SnoBotics981/CAD-FirstLibrary/README.md

# CAD-FirstLibrary
Part files retrieved from FIRST CAD library.
