SnoBotics981/CAD-FirstLibrary/Electrical/2004_RC/INV/Robot Controller Decal.bmp

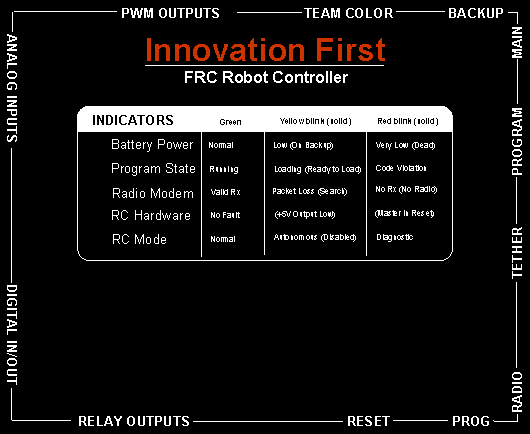
Electrical/2004_RC/INV/Robot Controller Decal.bmp
