SnoBotics981/CAD-FirstLibrary/Electrical/2005_RC/INV/Robot Controller.BMP

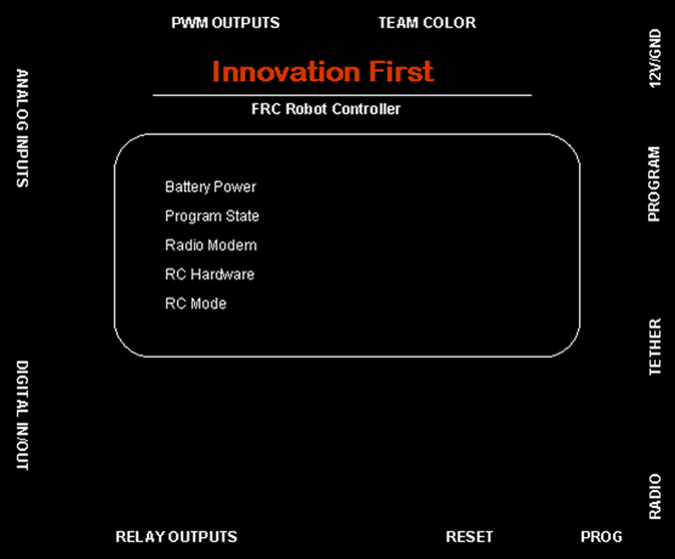
Electrical/2005_RC/INV/Robot Controller.BMP
