SnoBotics981/CAD-FirstLibrary/Electrical/Battery_Terminal/STEP/Battery Terminal Assembly.stp

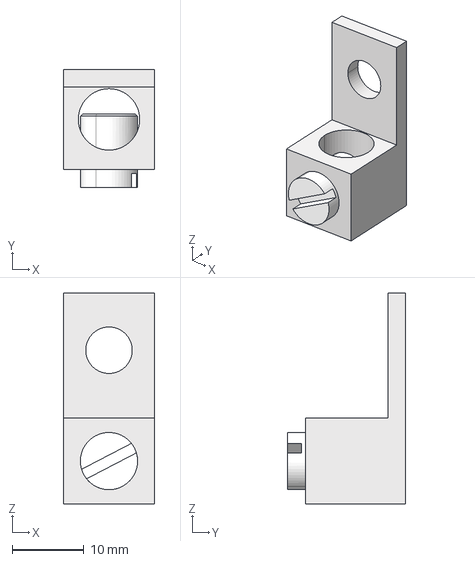
[picture p3: CAD file, 2018-06-28]
Electrical/Battery_Terminal/STEP/Battery Terminal Assembly.stp
12.8 x 16.5 x 29.5 mm
Battery Terminal
Battery Terminal Screw
