SnoBotics981/CAD-FirstLibrary/Mechanical/Linear_Slide/STEP/Drylin_N27_Assy.stp

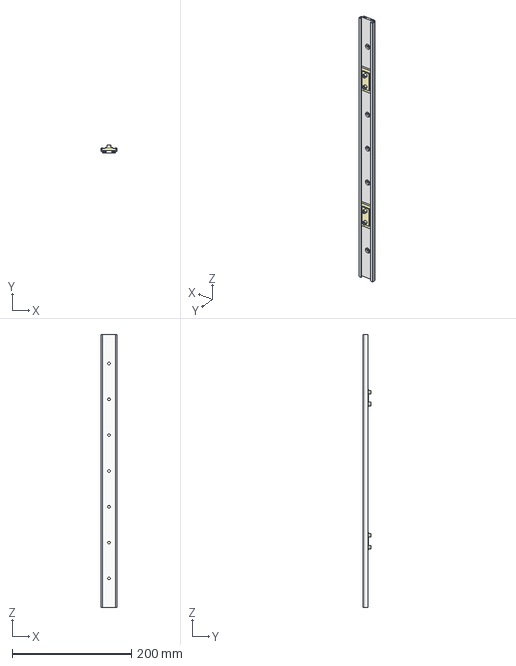
[picture p5: CAD file, 2018-06-28]
Mechanical/Linear_Slide/STEP/Drylin_N27_Assy.stp
27.0 x 13.9 x 457.2 mm
DryLin_N27_Rail
Drylin_N27_Slide x 2
