SnoBotics981/CAD-FirstLibrary/Pneumatic/Festo_Valve/STEP/Festo Valve Assembly.stp

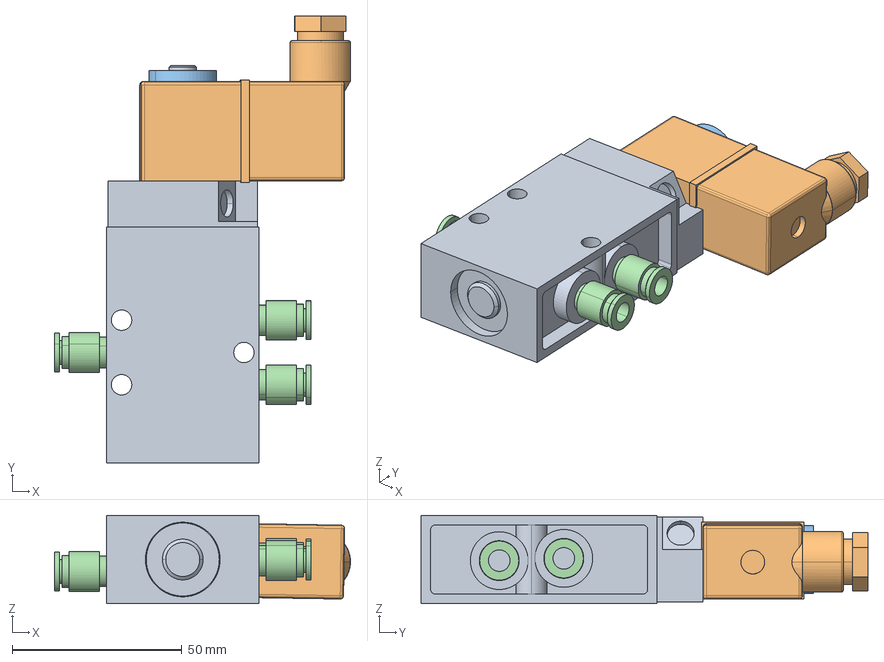
[picture p6: CAD file, 2018-06-28]
Pneumatic/Festo_Valve/STEP/Festo Valve Assembly.stp
87.1 x 131.5 x 26.0 mm
Festo Valve
Festo Solenoid
Festo Solenoid Nut
Festo Port Fitting x 3
