SnoBotics981/CAD-FirstLibrary/Bearings/1.2_Bearing/STEP/br-8.stp

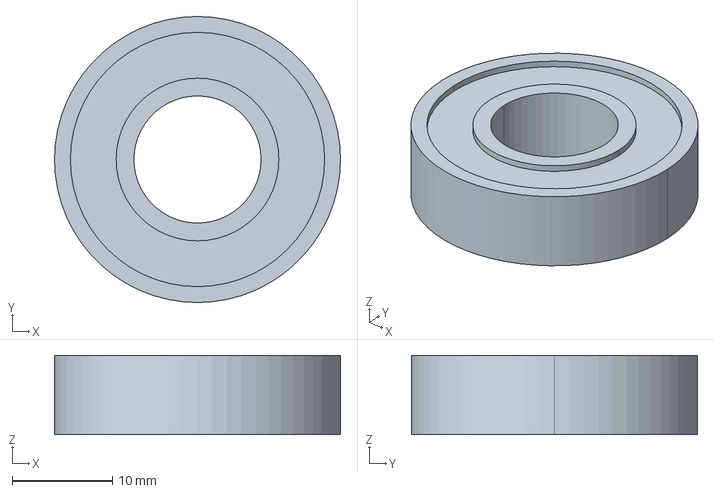
[picture p7: CAD file, 2018-06-28]
Bearings/1.2_Bearing/STEP/br-8.stp
28.6 x 28.6 x 7.94 mm
