SnoBotics981/CAD-FirstLibrary/Bearings/1.2_Flanged/STEP/brf-08.stp

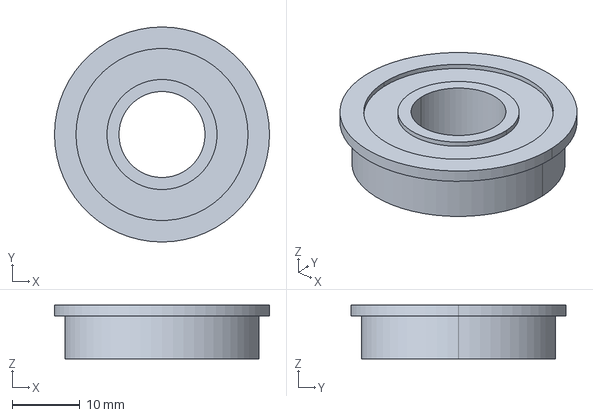
[picture p8: CAD file, 2018-06-28]
Bearings/1.2_Flanged/STEP/brf-08.stp
31.8 x 31.8 x 7.94 mm
