SnoBotics981/CAD-FirstLibrary/Bearings/1.2_Spherical/STEP/bearingspherical0500.stp

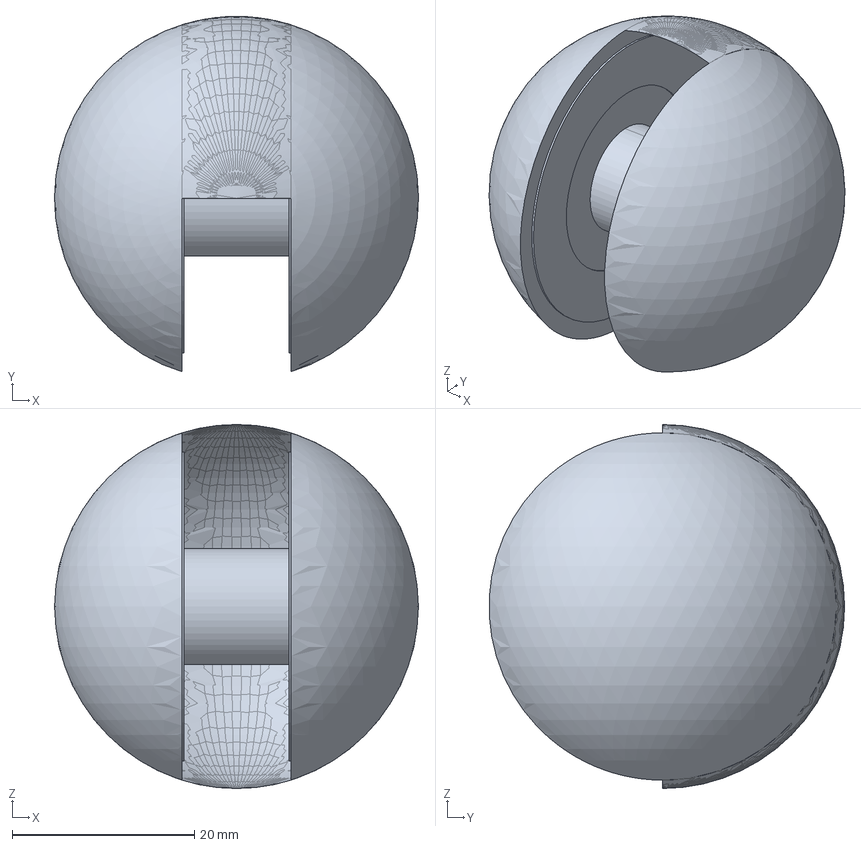
[picture p9: CAD file, 2018-06-28]
Bearings/1.2_Spherical/STEP/bearingspherical0500.stp
40.0 x 39.0 x 40.0 mm
