SnoBotics981/CAD-FirstLibrary/Bearings/1.4_Bearing/STEP/br-4.stp

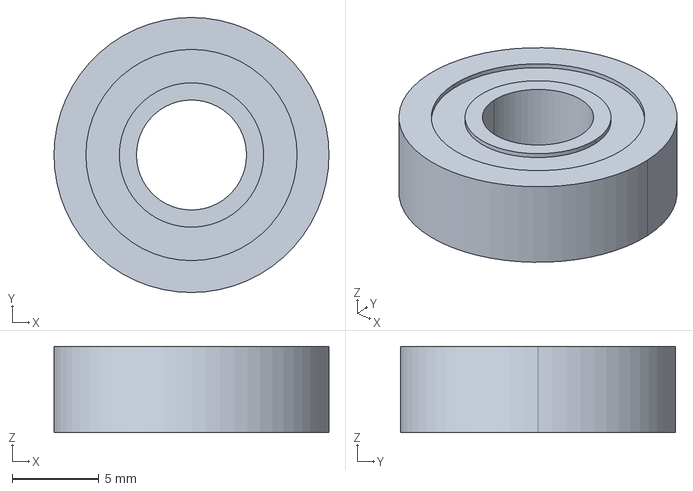
[picture p10: CAD file, 2018-06-28]
Bearings/1.4_Bearing/STEP/br-4.stp
15.9 x 15.9 x 4.98 mm
