SnoBotics981/CAD-FirstLibrary/Bearings/1.4_Flanged/STEP/brf-04.stp

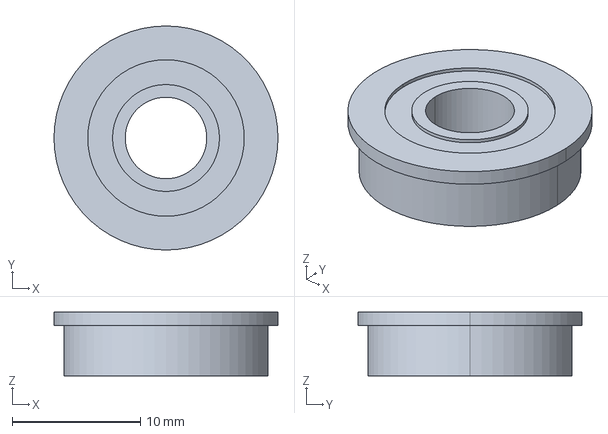
[picture p11: CAD file, 2018-06-28]
Bearings/1.4_Flanged/STEP/brf-04.stp
17.4 x 17.4 x 4.98 mm
