SnoBotics981/CAD-FirstLibrary/Bearings/12_Lazy_Susan/STEP/Lazy Susan Bearing.stp

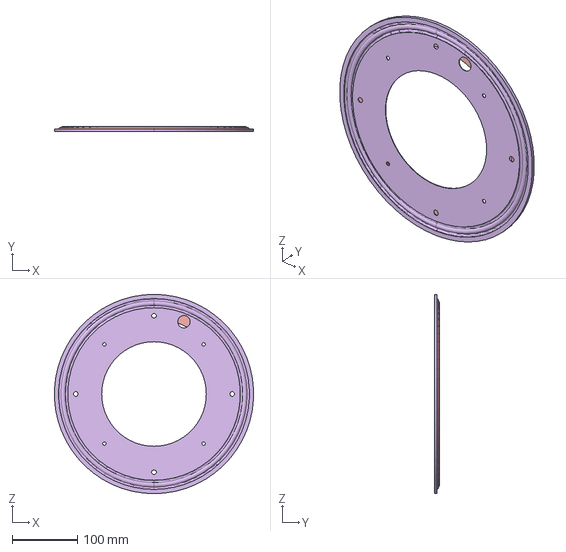
[picture p12: CAD file, 2018-06-28]
Bearings/12_Lazy_Susan/STEP/Lazy Susan Bearing.stp
306.0 x 7.95 x 306.4 mm
