SnoBotics981/CAD-FirstLibrary/Bearings/1_Bearing/STEP/RJI-01-16 Drylin R Bearing.stp

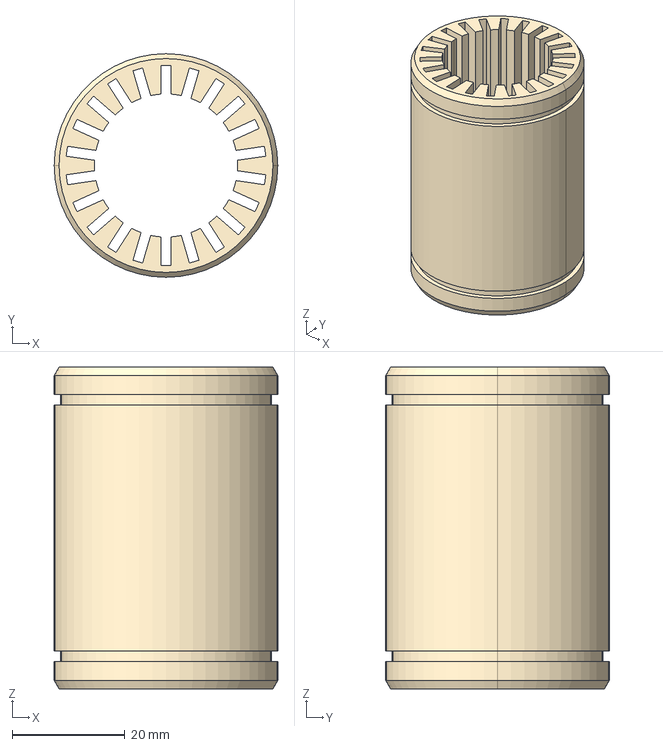
[picture p13: CAD file, 2018-06-28]
Bearings/1_Bearing/STEP/RJI-01-16 Drylin R Bearing.stp
39.7 x 39.7 x 57.2 mm
