SnoBotics981/CAD-FirstLibrary/Bearings/3.8_Bearing/STEP/br-6.stp

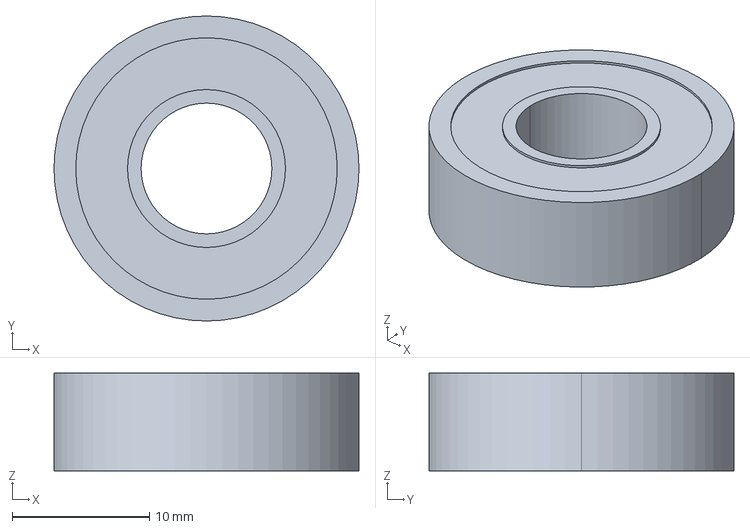
[picture p14: CAD file, 2018-06-28]
Bearings/3.8_Bearing/STEP/br-6.stp
22.2 x 22.2 x 7.11 mm
