SnoBotics981/CAD-FirstLibrary/Bearings/3.8_Flanged/STEP/brf-06.stp

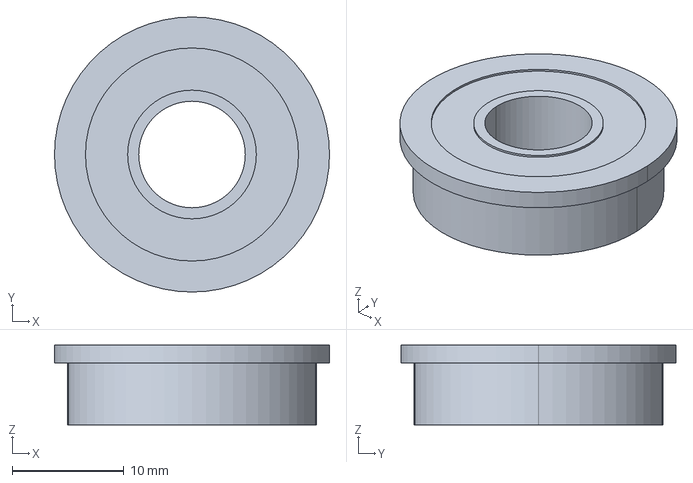
[picture p15: CAD file, 2018-06-28]
Bearings/3.8_Flanged/STEP/brf-06.stp
24.6 x 24.6 x 7.11 mm
