SnoBotics981/CAD-FirstLibrary/Bearings/5.8_Bearing/STEP/BR-10.stp

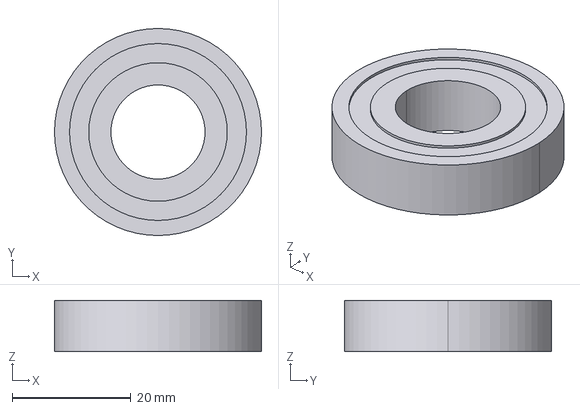
[picture p16: CAD file, 2018-06-28]
Bearings/5.8_Bearing/STEP/BR-10.stp
34.9 x 34.9 x 8.67 mm
