SnoBotics981/CAD-FirstLibrary/Bearings/Bearing_Flangette/STEP/selfaligningflange.stp

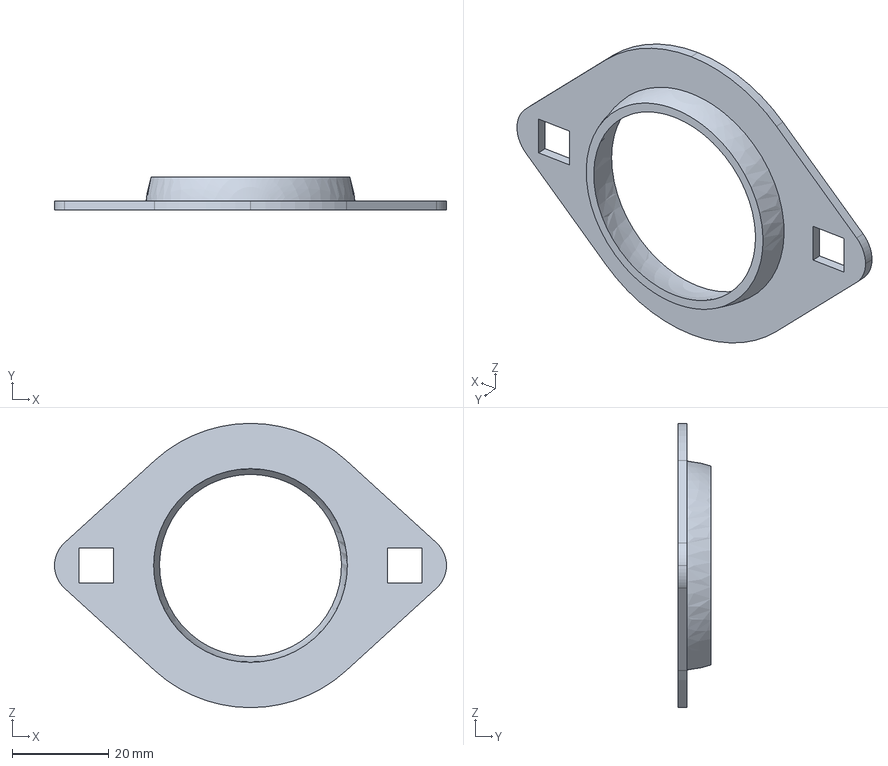
[picture p17: CAD file, 2018-06-28]
Bearings/Bearing_Flangette/STEP/selfaligningflange.stp
80.9 x 6.87 x 58.7 mm
