SnoBotics981/CAD-FirstLibrary/Bearings/Linear_Bearing_1.2/STEP/linearbearing.stp

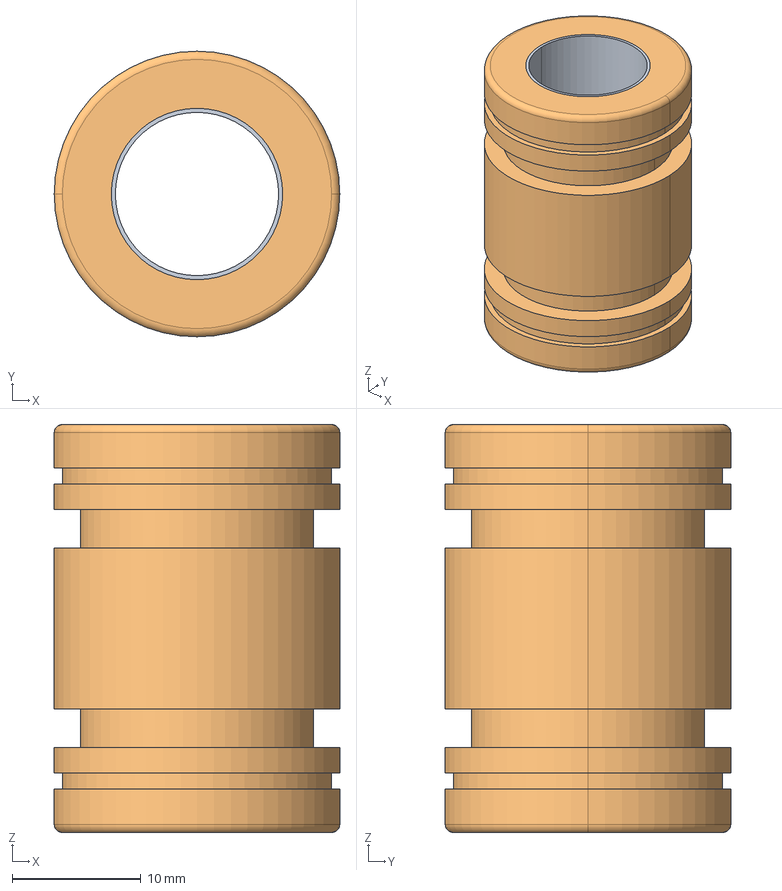
[picture p18: CAD file, 2018-06-28]
Bearings/Linear_Bearing_1.2/STEP/linearbearing.stp
22.2 x 22.2 x 31.8 mm
linearbearing1
linearbearing2
