SnoBotics981/CAD-FirstLibrary/Bearings/Locking_Collar/STEP/bearinglockingcollar.stp

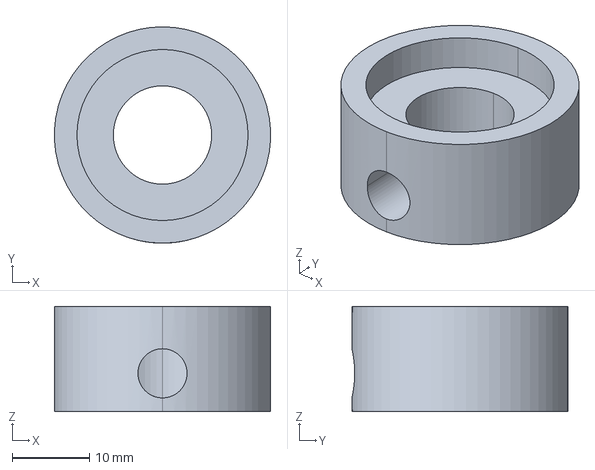
[picture p19: CAD file, 2018-06-28]
Bearings/Locking_Collar/STEP/bearinglockingcollar.stp
27.9 x 27.9 x 13.6 mm
