SnoBotics981/CAD-FirstLibrary/Bearings/Thrust_Bearing/STEP/Thrust Bearing.stp

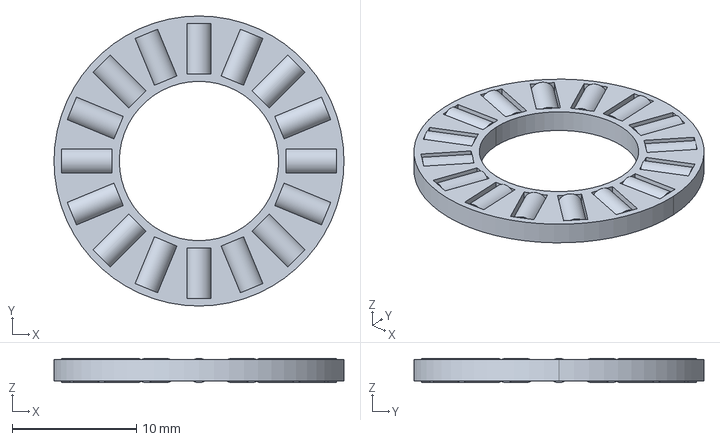
[picture p20: CAD file, 2018-06-28]
Bearings/Thrust_Bearing/STEP/Thrust Bearing.stp
23.3 x 23.3 x 1.95 mm
