SnoBotics981/CAD-FirstLibrary/Bushings/1_x_1_Bearing/STEP/JFI-1618-16 Iglide J Bearing.stp

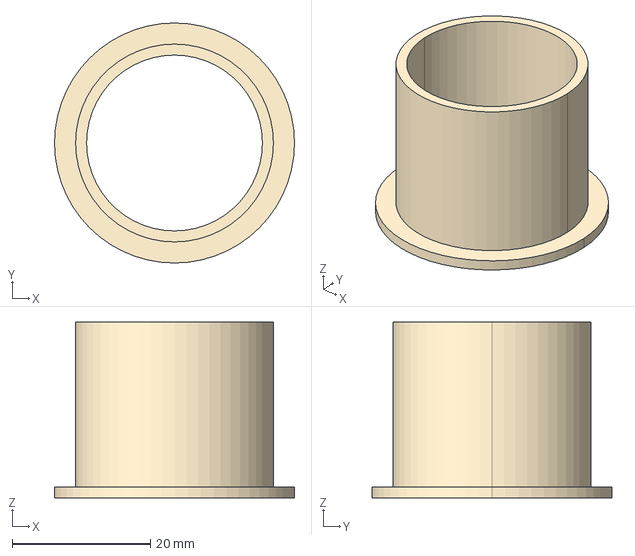
[picture p21: CAD file, 2018-06-28]
Bushings/1_x_1_Bearing/STEP/JFI-1618-16 Iglide J Bearing.stp
34.7 x 34.7 x 25.4 mm
