SnoBotics981/CAD-FirstLibrary/Bushings/1x_1_Bearing/STEP/JSI-1618-16 Iglide J Bearing.stp

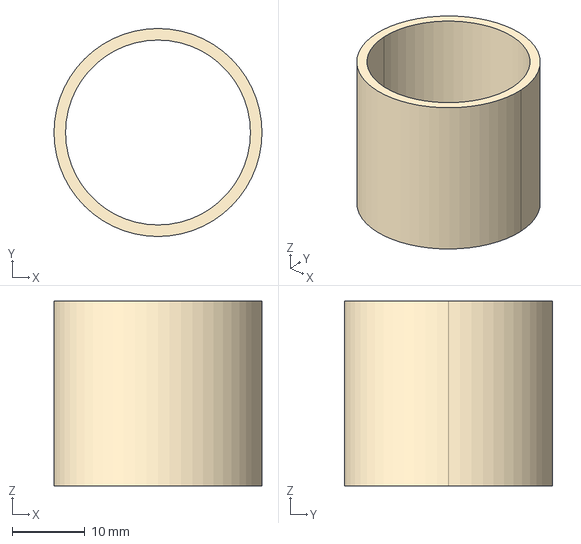
[picture p22: CAD file, 2018-06-28]
Bushings/1x_1_Bearing/STEP/JSI-1618-16 Iglide J Bearing.stp
28.6 x 28.6 x 25.4 mm
