SnoBotics981/CAD-FirstLibrary/Bushings/5.8x_3.4_Bearing/STEP/JFI-1012-12 Iglide J Bearing.stp

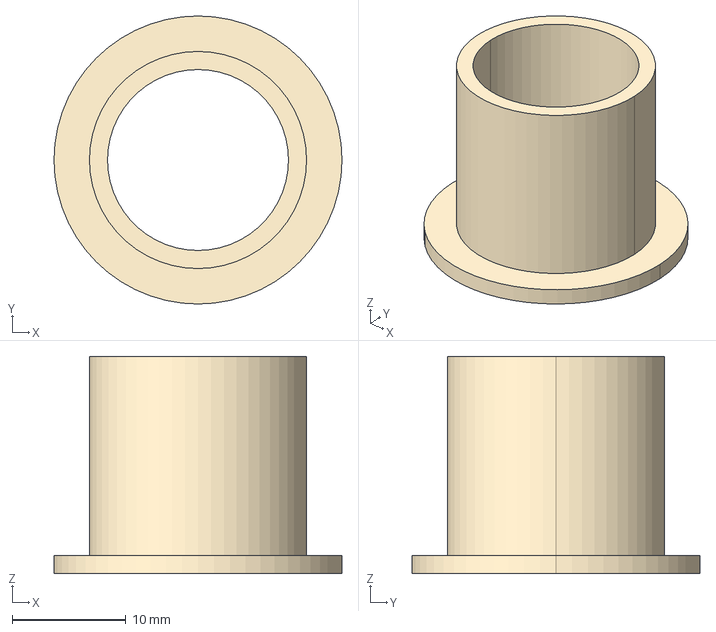
[picture p23: CAD file, 2018-06-28]
Bushings/5.8x_3.4_Bearing/STEP/JFI-1012-12 Iglide J Bearing.stp
25.3 x 25.3 x 19.1 mm
