SnoBotics981/CAD-FirstLibrary/Bushings/Flange_Bushing/STEP/bushing-fbb-8-12.stp

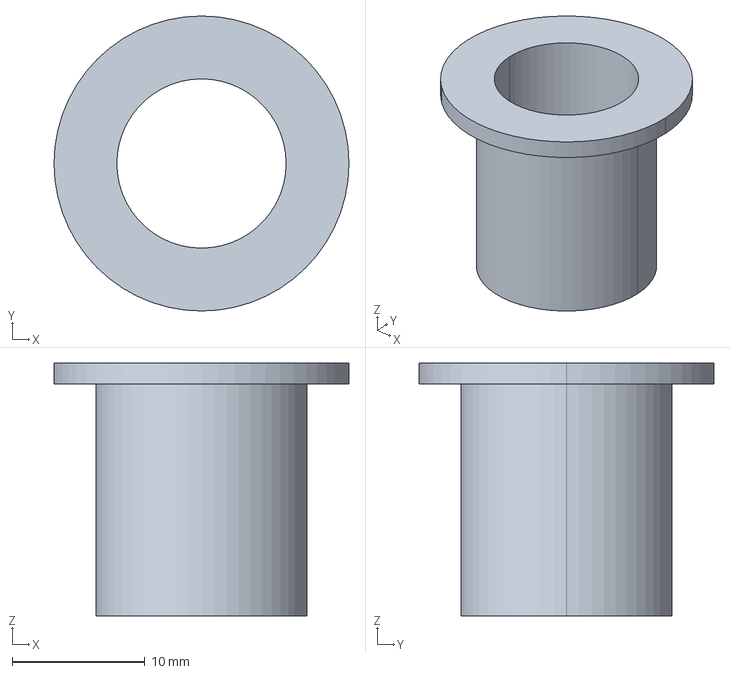
[picture p24: CAD file, 2018-06-28]
Bushings/Flange_Bushing/STEP/bushing-fbb-8-12.stp
22.2 x 22.2 x 19.1 mm
