SnoBotics981/CAD-FirstLibrary/Bushings/Rulon_J_Bushing/STEP/bushing-fbp-6-8.stp

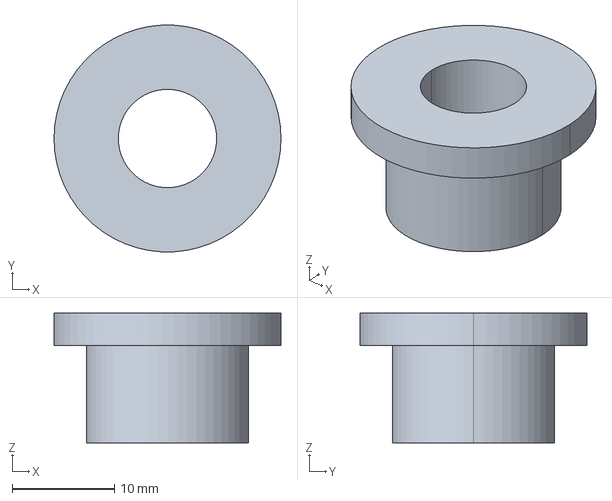
[picture p25: CAD file, 2018-06-28]
Bushings/Rulon_J_Bushing/STEP/bushing-fbp-6-8.stp
22.2 x 22.2 x 12.7 mm
