SnoBotics981/CAD-FirstLibrary/Bushings/Thrust_Bushing/STEP/bushing-tbb-8-16.stp

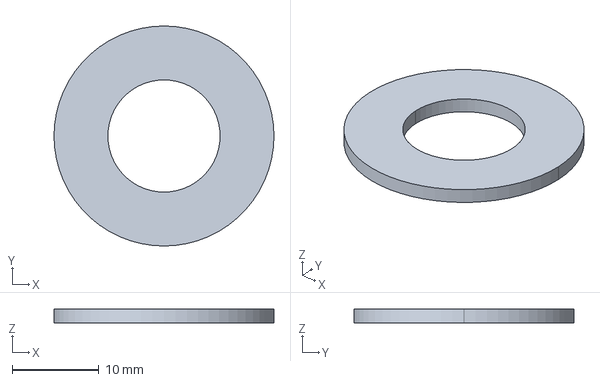
[picture p26: CAD file, 2018-06-28]
Bushings/Thrust_Bushing/STEP/bushing-tbb-8-16.stp
25.4 x 25.4 x 1.56 mm
