SnoBotics981/CAD-FirstLibrary/Electrical/10_Turn_Pot/STEP/Bourns3540.stp

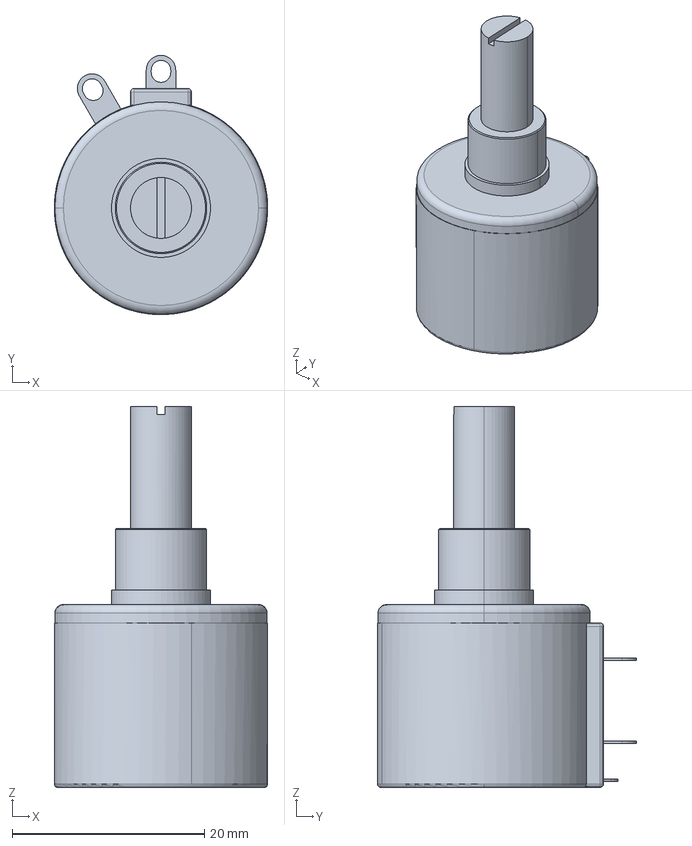
[picture p27: CAD file, 2018-06-28]
Electrical/10_Turn_Pot/STEP/Bourns3540.stp
22.2 x 27.0 x 39.7 mm
