SnoBotics981/CAD-FirstLibrary/Electrical/120A_Breaker/STEP/Breaker.stp

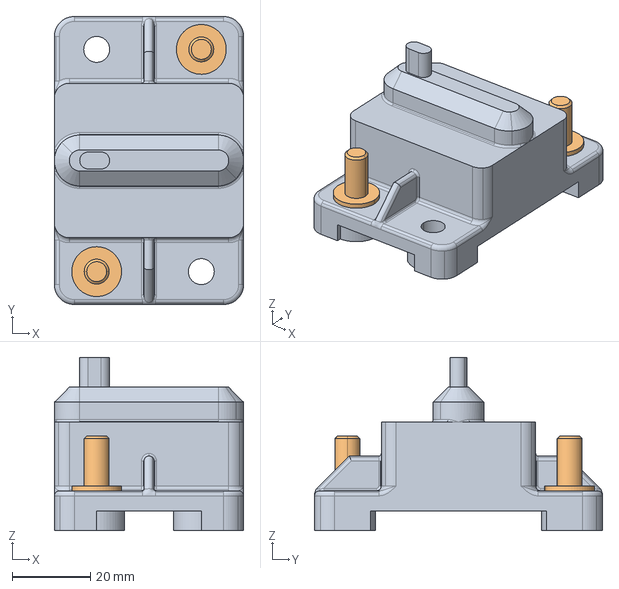
[picture p28: CAD file, 2018-06-28]
Electrical/120A_Breaker/STEP/Breaker.stp
48.3 x 73.4 x 44.2 mm
Breaker
Breaker Post x 2
