SnoBotics981/CAD-FirstLibrary/Electrical/14_Pin_IC_Socket/STEP/14 Pin IC Socket.stp

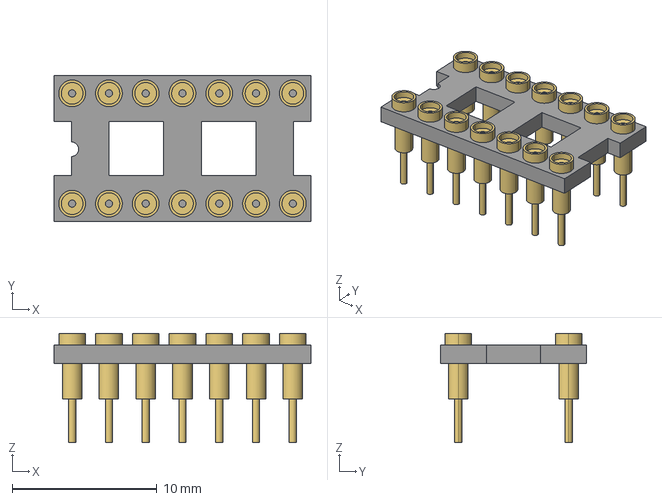
[picture p29: CAD file, 2018-06-28]
Electrical/14_Pin_IC_Socket/STEP/14 Pin IC Socket.stp
17.8 x 10.1 x 7.55 mm
14 Pin Socket Substrate
IC Socket Pin x 14
