SnoBotics981/CAD-FirstLibrary/Electrical/16_Pin_IC_Socket/STEP/16 Pin IC Socket.stp

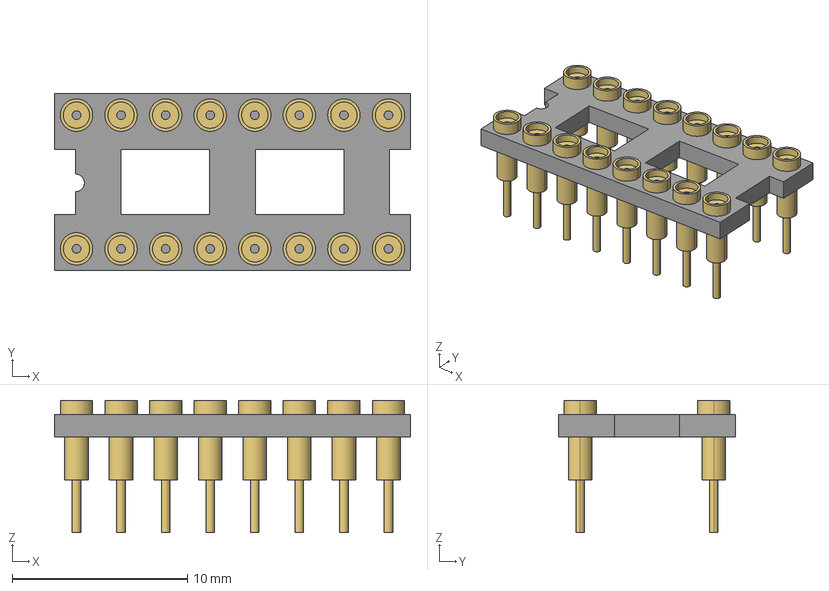
[picture p30: CAD file, 2018-06-28]
Electrical/16_Pin_IC_Socket/STEP/16 Pin IC Socket.stp
20.3 x 10.1 x 7.55 mm
16 Pin Socket Substrate
IC Socket Pin x 16
