SnoBotics981/CAD-FirstLibrary/Electrical/18_Pin_IC_Socket/STEP/18 Pin IC Socket.stp

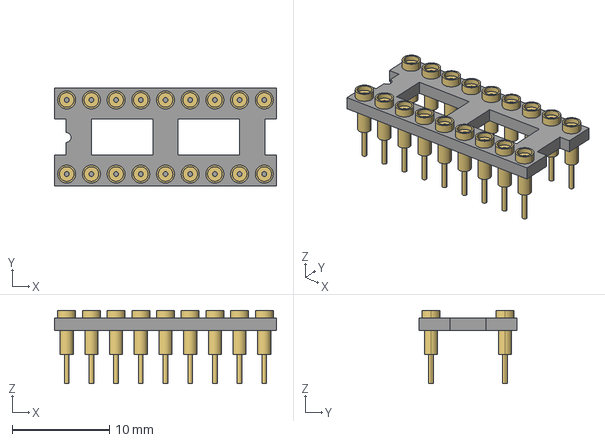
[picture p31: CAD file, 2018-06-28]
Electrical/18_Pin_IC_Socket/STEP/18 Pin IC Socket.stp
22.8 x 10.1 x 7.55 mm
18 Pin Socket Substrate
IC Socket Pin x 18
