SnoBotics981/CAD-FirstLibrary/Electrical/2005_OI/STEP/Operator Interface.stp

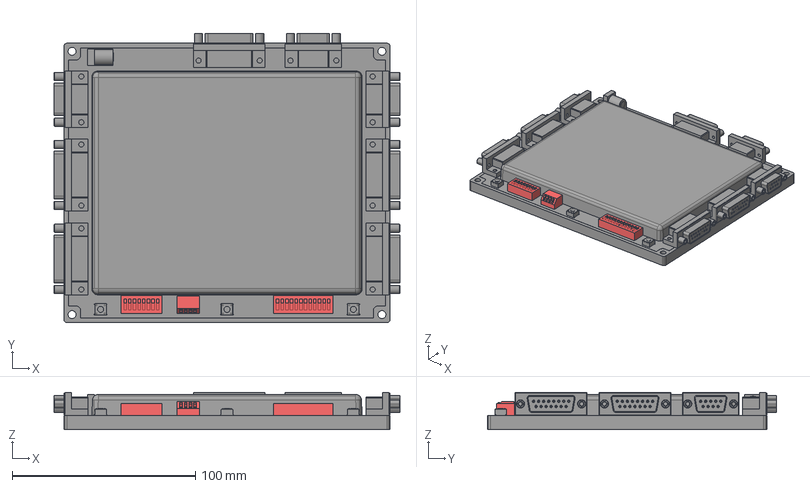
[picture p33: CAD file, 2018-06-28]
Electrical/2005_OI/STEP/Operator Interface.stp
188.6 x 157.8 x 20.3 mm
Operator Interface Back Cover
Operator Interface PCB
Operator Interface Top Cover
8 Position DIP Switch
12 Position DIP Switch
Operator Interface 15F Dshell x 5
Operator Interface 9F Dshell x 2
Operator Interface 9M Dshell
PCB PB Switch x 3
4 Position Dip Switch
Operator Interface Power Connector
