SnoBotics981/CAD-FirstLibrary/Electrical/2005_RC/STEP/Robot Controller.stp

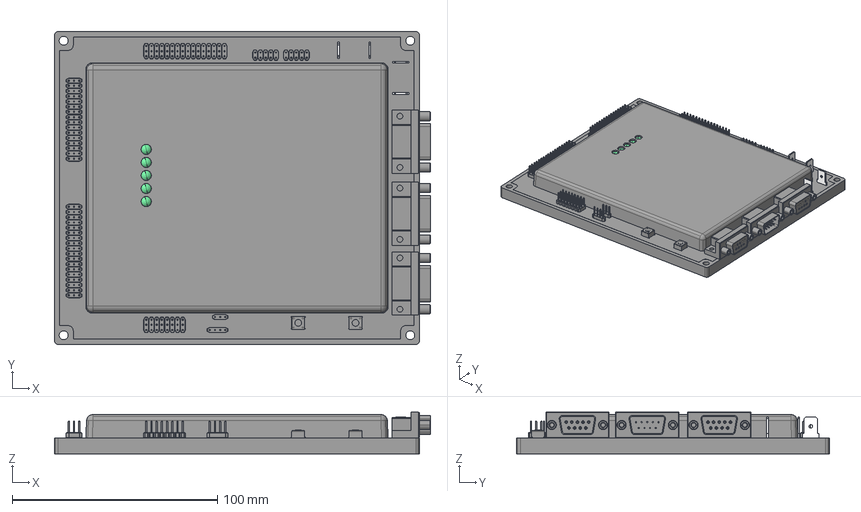
[picture p34: CAD file, 2018-06-28]
Electrical/2005_RC/STEP/Robot Controller.stp
183.2 x 152.4 x 20.3 mm
Robot Controller Back Cover
Robot Controller PCB
4 Pin Connector
Robot Controller Top Cover
Robot Controller 9F Dshell x 2
Robot Controller 9M Dshell
3 Pin Connector x 59
2 Pin Connector x 10
PCB PB Switch x 2
LED - Green x 5
Robot Controller Male Terminal x 4
