SnoBotics981/CAD-FirstLibrary/Electrical/2005_Spike_Relay/STEP/Spike H.stp

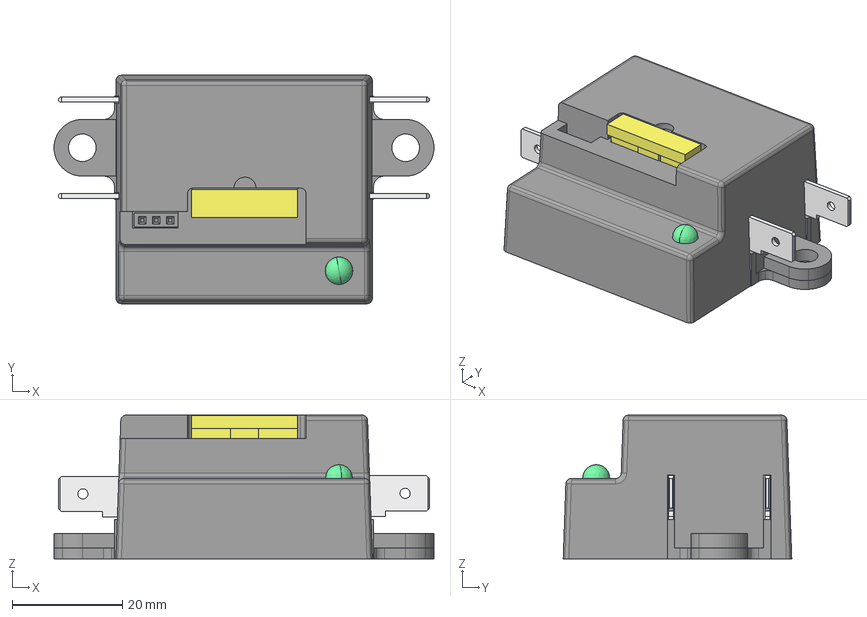
[picture p35: CAD file, 2018-06-28]
Electrical/2005_Spike_Relay/STEP/Spike H.stp
69.0 x 41.5 x 26.1 mm
Spike Bottom Cover
Spike PCB
Spike Female Terminal x 2
1x3 Header Connector
Spike Male Terminal x 4
ATO Fuse
Spike Top Cover
LED - Green
