SnoBotics981/CAD-FirstLibrary/Electrical/2008_IR_Board/STEP/2008 IR Board.stp

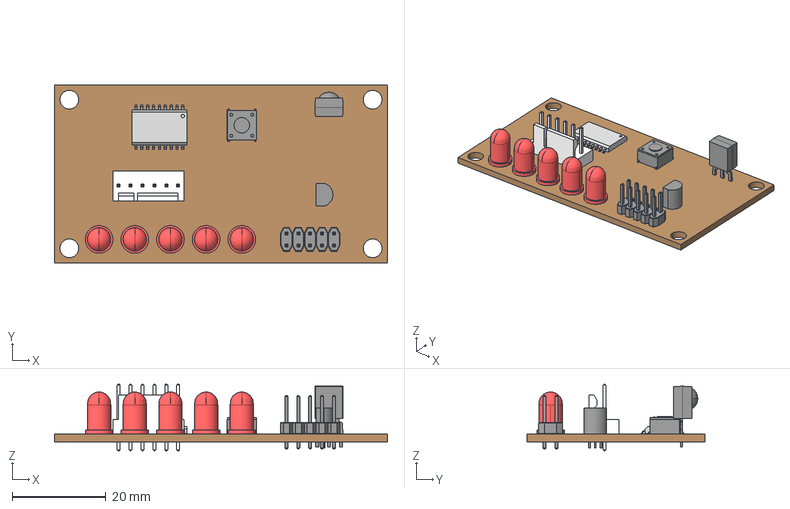
[picture p36: CAD file, 2018-06-28]
Electrical/2008_IR_Board/STEP/2008 IR Board.stp
71.1 x 38.1 x 14.2 mm
2008 IR PC Board
LED - Red x 5
2 Pin Connector x 5
PCB PB Switch
18 Pin SMT
6 Pin Connector
Vishay IR Sensor
5 Volt Regulator
