SnoBotics981/CAD-FirstLibrary/Electrical/20_Pin_IC_Socket/STEP/20 Pin IC Socket.stp

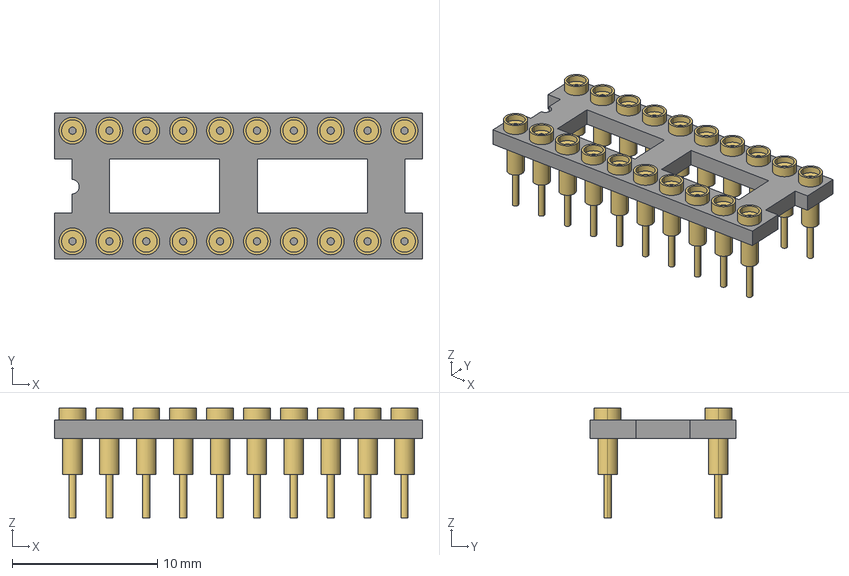
[picture p37: CAD file, 2018-06-28]
Electrical/20_Pin_IC_Socket/STEP/20 Pin IC Socket.stp
25.3 x 10.1 x 7.55 mm
20 Pin Socket Substrate
IC Socket Pin x 20
