SnoBotics981/CAD-FirstLibrary/Electrical/24_Pin_IC_Socket/STEP/24 Pin IC Socket.stp

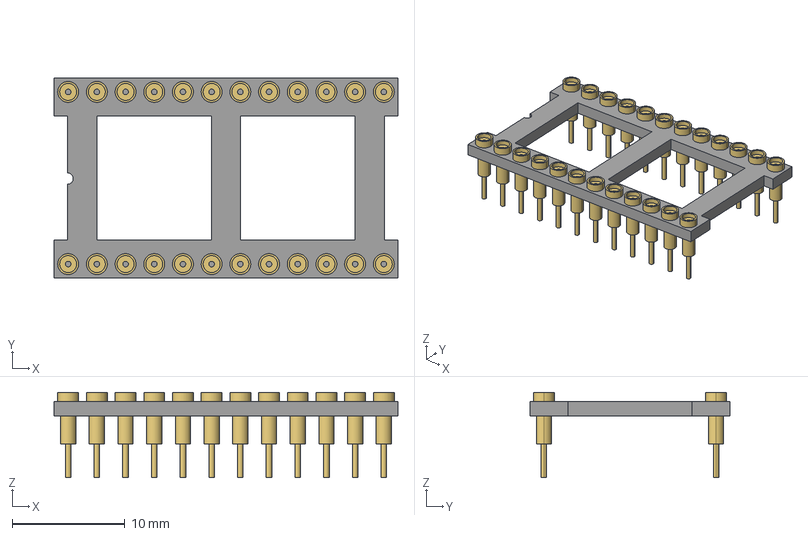
[picture p38: CAD file, 2018-06-28]
Electrical/24_Pin_IC_Socket/STEP/24 Pin IC Socket.stp
30.5 x 17.7 x 7.55 mm
24 Pin Socket Substrate
IC Socket Pin x 24
