SnoBotics981/CAD-FirstLibrary/Electrical/28_Pin_IC_Socket/STEP/28 Pin IC Socket.stp

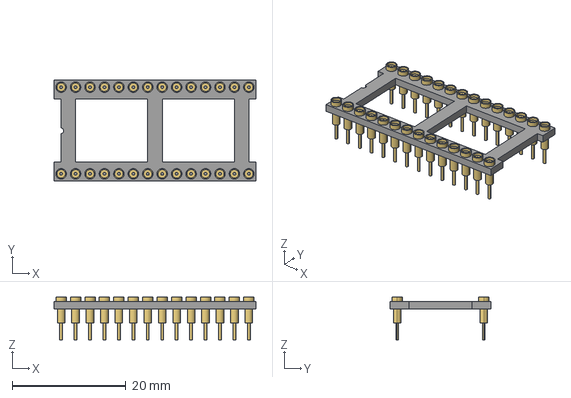
[picture p39: CAD file, 2018-06-28]
Electrical/28_Pin_IC_Socket/STEP/28 Pin IC Socket.stp
35.5 x 17.7 x 7.55 mm
28 Pin Socket Substrate
IC Socket Pin x 28
