SnoBotics981/CAD-FirstLibrary/Electrical/37_Pin_Connector/STEP/37 Pin Connector.stp

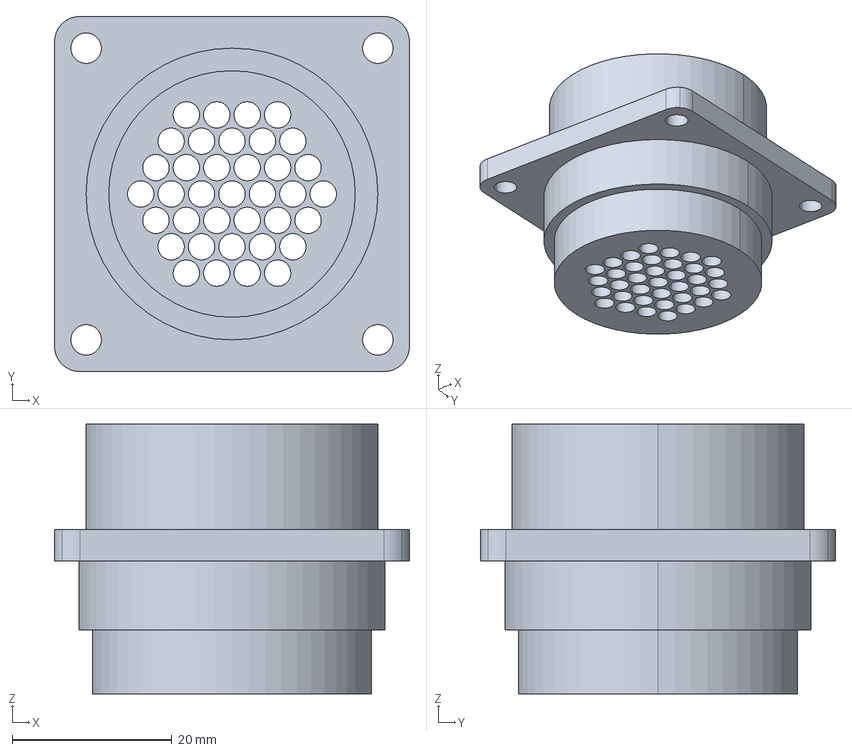
[picture p40: CAD file, 2018-06-28]
Electrical/37_Pin_Connector/STEP/37 Pin Connector.stp
44.5 x 44.5 x 33.8 mm
