SnoBotics981/CAD-FirstLibrary/Electrical/3_Pin_Connector/STEP/3 Pin Connector.stp

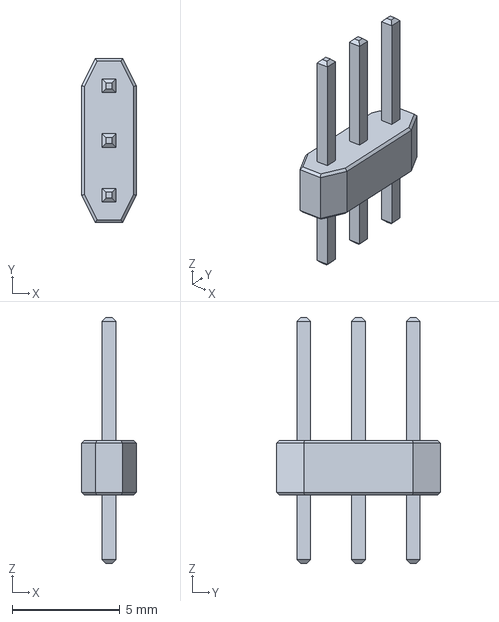
[picture p41: CAD file, 2018-06-28]
Electrical/3_Pin_Connector/STEP/3 Pin Connector.stp
2.54 x 7.62 x 11.4 mm
