SnoBotics981/CAD-FirstLibrary/Electrical/3x2x1_Box/STEP/Enclosure1801.stp

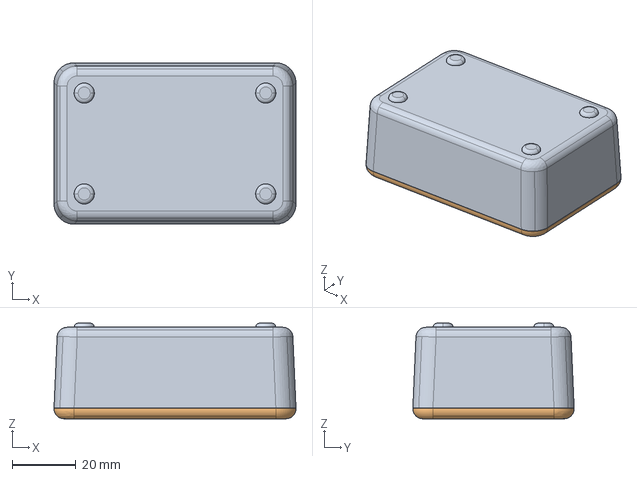
[picture p42: CAD file, 2018-06-28]
Electrical/3x2x1_Box/STEP/Enclosure1801.stp
76.2 x 50.8 x 30.1 mm
Enclosure1801
Enclosure1801-Cover
