SnoBotics981/CAD-FirstLibrary/Electrical/4x2x1_Box/STEP/Enclosure1802.stp

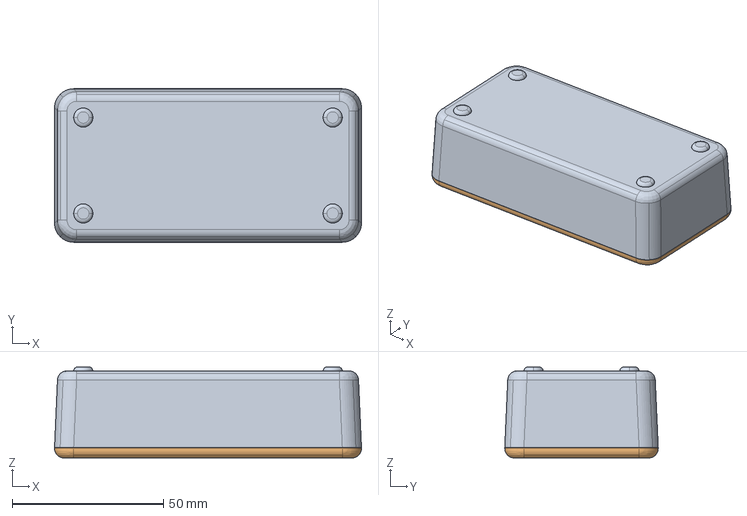
[picture p43: CAD file, 2018-06-28]
Electrical/4x2x1_Box/STEP/Enclosure1802.stp
101.6 x 50.8 x 30.1 mm
Enclosure1802
Enclosure1802-Cover
