SnoBotics981/CAD-FirstLibrary/Electrical/5x2.5x2_Box/STEP/Enclosure1803.stp

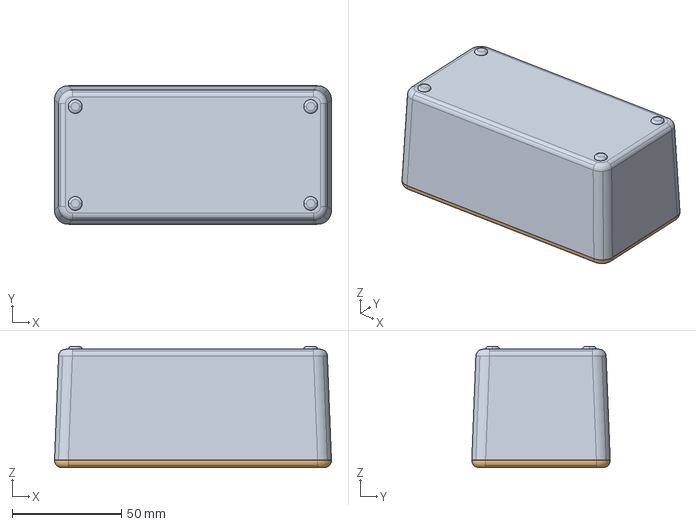
[picture p44: CAD file, 2018-06-28]
Electrical/5x2.5x2_Box/STEP/Enclosure1803.stp
127.0 x 63.5 x 55.5 mm
Enclosure1803
Enclosure1803-Cover
