SnoBotics981/CAD-FirstLibrary/Electrical/Accelerometer/STEP/Accelerometer.stp

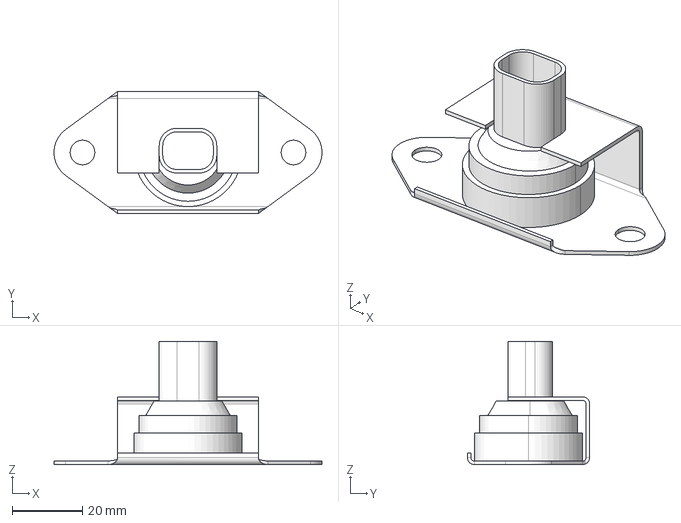
[picture p45: CAD file, 2018-06-28]
Electrical/Accelerometer/STEP/Accelerometer.stp
76.2 x 34.8 x 35.0 mm
