SnoBotics981/CAD-FirstLibrary/Electrical/ATO_Fuse/STEP/ATO Fuse.stp

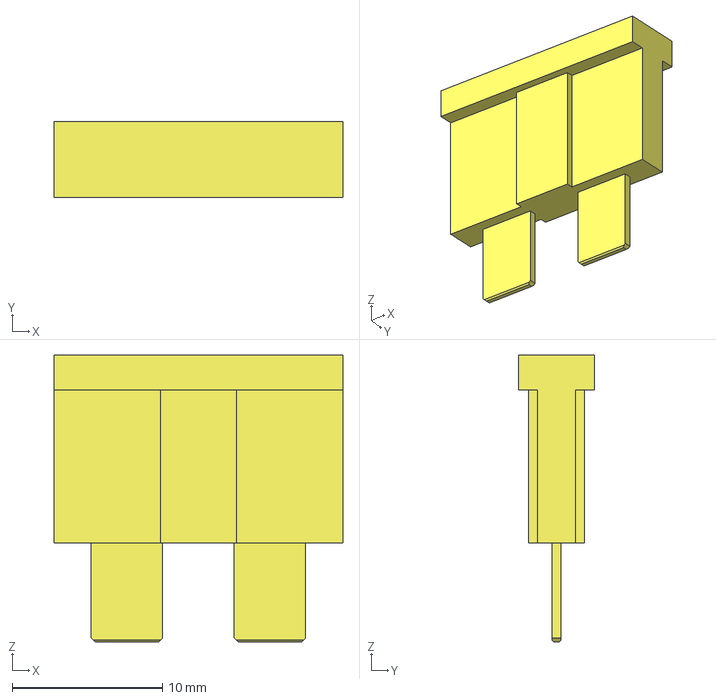
[picture p46: CAD file, 2018-06-28]
Electrical/ATO_Fuse/STEP/ATO Fuse.stp
19.2 x 5.08 x 19.1 mm
