SnoBotics981/CAD-FirstLibrary/Electrical/Battery/STEP/battery.stp

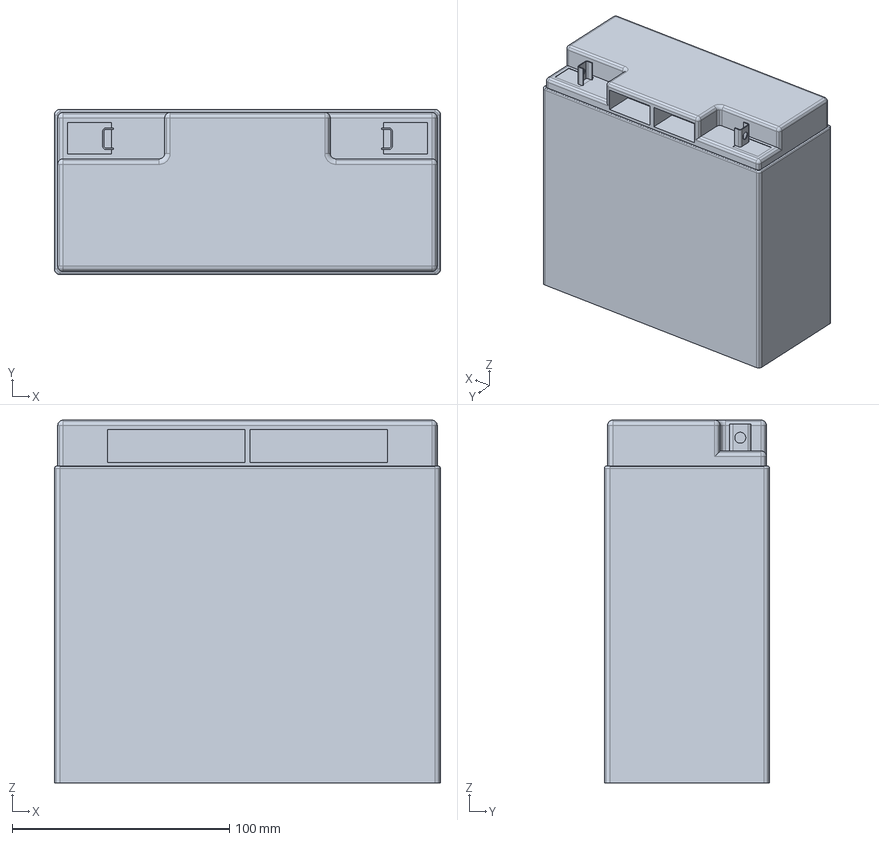
[picture p47: CAD file, 2018-06-28]
Electrical/Battery/STEP/battery.stp
177.8 x 76.2 x 167.1 mm
