SnoBotics981/CAD-FirstLibrary/Electrical/Circuit_Breaker/STEP/Circuit Breaker.stp

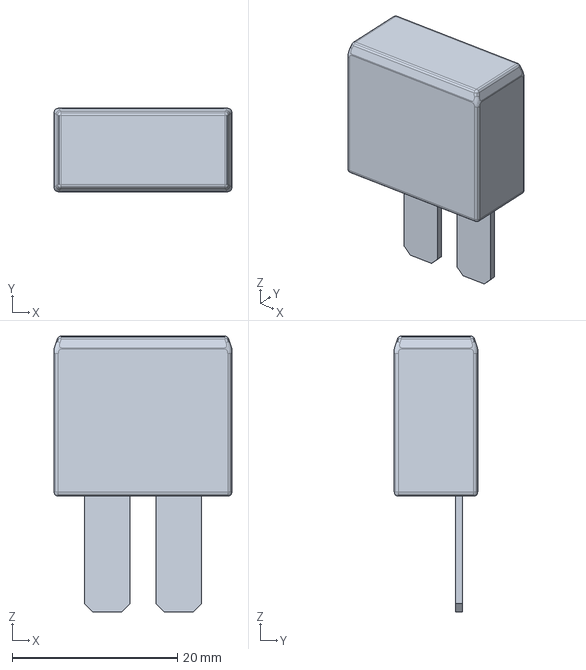
[picture p49: CAD file, 2018-06-28]
Electrical/Circuit_Breaker/STEP/Circuit Breaker.stp
21.5 x 10.1 x 33.4 mm
