SnoBotics981/CAD-FirstLibrary/Electrical/CMU_Camera/STEP/CMU Camera.stp

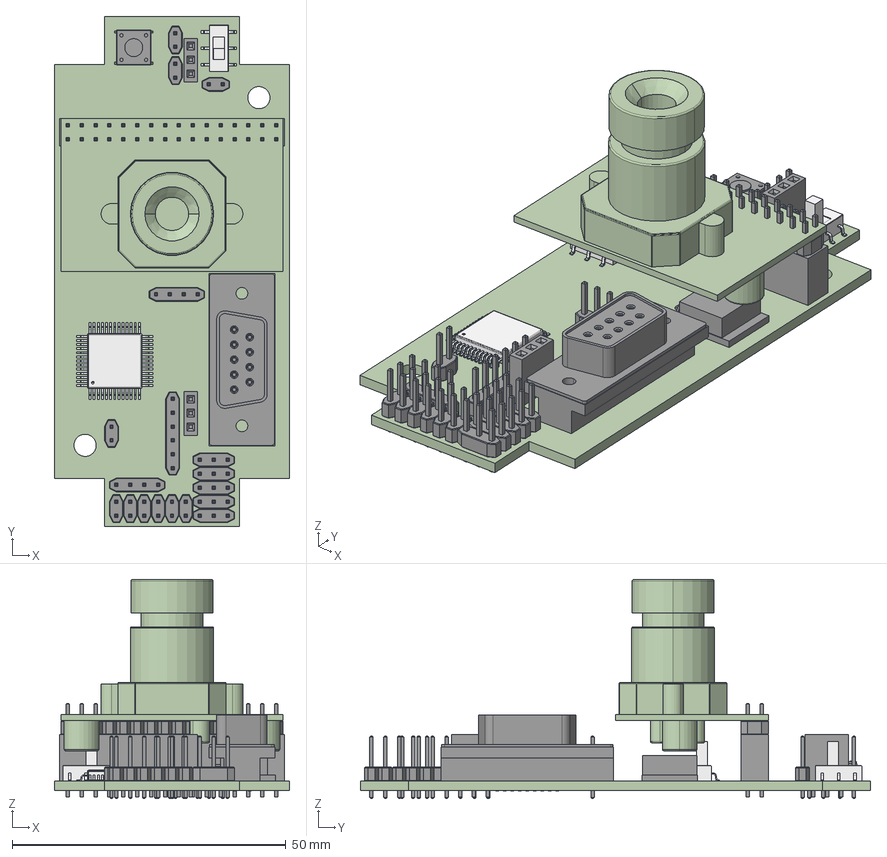
[picture p50: CAD file, 2018-06-28]
Electrical/CMU_Camera/STEP/CMU Camera.stp
42.9 x 93.2 x 40.0 mm
CMU Camera PCB
2x16 Header Connector
Lens Module
2 Pin Connector x 26
PCB PB Switch
4 Pin Connector x 2
3 Pin Connector x 5
Voltage Regulator
CMU Camera 9F Dshell
1x3 Header Connector x 2
6 Pin Connector
28 Pin IC
CPU
Slide Switch
