SnoBotics981/CAD-FirstLibrary/Electrical/DEC_Gyro_Sensor/STEP/Gyro Sensor.stp

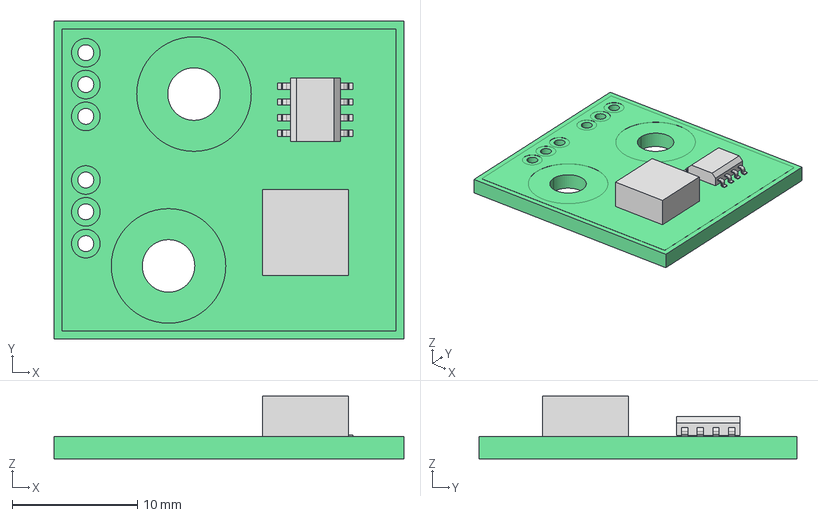
[picture p51: CAD file, 2018-06-28]
Electrical/DEC_Gyro_Sensor/STEP/Gyro Sensor.stp
27.9 x 25.4 x 5.03 mm
Gyro PCB
Gyro Chip
8 Pin SMT
