SnoBotics981/CAD-FirstLibrary/Electrical/Dual_Clinometer/STEP/Clinometer.stp

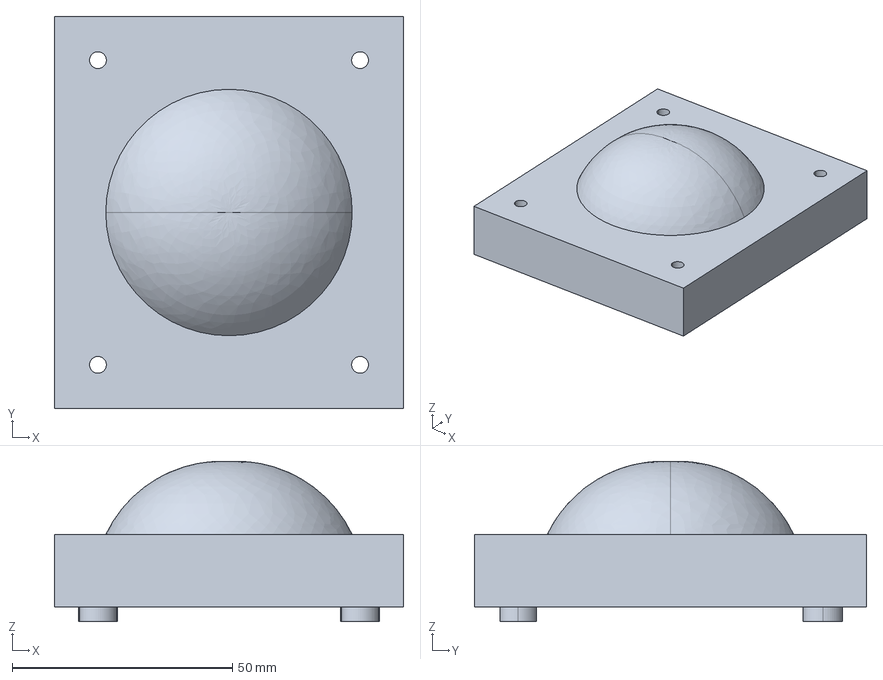
[picture p52: CAD file, 2018-06-28]
Electrical/Dual_Clinometer/STEP/Clinometer.stp
79.2 x 88.9 x 36.4 mm
