SnoBotics981/CAD-FirstLibrary/Electrical/Grayhill_Encoder/STEP/Encoder.stp

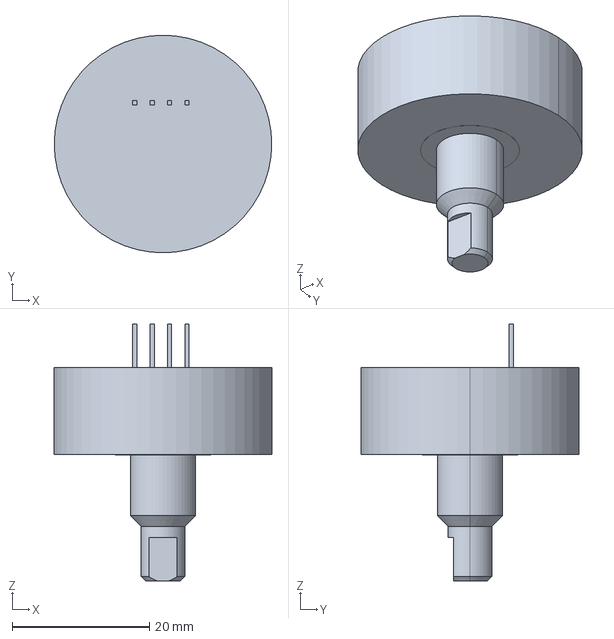
[picture p53: CAD file, 2018-06-28]
Electrical/Grayhill_Encoder/STEP/Encoder.stp
31.8 x 31.8 x 37.5 mm
