SnoBotics981/CAD-FirstLibrary/Electrical/Ground_Terminal/STEP/Ground Terminal.stp

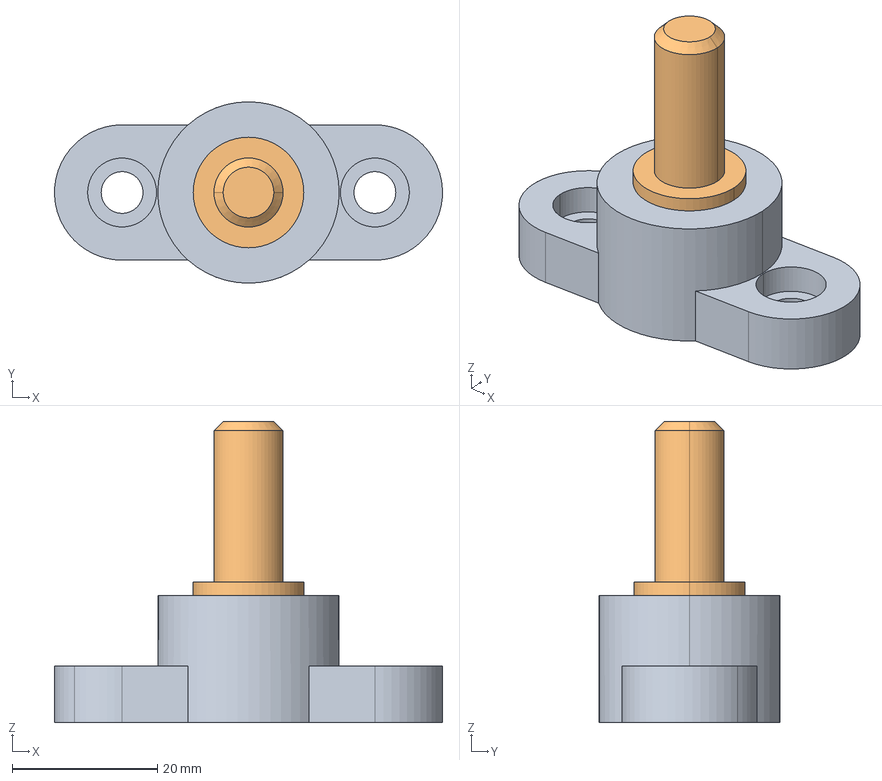
[picture p54: CAD file, 2018-06-28]
Electrical/Ground_Terminal/STEP/Ground Terminal.stp
53.5 x 25.0 x 41.5 mm
Ground Terminal Base
Ground Terminal Stud
