SnoBotics981/CAD-FirstLibrary/Electrical/Gyro_Chip/STEP/gyrochip.stp

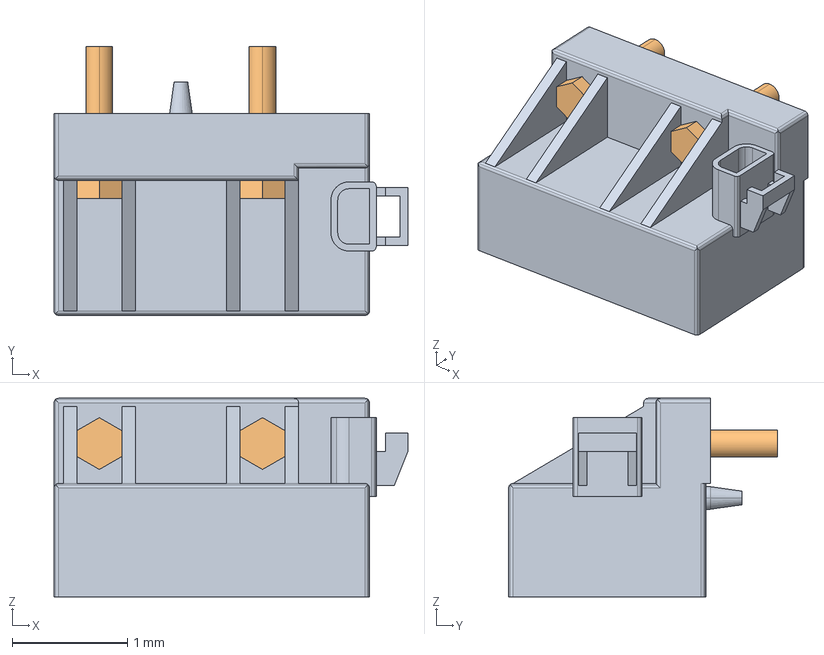
[picture p55: CAD file, 2018-06-28]
Electrical/Gyro_Chip/STEP/gyrochip.stp
3.08 x 2.34 x 1.73 mm
GyroChip1
GyroChip2 x 2
