SnoBotics981/CAD-FirstLibrary/Electrical/Hitec_Servo/STEP/Hitec Servo.stp

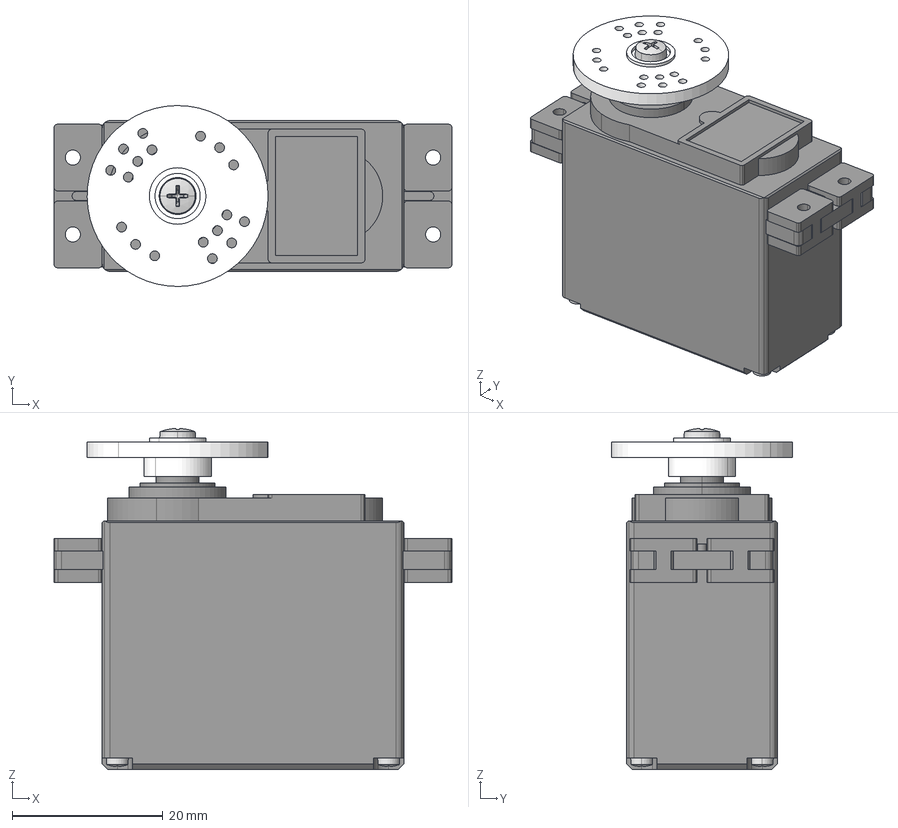
[picture p56: CAD file, 2018-06-28]
Electrical/Hitec_Servo/STEP/Hitec Servo.stp
52.8 x 24.0 x 45.2 mm
Hitec Servo
Servo Screw x 4
Servo Horn
Servo Isolation Mounts x 4
Screw2
