SnoBotics981/CAD-FirstLibrary/Electrical/IFI_OI_Transmitter/STEP/IFI OI Transmitter.stp

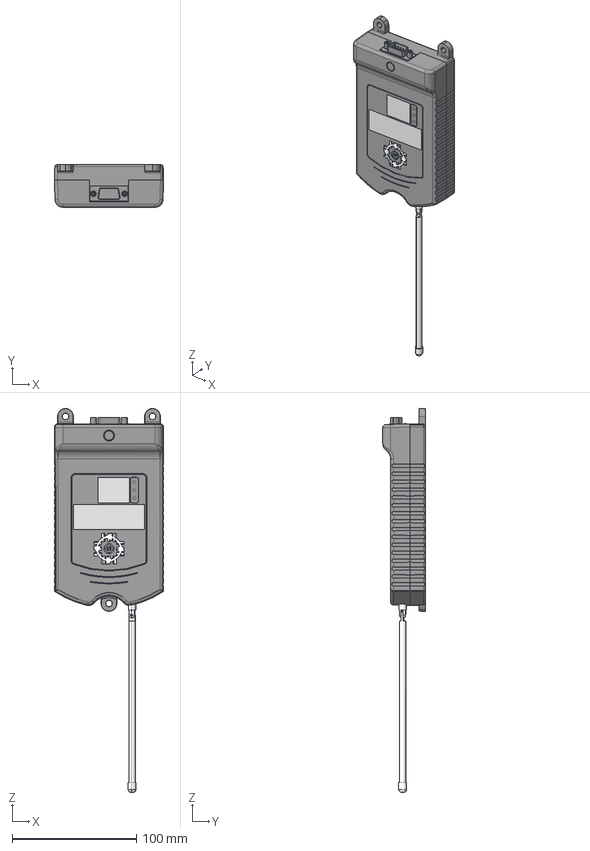
[picture p57: CAD file, 2018-06-28]
Electrical/IFI_OI_Transmitter/STEP/IFI OI Transmitter.stp
87.7 x 34.2 x 308.7 mm
RADIO-2007-COVER Rev3a
90048A117 x 4
RADIO-2007-SLAVE-PCB
RADIO-2007-MASTER-PCB
9M Dshell
RADIO-2007-BASE Rev4
Antenna Base
Antenna
RADIO-2007-LED-DECAL Rev1
IFI Logo
OI Transmitter Decal1
OI Transmitter Decal2
