SnoBotics981/CAD-FirstLibrary/Electrical/Knob/STEP/knob.stp

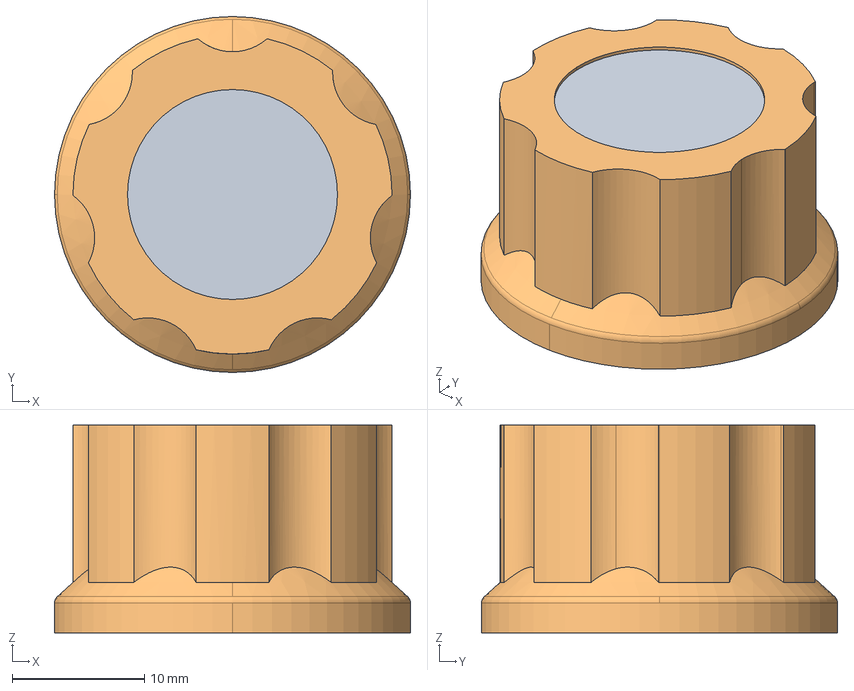
[picture p58: CAD file, 2018-06-28]
Electrical/Knob/STEP/knob.stp
26.9 x 26.9 x 15.7 mm
knob1
knob2
