SnoBotics981/CAD-FirstLibrary/Electrical/Large_Panel/STEP/fusepanel2.stp

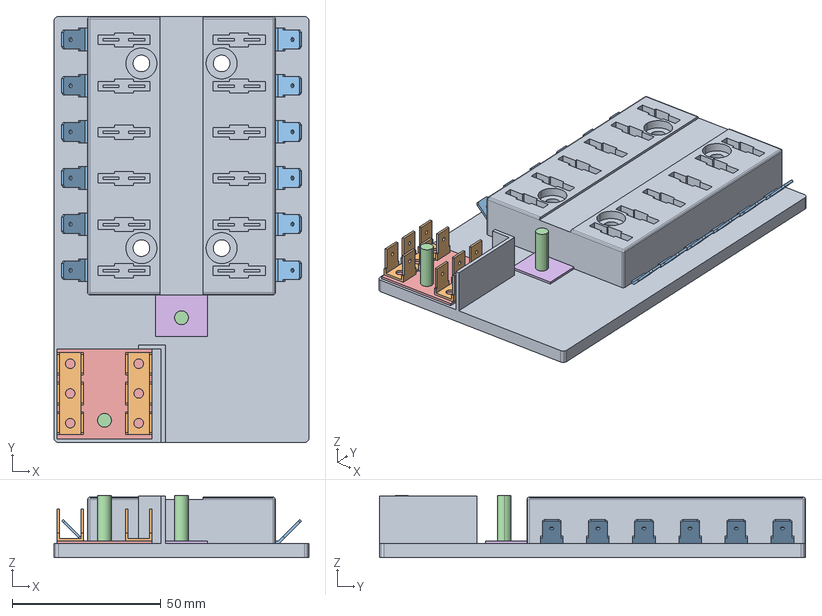
[picture p59: CAD file, 2018-06-28]
Electrical/Large_Panel/STEP/fusepanel2.stp
85.6 x 143.0 x 20.9 mm
fusepanel2-1
fusepanel2-3 x 2
fusepanel2-4 x 12
fusepanel2-5 x 2
fusepanel2-7
fusepanel2-8
