SnoBotics981/CAD-FirstLibrary/Electrical/LED/STEP/led.stp

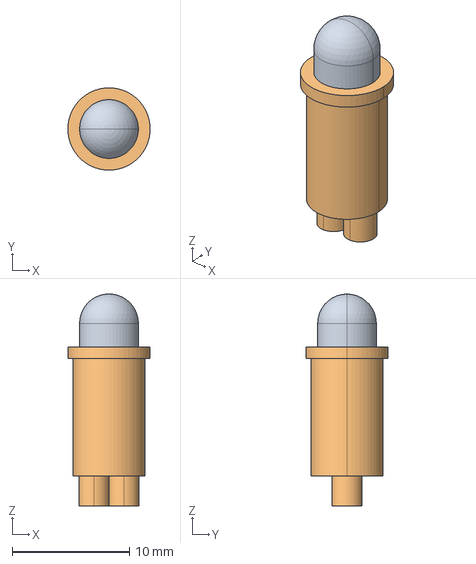
[picture p60: CAD file, 2018-06-28]
Electrical/LED/STEP/led.stp
7.01 x 7.01 x 18.0 mm
led1
led2
