SnoBotics981/CAD-FirstLibrary/Electrical/Limit_Switch/STEP/limitswitch.stp

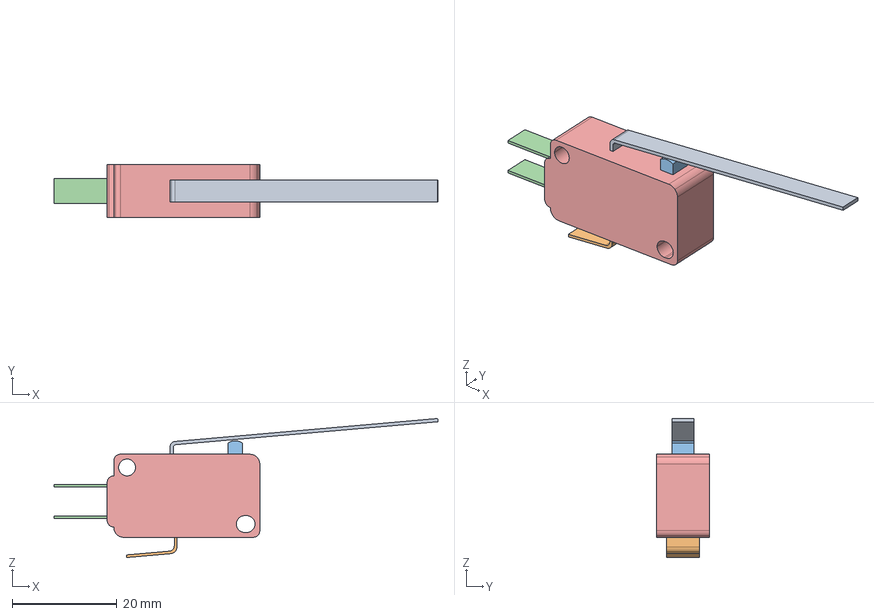
[picture p61: CAD file, 2018-06-28]
Electrical/Limit_Switch/STEP/limitswitch.stp
73.5 x 10.2 x 26.6 mm
limitswitch1
limitswitch2
limitswitch3
limitswitch4
limitswitch5
limitswitch6
