SnoBotics981/CAD-FirstLibrary/Electrical/LV-MaxSonar/STEP/LV-MaxSonar.stp

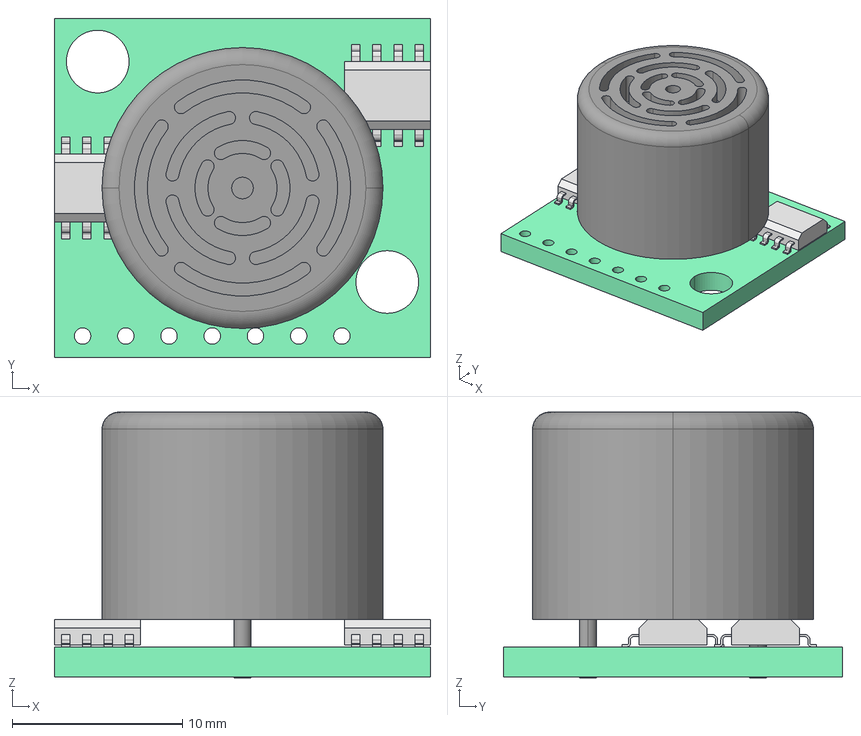
[picture p62: CAD file, 2018-06-28]
Electrical/LV-MaxSonar/STEP/LV-MaxSonar.stp
22.1 x 19.9 x 15.6 mm
LV-Maxsonar PCB
8 Pin SMT x 2
Maxsonar Transducer
