SnoBotics981/CAD-FirstLibrary/Electrical/Maxi_Fuse/STEP/Maxi Fuse.stp

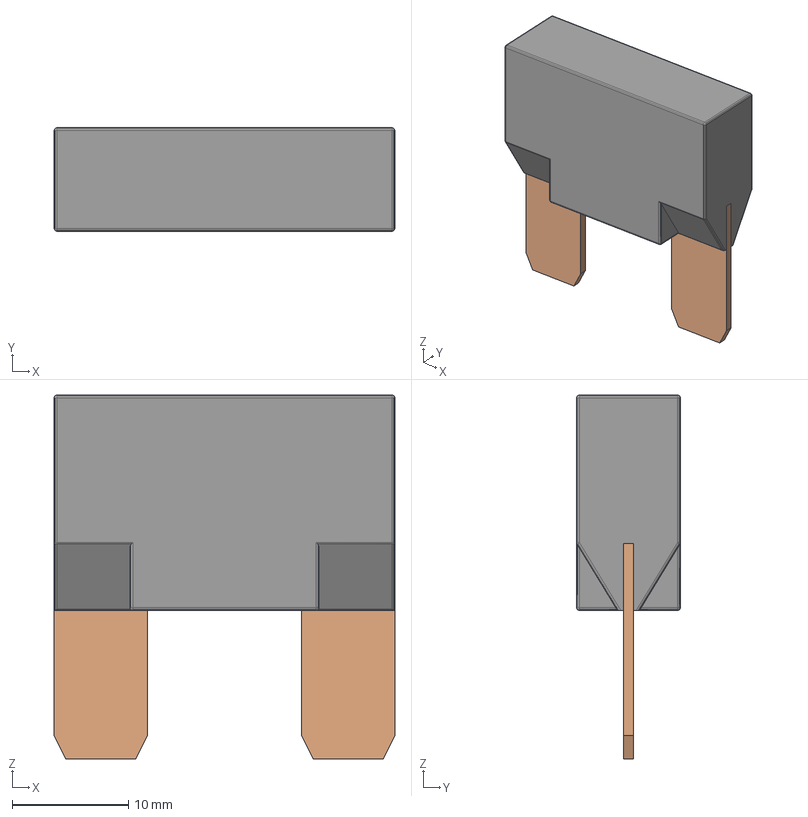
[picture p63: CAD file, 2018-06-28]
Electrical/Maxi_Fuse/STEP/Maxi Fuse.stp
29.2 x 8.90 x 31.3 mm
Maxi Fuse - Body
Maxi Fuse - Terminal x 2
