SnoBotics981/CAD-FirstLibrary/Electrical/Maxi_Fuse_Block/STEP/Maxi Fuse Block.stp

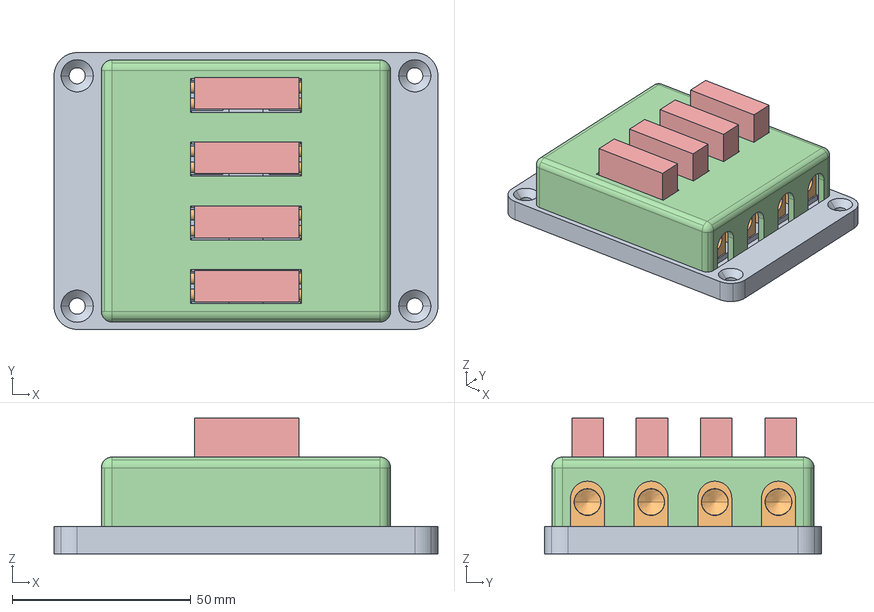
[picture p64: CAD file, 2018-06-28]
Electrical/Maxi_Fuse_Block/STEP/Maxi Fuse Block.stp
107.5 x 77.5 x 38.0 mm
Maxi Fuse Block - Base
Maxi Fuse Block - Terminal x 8
Maxi Fuse Block - Bottom Cover
Maxi Fuse Block - Top Cover
Maxi Fuse - Body x 4
Maxi Fuse - Terminal x 8
