SnoBotics981/CAD-FirstLibrary/Electrical/Mini_Fan_-_412/STEP/Fan-PAPST-412.stp

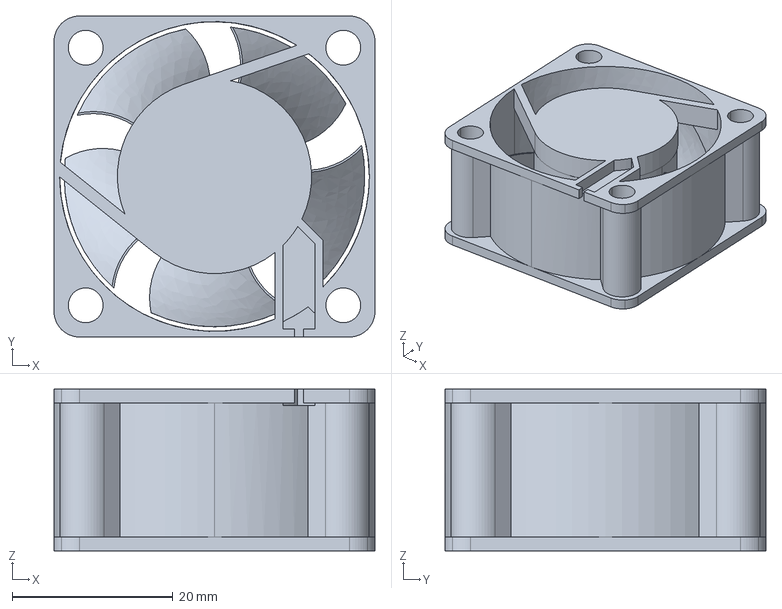
[picture p65: CAD file, 2018-06-28]
Electrical/Mini_Fan_-_412/STEP/Fan-PAPST-412.stp
39.9 x 39.9 x 20.1 mm
