SnoBotics981/CAD-FirstLibrary/Electrical/Mini_Fan_-_412F/STEP/Fan-PAPST-412F.stp

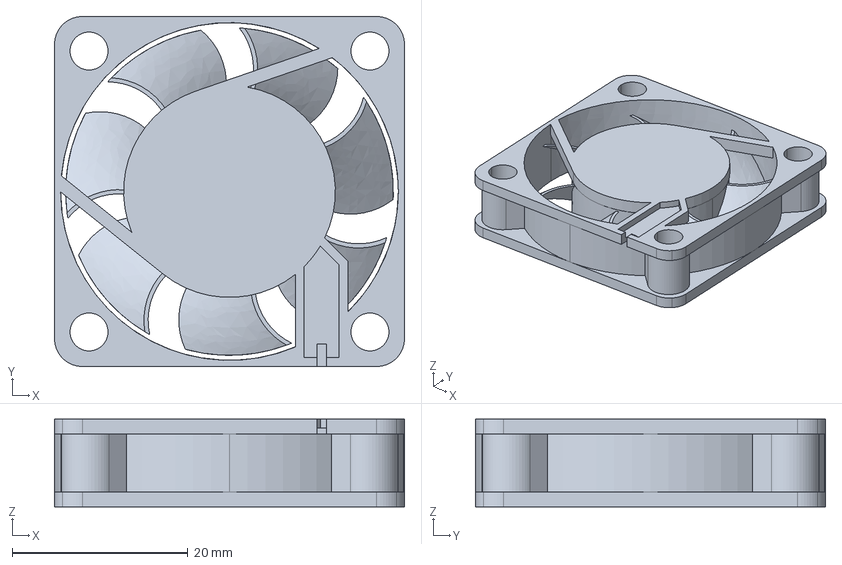
[picture p66: CAD file, 2018-06-28]
Electrical/Mini_Fan_-_412F/STEP/Fan-PAPST-412F.stp
39.9 x 39.9 x 10.0 mm
