SnoBotics981/CAD-FirstLibrary/Electrical/Mini_PC_Board/STEP/Mini Board.stp

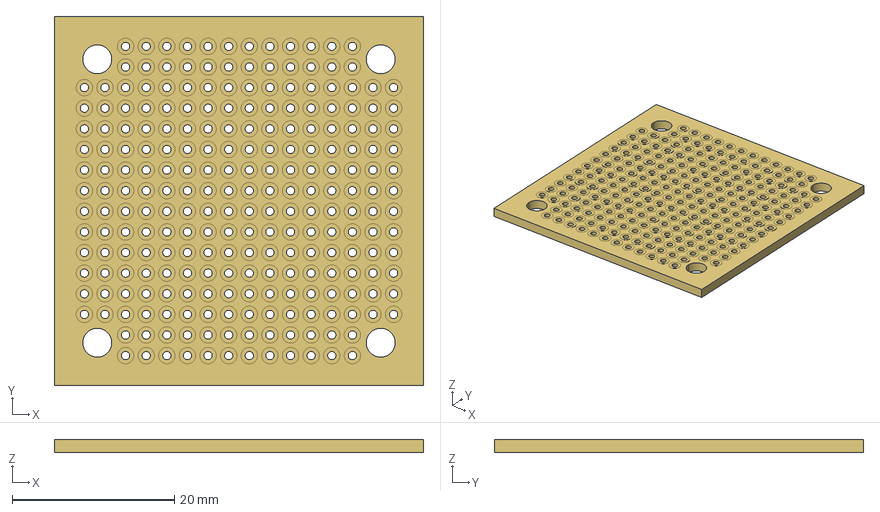
[picture p67: CAD file, 2018-06-28]
Electrical/Mini_PC_Board/STEP/Mini Board.stp
45.5 x 45.5 x 1.63 mm
