SnoBotics981/CAD-FirstLibrary/Electrical/Motor_Controller/STEP/Victor884.stp

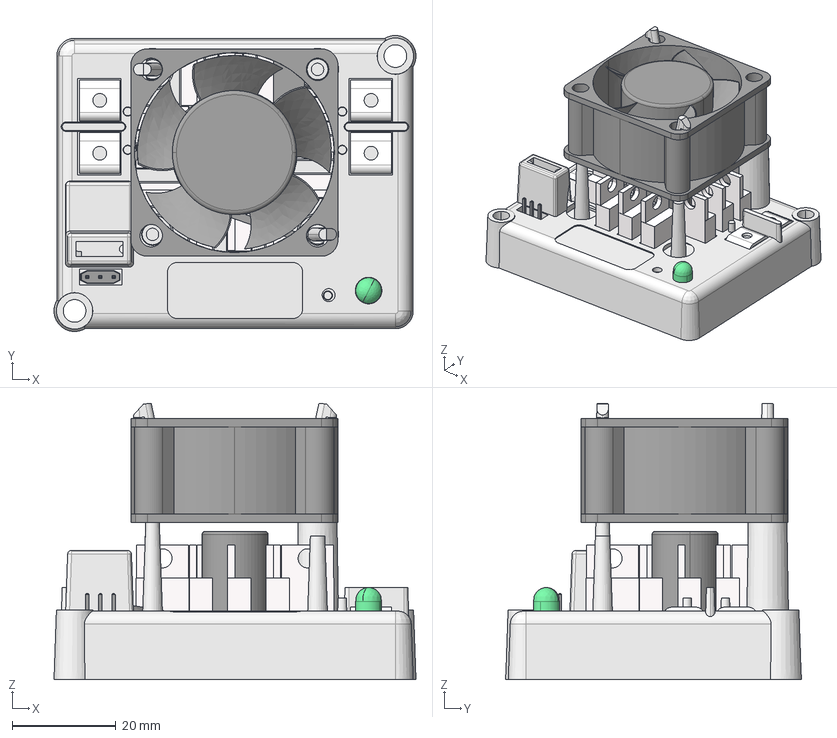
[picture p68: CAD file, 2018-06-28]
Electrical/Motor_Controller/STEP/Victor884.stp
69.6 x 56.9 x 53.1 mm
Victor884-Cover
Fan-PAPST-412
Victor884-Base
Victor884-Capacitor
Victor884-LED - Green
Victor884-Fet x 12
Victor884 Screw Terminal x 4
Victor884-3 Pin Connector
