SnoBotics981/CAD-FirstLibrary/Electrical/Optical_Sensor/STEP/bannersensor.stp

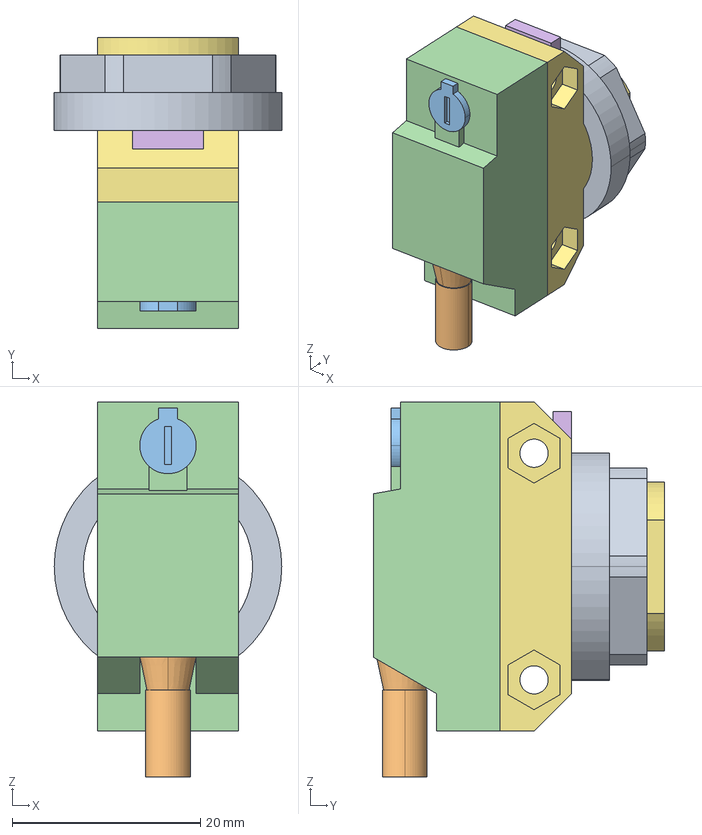
[picture p69: CAD file, 2018-06-28]
Electrical/Optical_Sensor/STEP/bannersensor.stp
24.2 x 31.0 x 39.9 mm
bannersensor1
bannersensor2
bannersensor3
bannersensor4
bannersensor5
bannersensor6
bannersensor7
