SnoBotics981/CAD-FirstLibrary/Electrical/Optical_Switch/STEP/Optical Interrupter Switch.stp

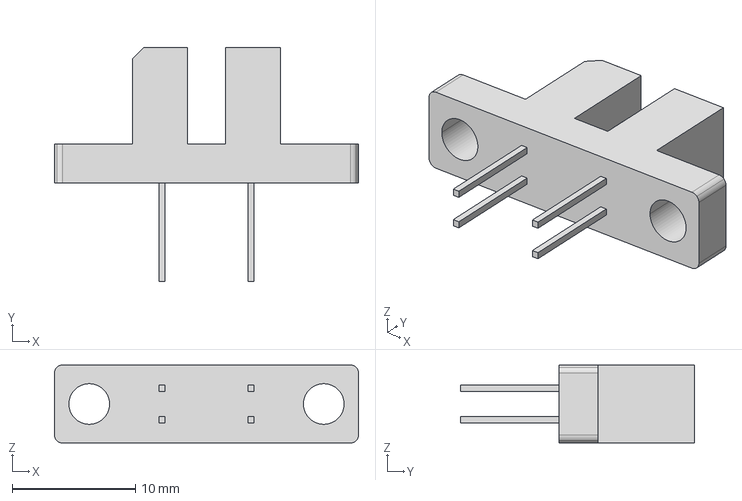
[picture p70: CAD file, 2018-06-28]
Electrical/Optical_Switch/STEP/Optical Interrupter Switch.stp
24.7 x 19.0 x 6.32 mm
