SnoBotics981/CAD-FirstLibrary/Electrical/PCB_Terminal/STEP/PCB Terminal.stp

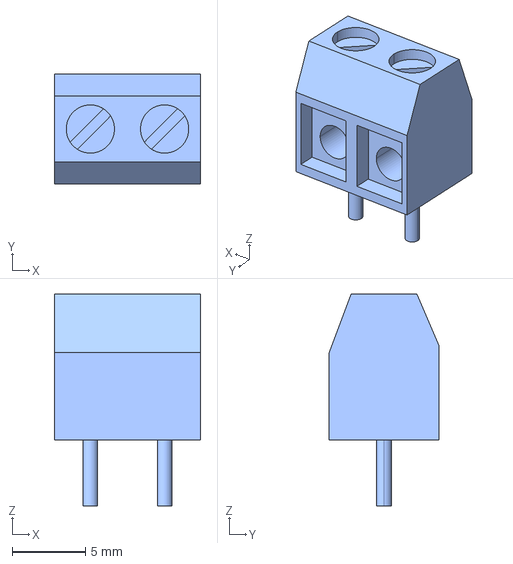
[picture p71: CAD file, 2018-06-28]
Electrical/PCB_Terminal/STEP/PCB Terminal.stp
10.0 x 7.50 x 14.5 mm
