SnoBotics981/CAD-FirstLibrary/Electrical/Photo_Interrupter/STEP/Photo Interrupter.stp

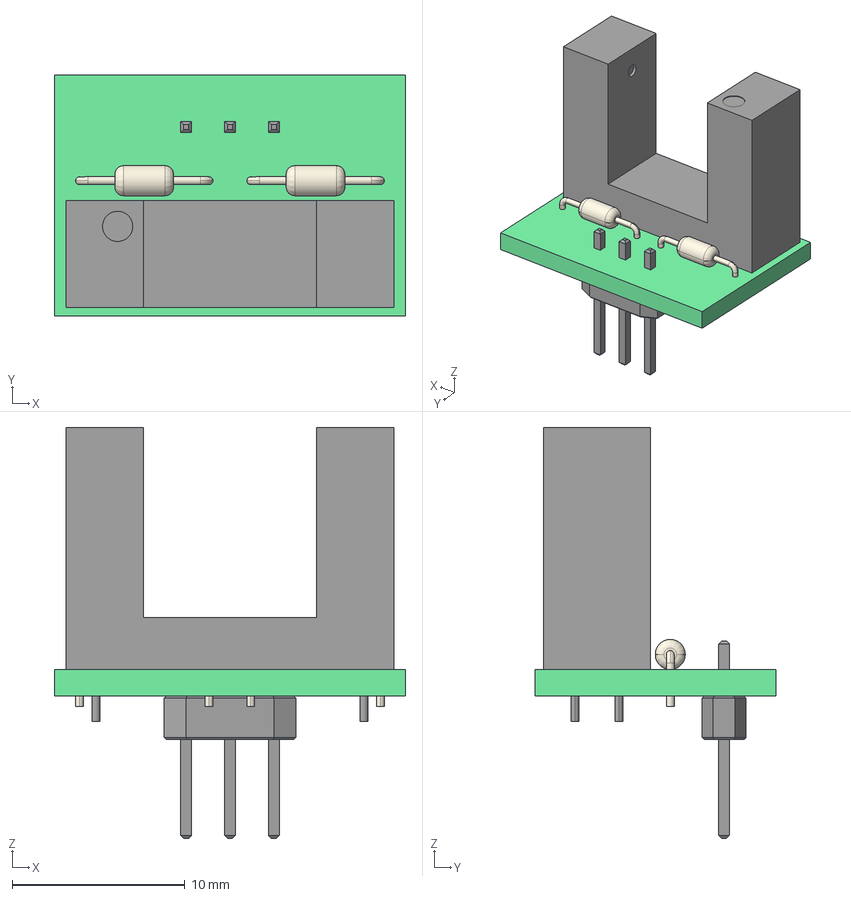
[picture p72: CAD file, 2018-06-28]
Electrical/Photo_Interrupter/STEP/Photo Interrupter.stp
20.3 x 14.0 x 23.8 mm
Photo Interrupter PCB
CNZ1120 Photo Interrupter
3 Pin Connector
Resistor - Thru Hole x 2
