SnoBotics981/CAD-FirstLibrary/Electrical/Potentiometer/STEP/potentiometer.stp

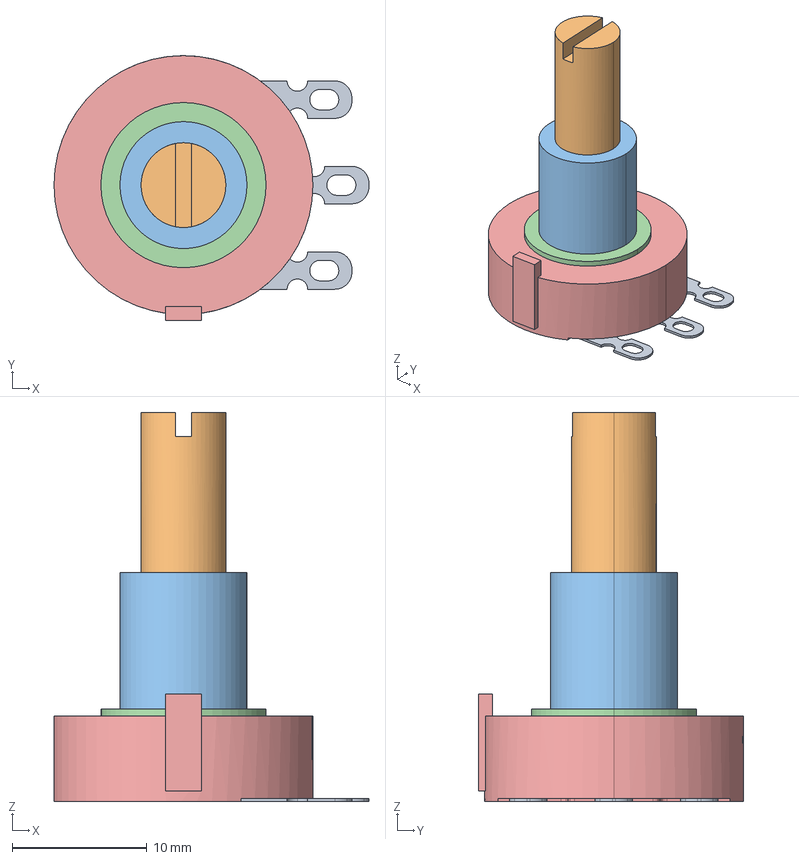
[picture p73: CAD file, 2018-06-28]
Electrical/Potentiometer/STEP/potentiometer.stp
23.4 x 19.7 x 28.9 mm
potentiometer1
potentiometer2
potentiometer3
potentiometer4
potentiometer5
potentiometer6
potentiometer7
