SnoBotics981/CAD-FirstLibrary/Electrical/Power_Block/STEP/Power Block.stp

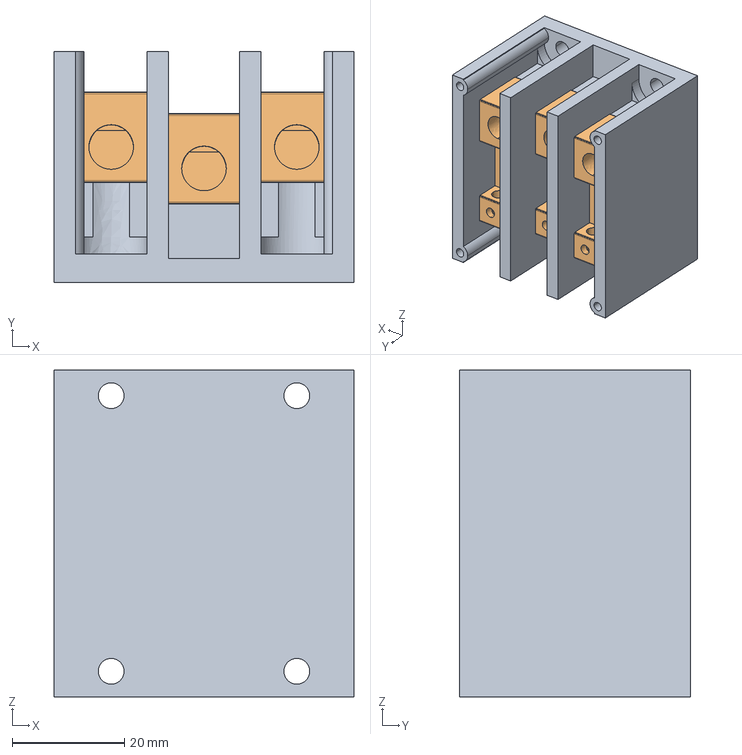
[picture p74: CAD file, 2018-06-28]
Electrical/Power_Block/STEP/Power Block.stp
53.3 x 41.1 x 58.2 mm
Power Block - Base
Power Block - Terminal x 3
