SnoBotics981/CAD-FirstLibrary/Electrical/Reflective_Sensor/STEP/Reflective Object Sensor.stp

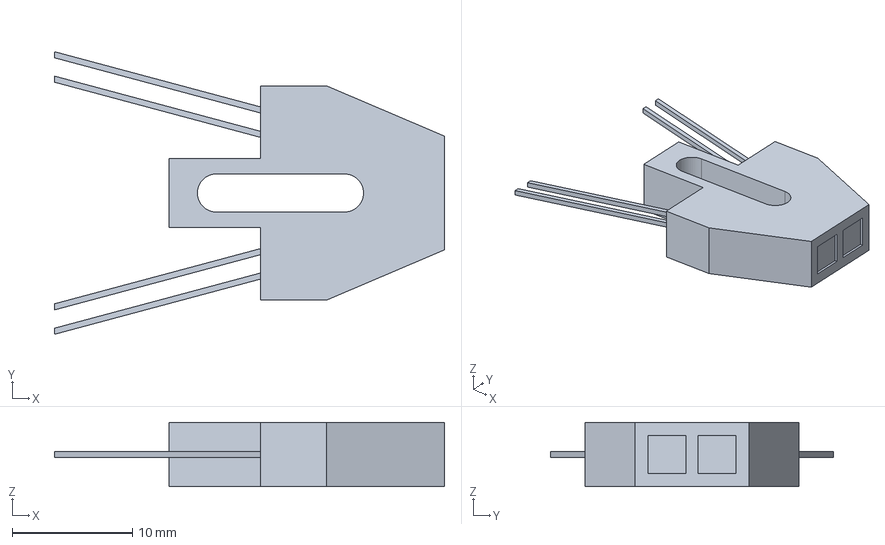
[picture p75: CAD file, 2018-06-28]
Electrical/Reflective_Sensor/STEP/Reflective Object Sensor.stp
32.5 x 23.5 x 5.33 mm
