SnoBotics981/CAD-FirstLibrary/Electrical/Sharp_GP2Y0_Sensor/STEP/Sharp GP2Y0 Sensor.stp

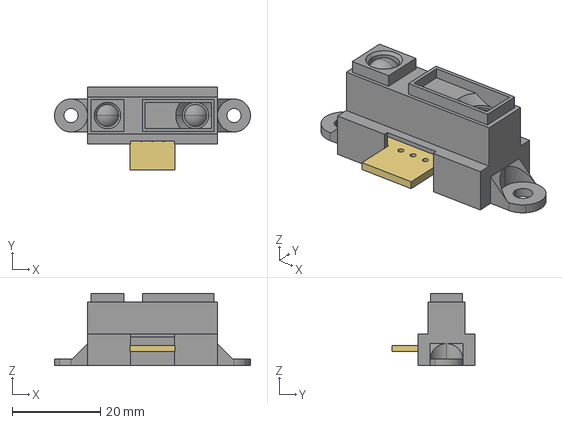
[picture p76: CAD file, 2018-06-28]
Electrical/Sharp_GP2Y0_Sensor/STEP/Sharp GP2Y0 Sensor.stp
44.5 x 18.9 x 16.4 mm
Sharp GP2Y0 Sensor Housing
Sharp GP2Y0 Sensor PCB
