SnoBotics981/CAD-FirstLibrary/Electrical/Slip_Ring/STEP/Slip Ring.stp

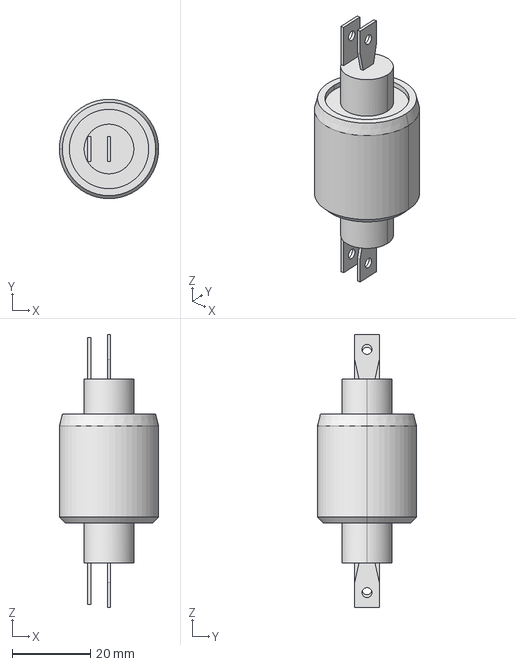
[picture p77: CAD file, 2018-06-28]
Electrical/Slip_Ring/STEP/Slip Ring.stp
25.4 x 25.4 x 69.9 mm
