SnoBotics981/CAD-FirstLibrary/Electrical/Sonalert/STEP/Sonalert.stp

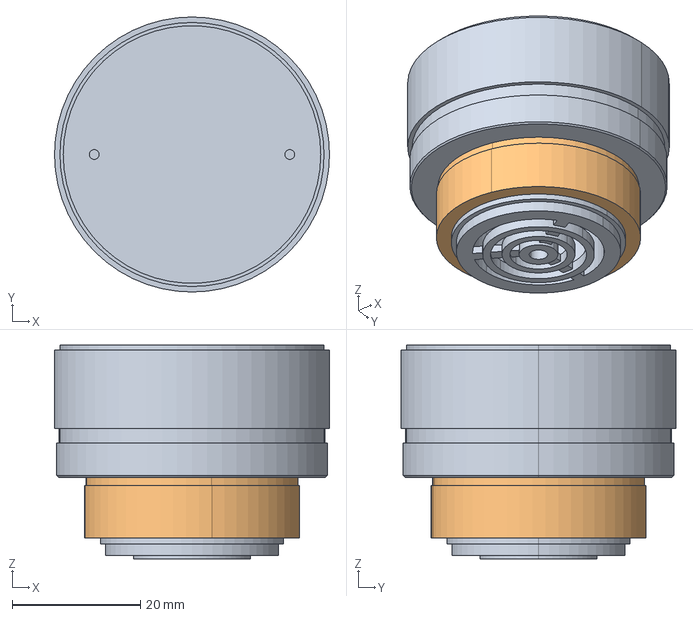
[picture p78: CAD file, 2018-06-28]
Electrical/Sonalert/STEP/Sonalert.stp
42.8 x 42.8 x 33.3 mm
Sonalert
Sonalert Nut
