SnoBotics981/CAD-FirstLibrary/Electrical/Tamura_Sensor/STEP/Tamura Current Sensor.stp

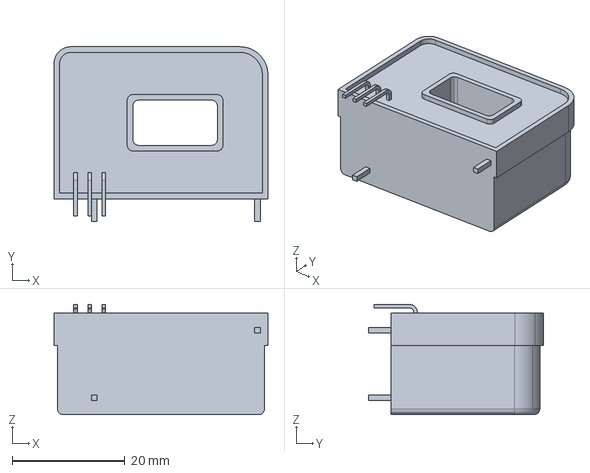
[picture p79: CAD file, 2018-06-28]
Electrical/Tamura_Sensor/STEP/Tamura Current Sensor.stp
38.0 x 31.0 x 19.6 mm
