SnoBotics981/CAD-FirstLibrary/Electrical/Terminal_Strip/STEP/terminalstrip.stp

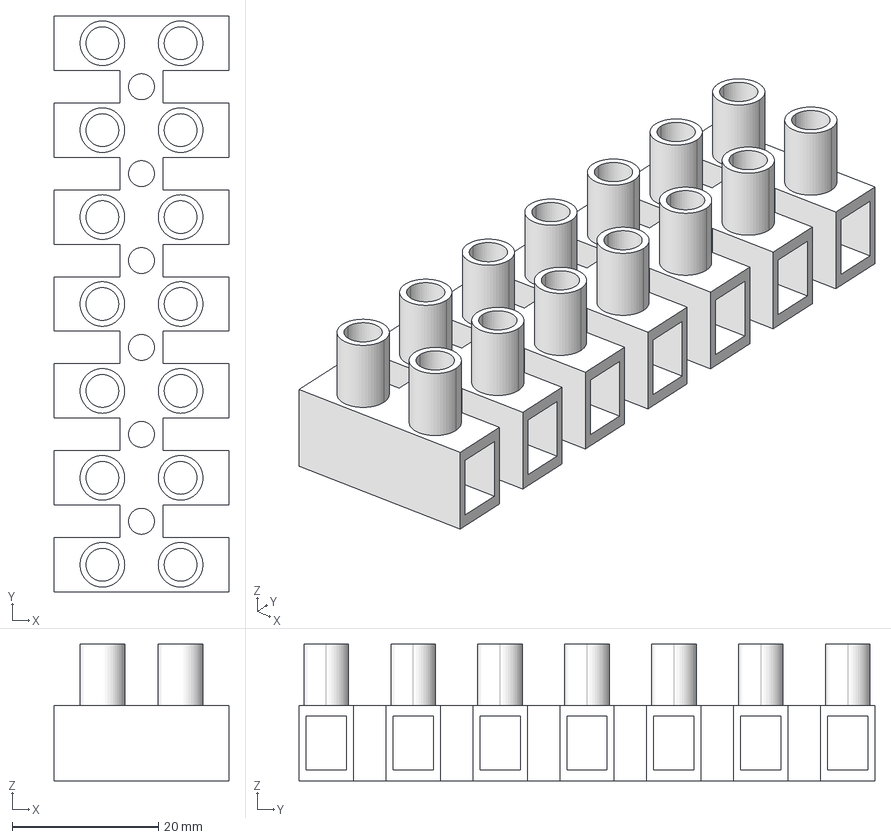
[picture p80: CAD file, 2018-06-28]
Electrical/Terminal_Strip/STEP/terminalstrip.stp
23.9 x 78.9 x 18.7 mm
