SnoBotics981/CAD-FirstLibrary/Electrical/Ultrasonic_Sensor/STEP/Parallax Ping Sensor.stp

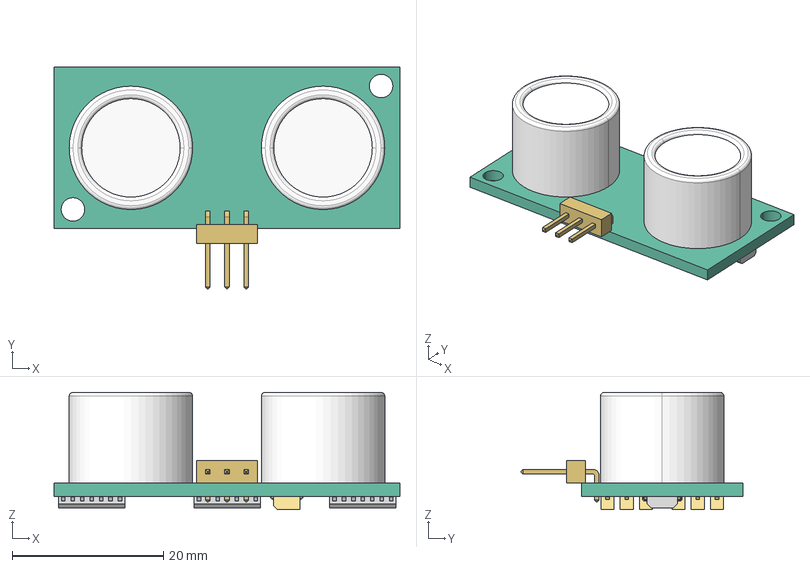
[picture p81: CAD file, 2018-06-28]
Electrical/Ultrasonic_Sensor/STEP/Parallax Ping Sensor.stp
45.7 x 29.3 x 15.5 mm
Parallax Ping PCB
Parallax Ping Transducer x 2
Cap1 SMT x 6
14 Pin SMT x 3
3 Pin Header 90 Degree
