SnoBotics981/CAD-FirstLibrary/Extrusion/1-1.2_x_3.4/STEP/sqtube1500x0750.stp

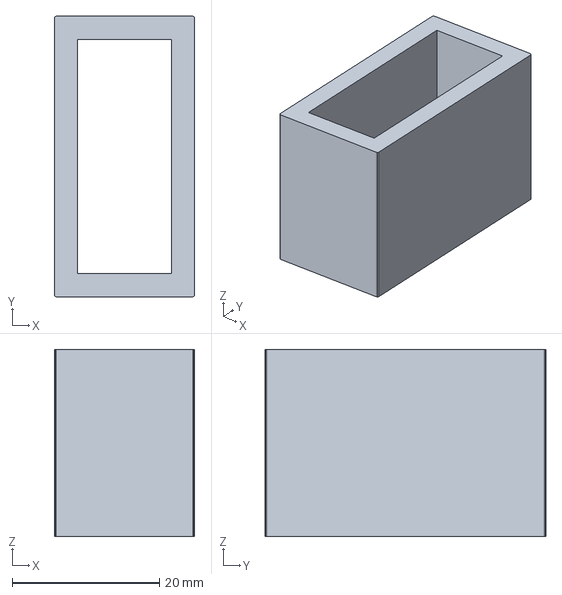
[picture p82: CAD file, 2018-06-28]
Extrusion/1-1.2_x_3.4/STEP/sqtube1500x0750.stp
19.1 x 38.1 x 25.4 mm
