SnoBotics981/CAD-FirstLibrary/Extrusion/1_OD_x_3.4_ID/STEP/tube1000x0750.stp

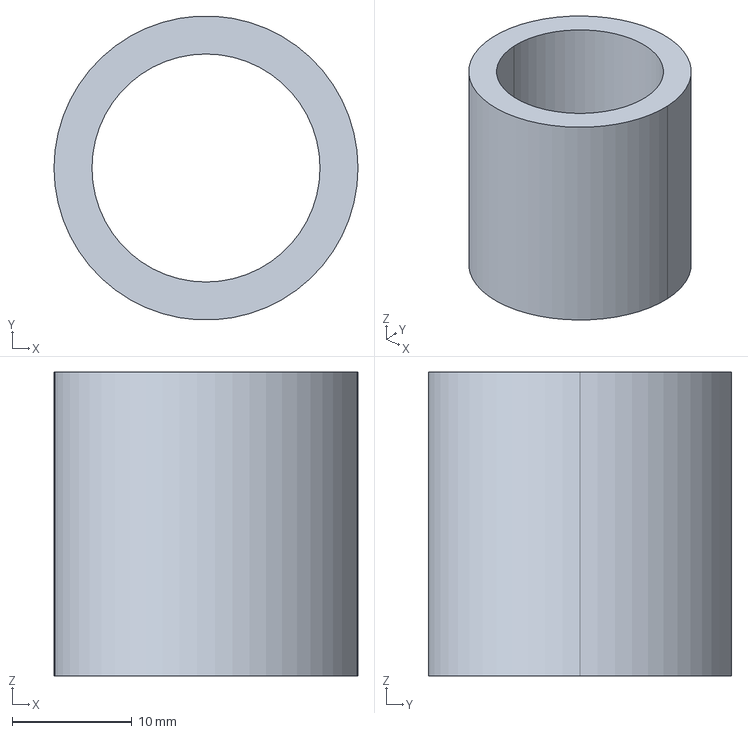
[picture p83: CAD file, 2018-06-28]
Extrusion/1_OD_x_3.4_ID/STEP/tube1000x0750.stp
25.4 x 25.4 x 25.4 mm
