SnoBotics981/CAD-FirstLibrary/Extrusion/2_x_1/STEP/sqtube2000x1000.stp

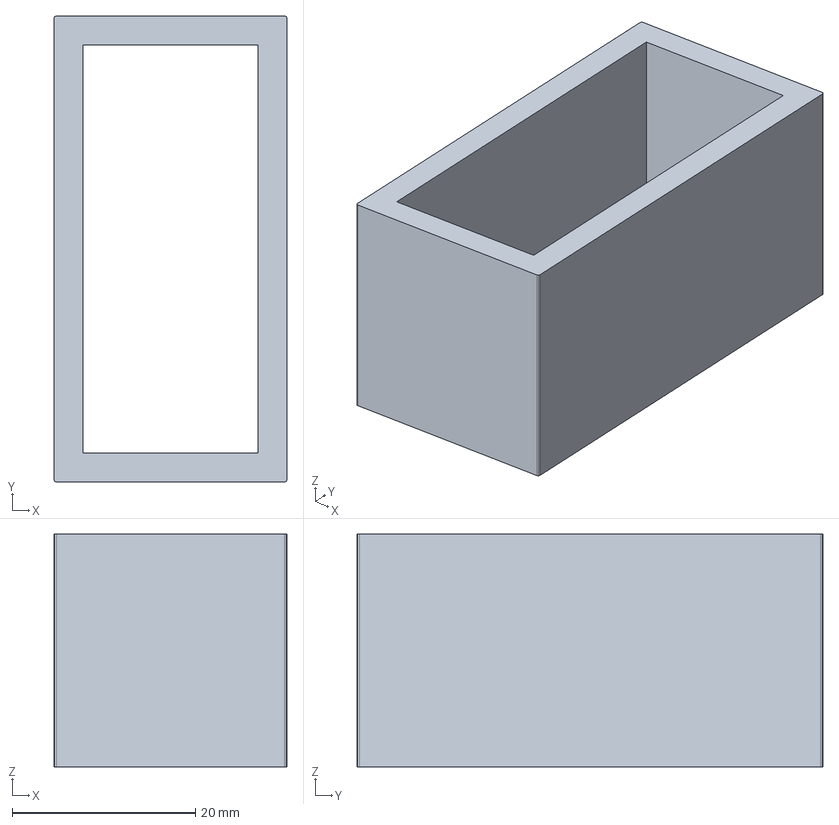
[picture p84: CAD file, 2018-06-28]
Extrusion/2_x_1/STEP/sqtube2000x1000.stp
25.4 x 50.8 x 25.4 mm
