SnoBotics981/CAD-FirstLibrary/Extrusion/80.20_1.5_x_1.5/STEP/8020-1515l.stp

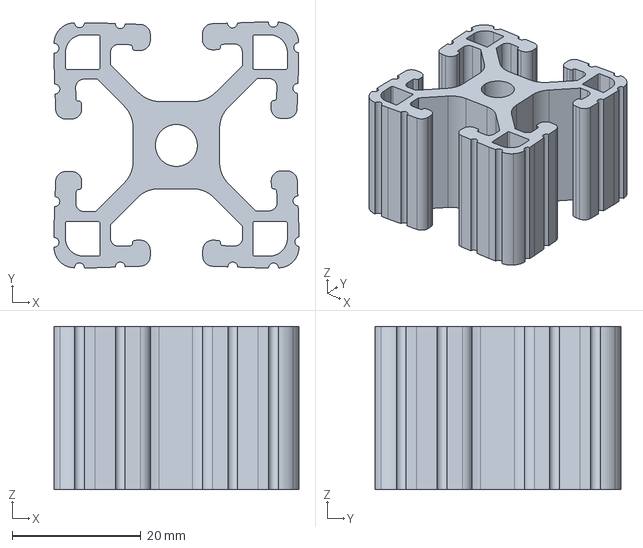
[picture p85: CAD file, 2018-06-28]
Extrusion/80.20_1.5_x_1.5/STEP/8020-1515l.stp
38.1 x 38.2 x 25.4 mm
