SnoBotics981/CAD-FirstLibrary/Extrusion/80.20_1_x_1/STEP/8020-1010.stp

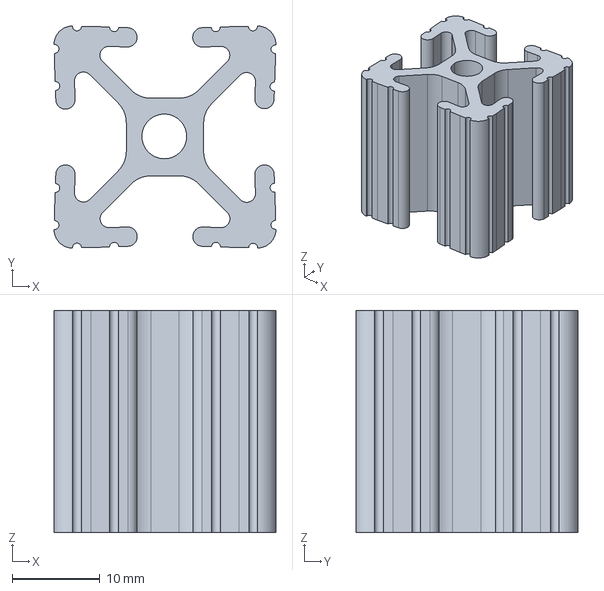
[picture p86: CAD file, 2018-06-28]
Extrusion/80.20_1_x_1/STEP/8020-1010.stp
25.4 x 25.4 x 25.4 mm
