SnoBotics981/CAD-FirstLibrary/Extrusion/80.20_1_x_2/STEP/8020-1020.stp

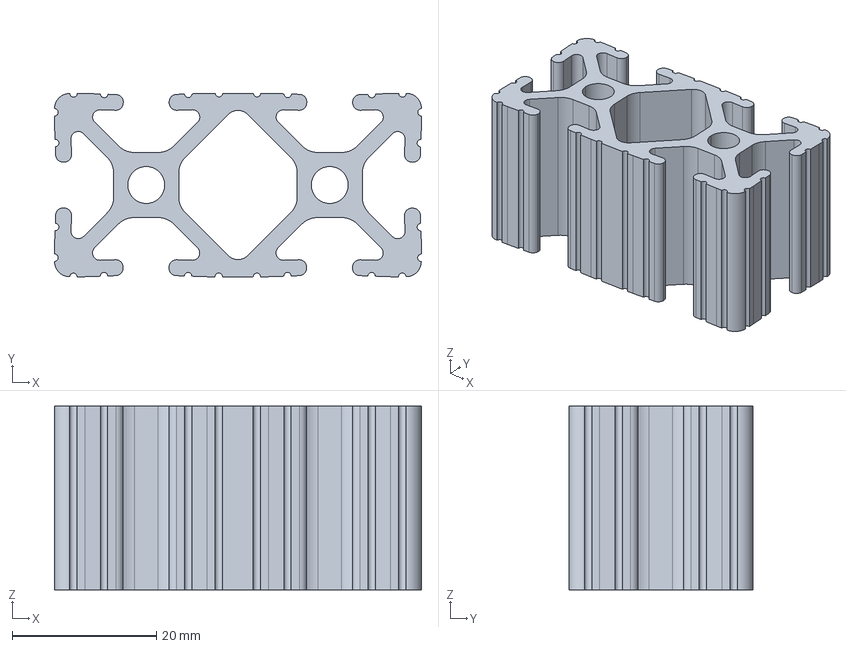
[picture p87: CAD file, 2018-06-28]
Extrusion/80.20_1_x_2/STEP/8020-1020.stp
50.8 x 25.4 x 25.4 mm
