SnoBotics981/CAD-FirstLibrary/Extrusion/80.20_1_x_3/STEP/8020-1030.stp

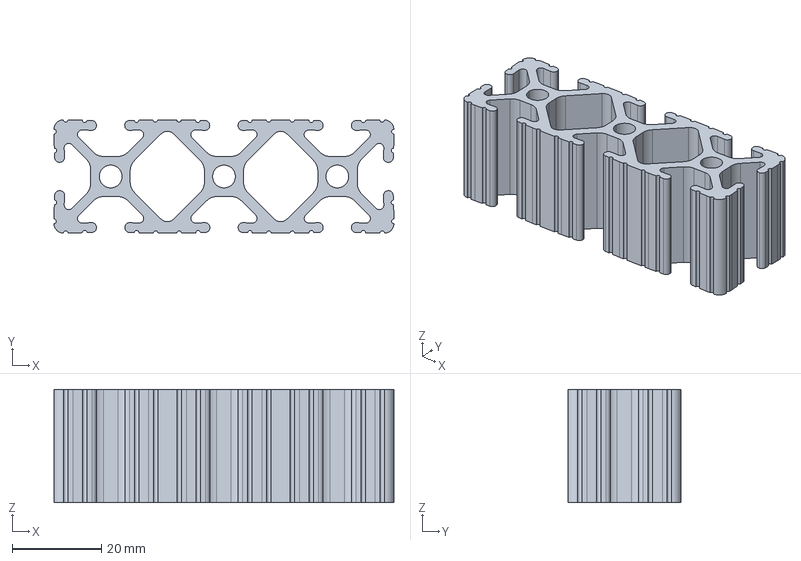
[picture p88: CAD file, 2018-06-28]
Extrusion/80.20_1_x_3/STEP/8020-1030.stp
76.2 x 25.4 x 25.4 mm
