SnoBotics981/CAD-FirstLibrary/Extrusion/80.20_2_x_2/STEP/8020-2020.stp

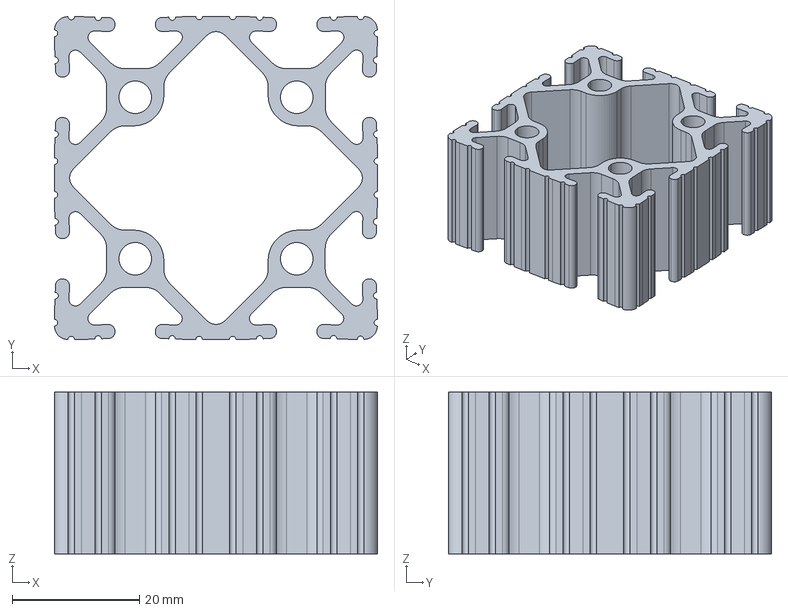
[picture p89: CAD file, 2018-06-28]
Extrusion/80.20_2_x_2/STEP/8020-2020.stp
50.8 x 50.8 x 25.4 mm
