SnoBotics981/CAD-FirstLibrary/Extrusion/Bosch_20mm_x_20mm/STEP/bosch2020.stp

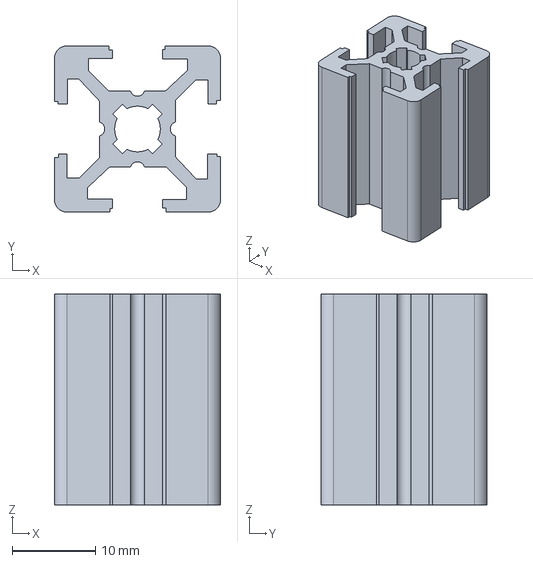
[picture p90: CAD file, 2018-06-28]
Extrusion/Bosch_20mm_x_20mm/STEP/bosch2020.stp
20.0 x 20.0 x 25.4 mm
