SnoBotics981/CAD-FirstLibrary/Extrusion/Bosch_30mm_Gusset/STEP/boschgusset30.stp

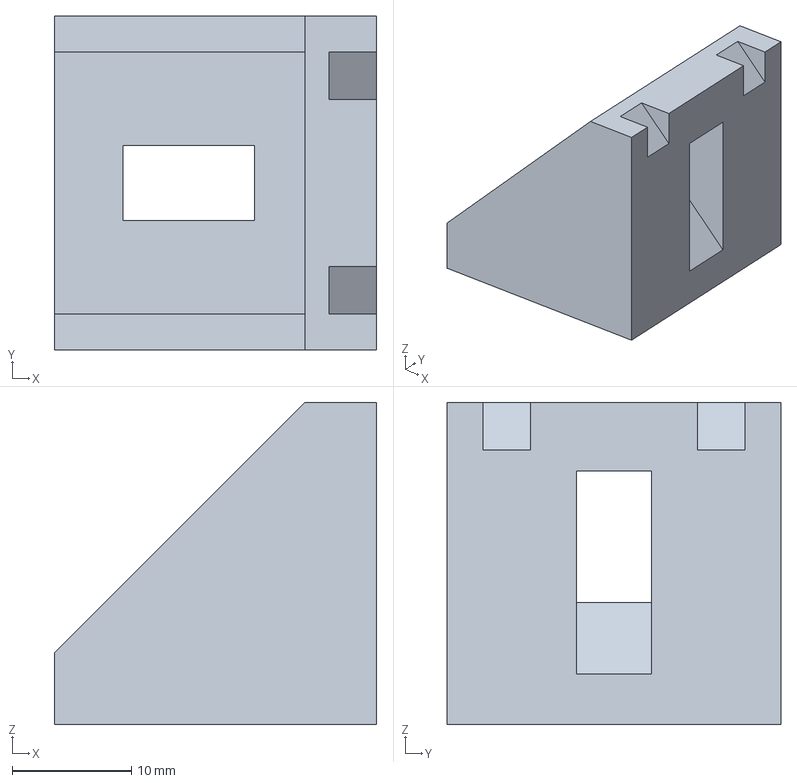
[picture p91: CAD file, 2018-06-28]
Extrusion/Bosch_30mm_Gusset/STEP/boschgusset30.stp
27.0 x 28.0 x 27.0 mm
