SnoBotics981/CAD-FirstLibrary/Extrusion/Bosch_30mm_x_30mm/STEP/bosch3030.stp

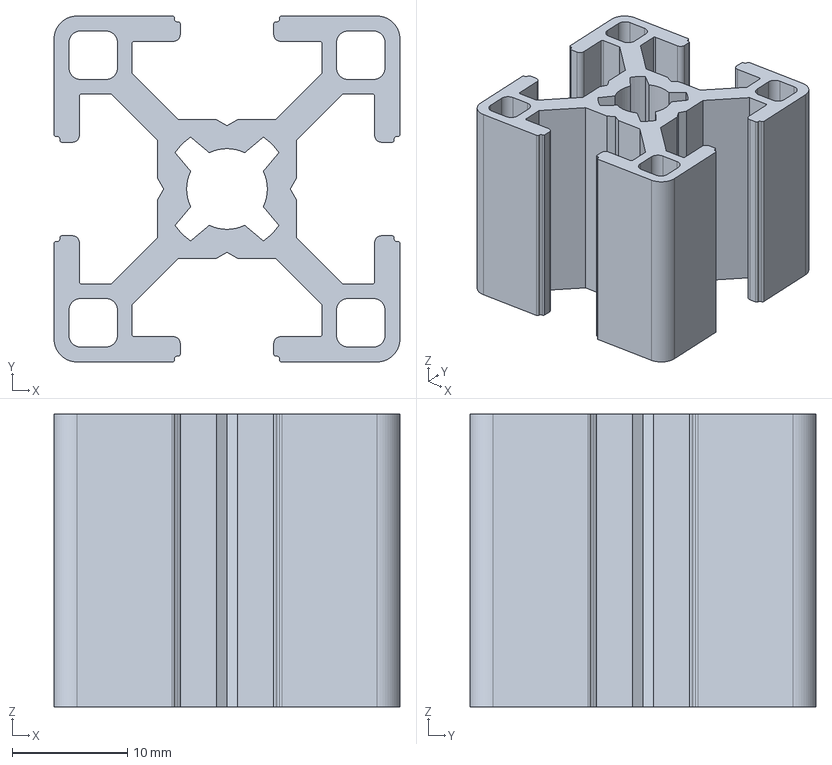
[picture p92: CAD file, 2018-06-28]
Extrusion/Bosch_30mm_x_30mm/STEP/bosch3030.stp
30.0 x 30.0 x 25.4 mm
