SnoBotics981/CAD-FirstLibrary/Extrusion/Bosch_45mm_Gusset/STEP/boschgusset45.stp

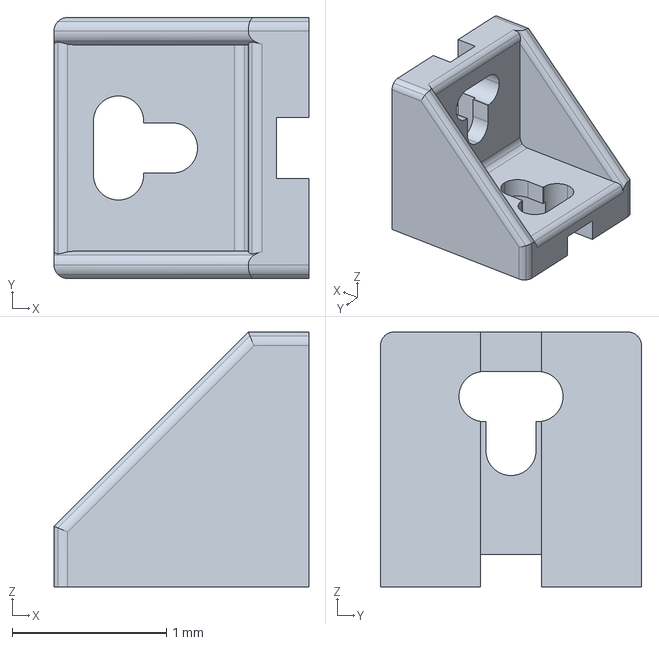
[picture p93: CAD file, 2018-06-28]
Extrusion/Bosch_45mm_Gusset/STEP/boschgusset45.stp
1.65 x 1.69 x 1.65 mm
