SnoBotics981/CAD-FirstLibrary/Extrusion/Bosch_45mm_x_45mm/STEP/bosch4545.stp

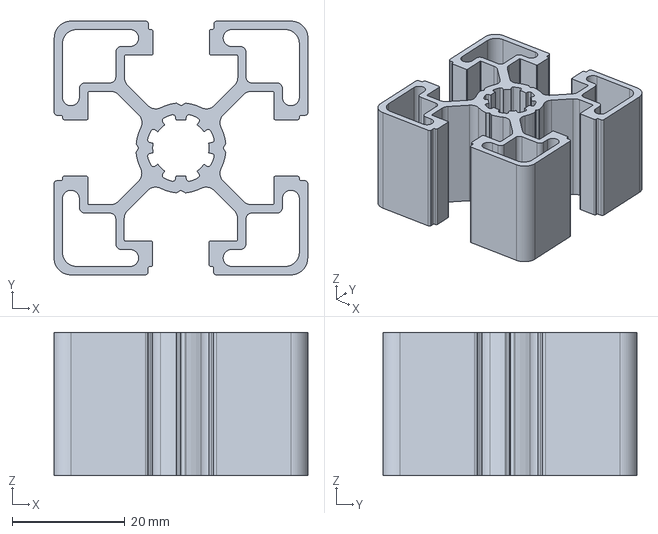
[picture p94: CAD file, 2018-06-28]
Extrusion/Bosch_45mm_x_45mm/STEP/bosch4545.stp
45.0 x 45.0 x 25.4 mm
