SnoBotics981/CAD-FirstLibrary/Extrusion/Corner_Plate/STEP/bsf-30457.stp

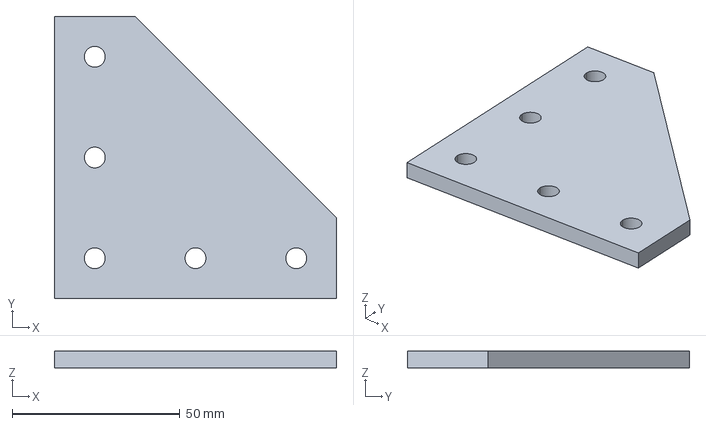
[picture p95: CAD file, 2018-06-28]
Extrusion/Corner_Plate/STEP/bsf-30457.stp
84.0 x 84.0 x 5.00 mm
