SnoBotics981/CAD-FirstLibrary/Extrusion/T_Junction_Plate/STEP/bsf-30461.stp

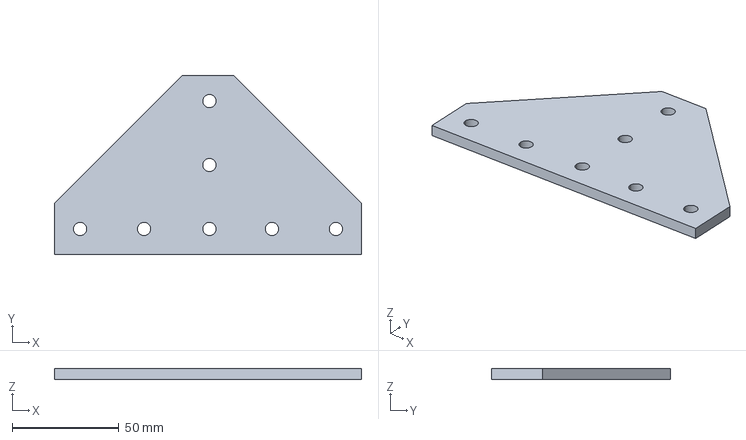
[picture p96: CAD file, 2018-06-28]
Extrusion/T_Junction_Plate/STEP/bsf-30461.stp
144.0 x 84.0 x 5.00 mm
