SnoBotics981/CAD-FirstLibrary/Gears/CIM_12T/STEP/AM-0018.stp

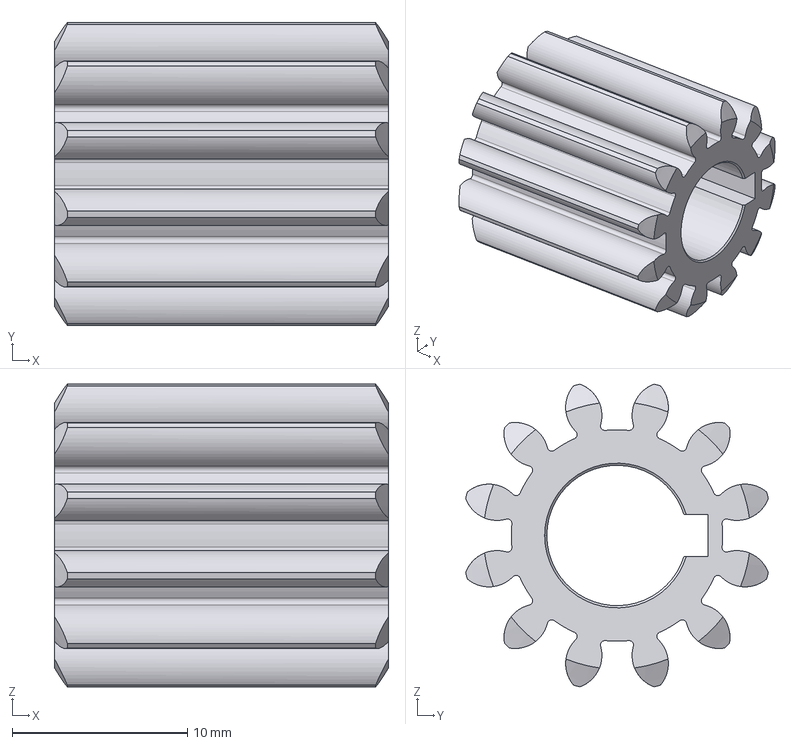
[picture p97: CAD file, 2018-06-28]
Gears/CIM_12T/STEP/AM-0018.stp
19.1 x 17.3 x 17.3 mm
