SnoBotics981/CAD-FirstLibrary/Gears/CIM_14T/STEP/AM-0034.stp

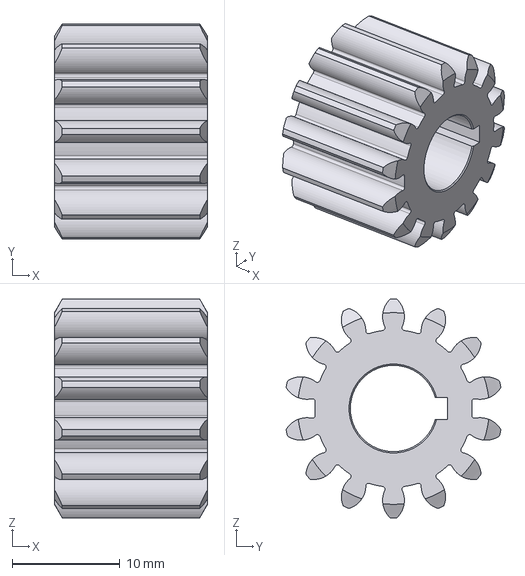
[picture p98: CAD file, 2018-06-28]
Gears/CIM_14T/STEP/AM-0034.stp
14.2 x 19.9 x 20.3 mm
