SnoBotics981/CAD-FirstLibrary/Gears/FP_Final_Gear/STEP/fpgear4.stp

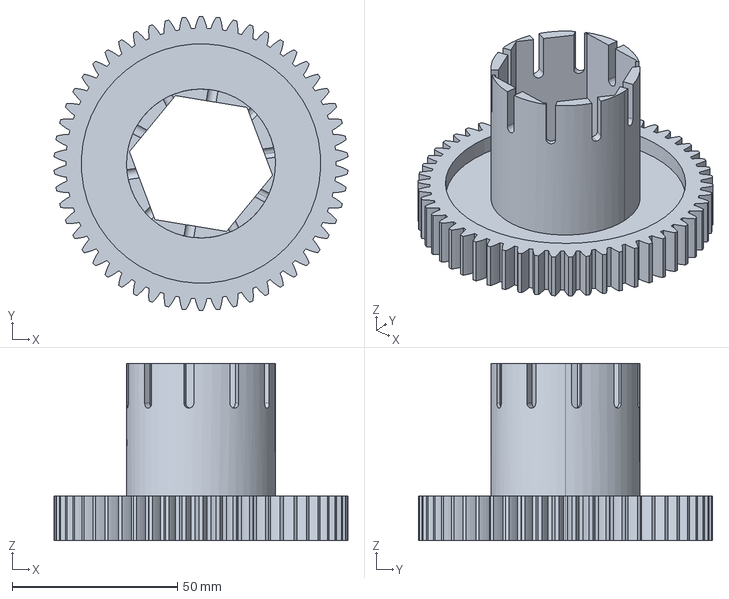
[picture p99: CAD file, 2018-06-28]
Gears/FP_Final_Gear/STEP/fpgear4.stp
88.8 x 88.9 x 53.5 mm
