SnoBotics981/CAD-FirstLibrary/Gears/FP_Pinion_19T/STEP/FP Pinion 19T.stp

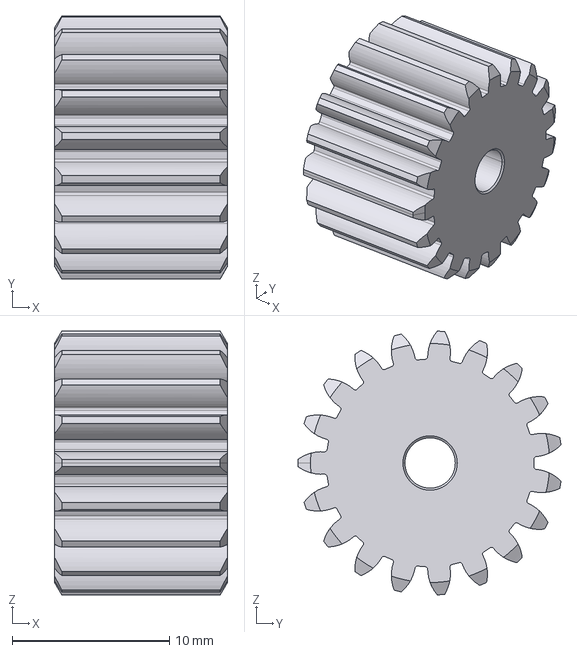
[picture p100: CAD file, 2018-06-28]
Gears/FP_Pinion_19T/STEP/FP Pinion 19T.stp
11.0 x 16.7 x 16.8 mm
