SnoBotics981/CAD-FirstLibrary/Gears/Gear_0.7M_60T/STEP/gear07m60t.stp

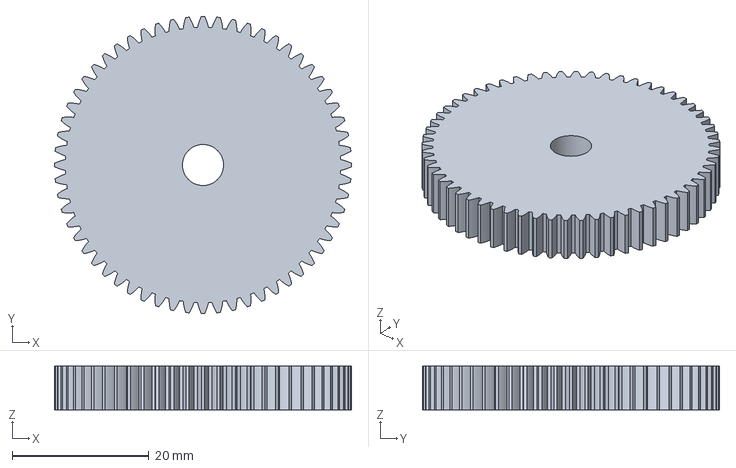
[picture p101: CAD file, 2018-06-28]
Gears/Gear_0.7M_60T/STEP/gear07m60t.stp
43.4 x 43.4 x 6.40 mm
