SnoBotics981/CAD-FirstLibrary/Gears/Gear_20P_12T/STEP/gss-2012.stp

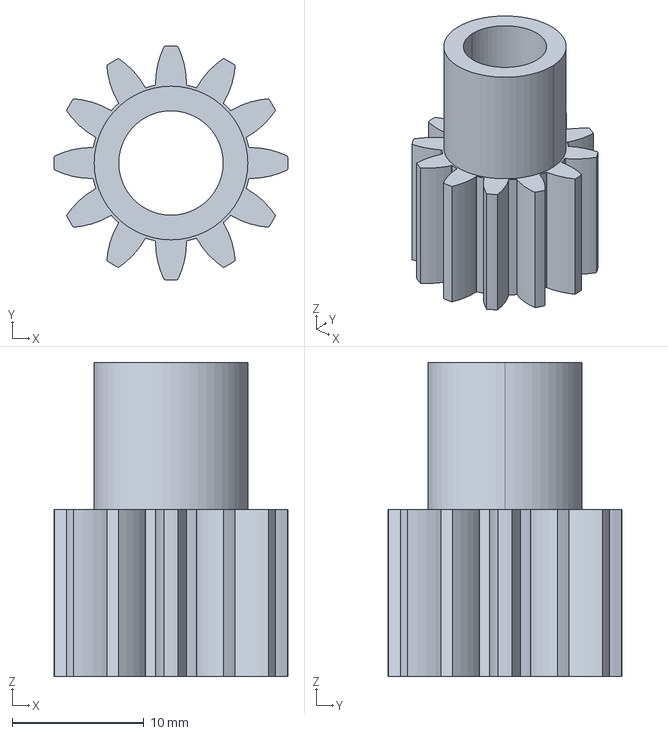
[picture p102: CAD file, 2018-06-28]
Gears/Gear_20P_12T/STEP/gss-2012.stp
17.8 x 17.8 x 23.9 mm
