SnoBotics981/CAD-FirstLibrary/Gears/Gear_20P_14T/STEP/gss-2014.stp

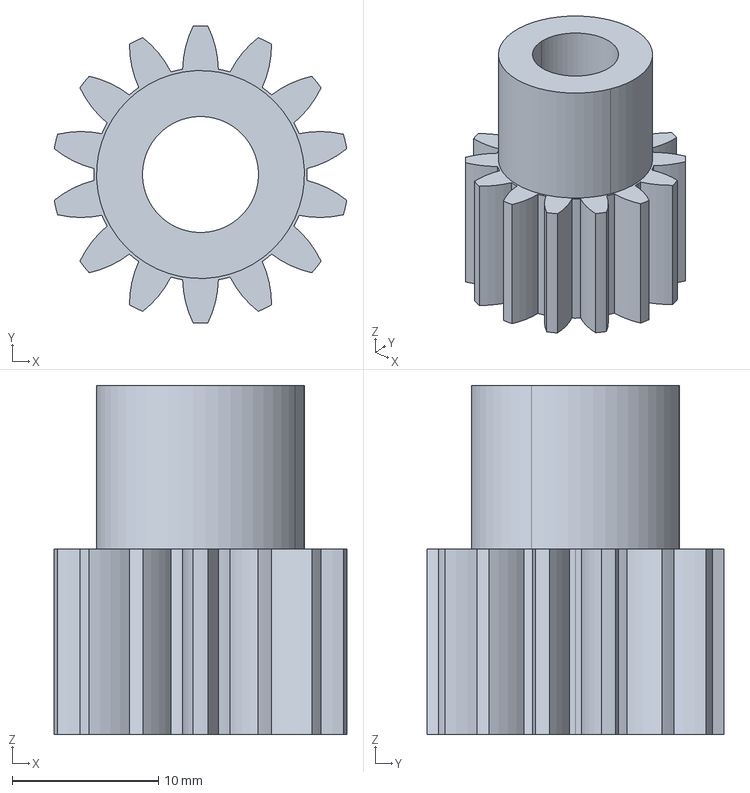
[picture p103: CAD file, 2018-06-28]
Gears/Gear_20P_14T/STEP/gss-2014.stp
20.0 x 20.3 x 23.9 mm
