SnoBotics981/CAD-FirstLibrary/Gears/Gear_20P_15T/STEP/gss-2015.stp

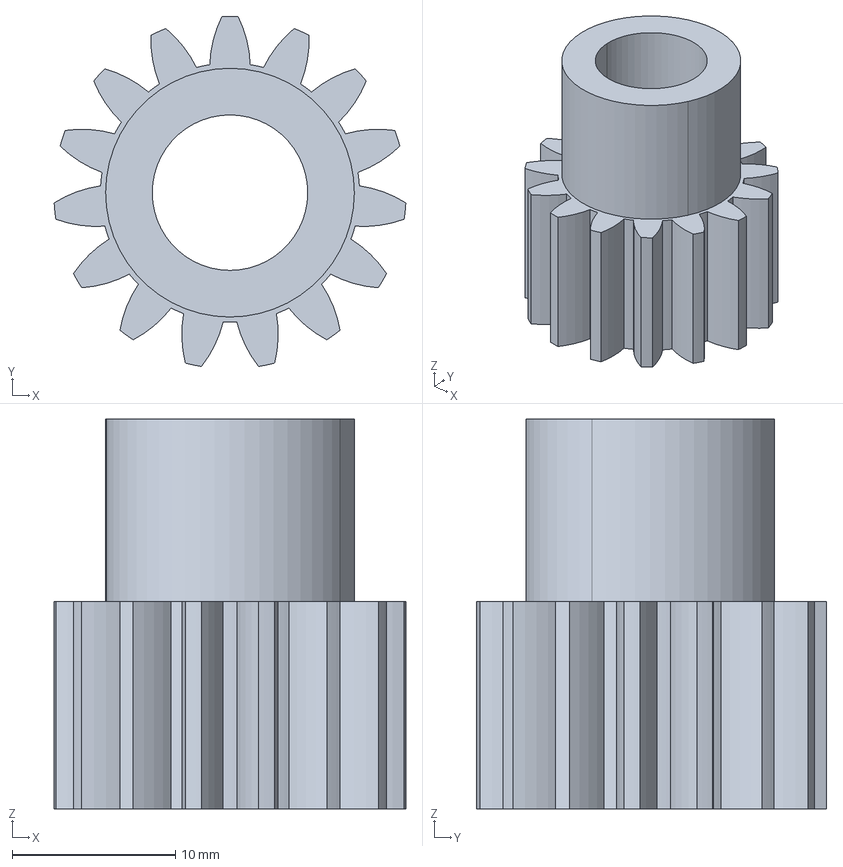
[picture p104: CAD file, 2018-06-28]
Gears/Gear_20P_15T/STEP/gss-2015.stp
21.6 x 21.4 x 23.9 mm
