SnoBotics981/CAD-FirstLibrary/Gears/Gear_20P_16T/STEP/gss-2016.stp

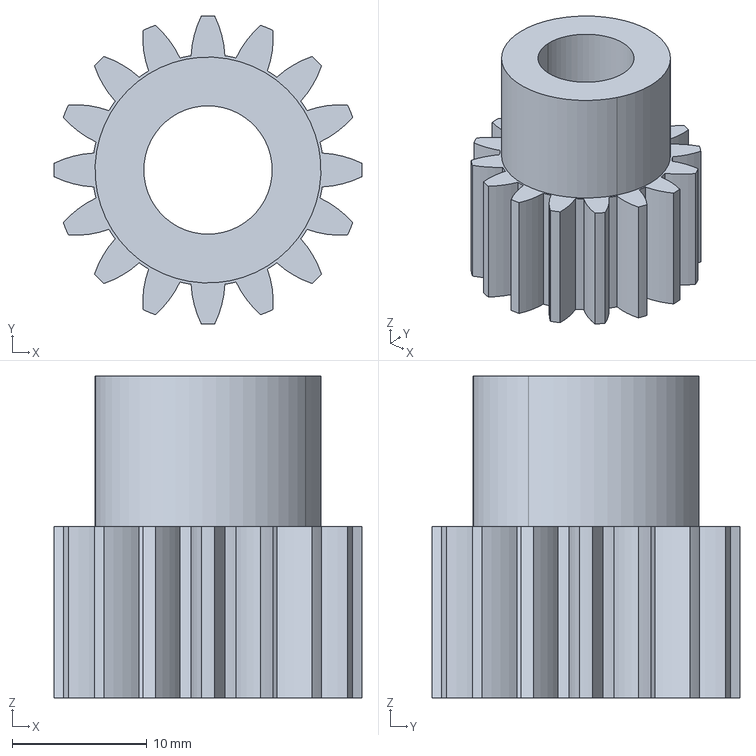
[picture p105: CAD file, 2018-06-28]
Gears/Gear_20P_16T/STEP/gss-2016.stp
22.9 x 22.9 x 23.9 mm
