SnoBotics981/CAD-FirstLibrary/Gears/Gear_20P_18T/STEP/gss-2018.stp

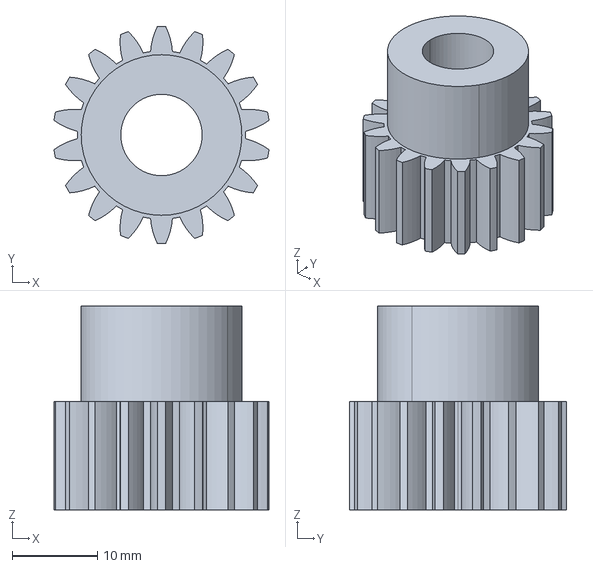
[picture p106: CAD file, 2018-06-28]
Gears/Gear_20P_18T/STEP/gss-2018.stp
25.2 x 25.4 x 23.9 mm
