SnoBotics981/CAD-FirstLibrary/Gears/Gear_20P_20T/STEP/gss-2020.stp

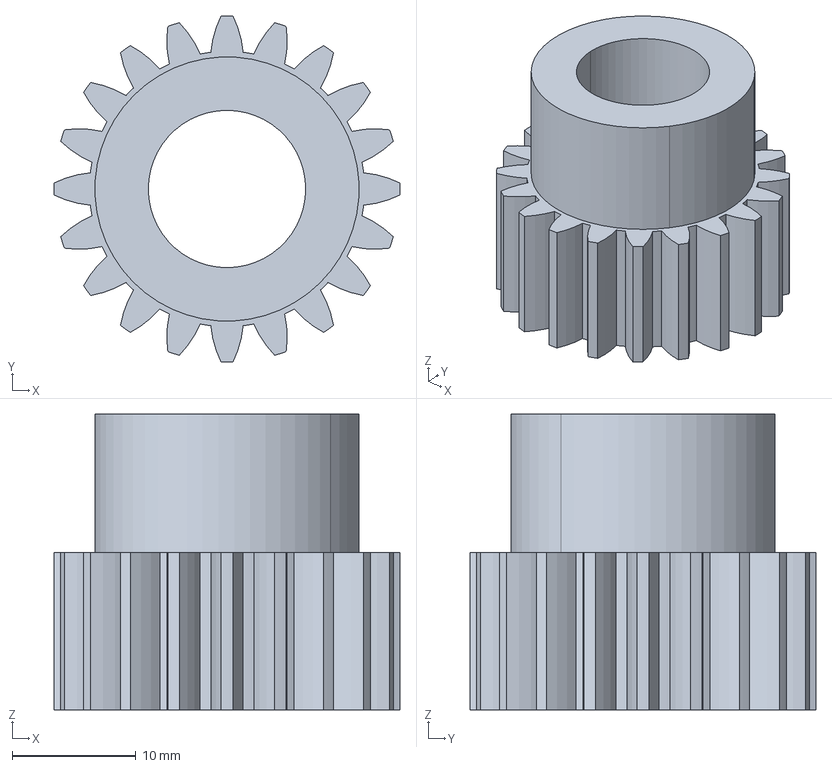
[picture p107: CAD file, 2018-06-28]
Gears/Gear_20P_20T/STEP/gss-2020.stp
27.9 x 27.9 x 23.9 mm
