SnoBotics981/CAD-FirstLibrary/Gears/Gear_20P_24T/STEP/gss-2024.stp

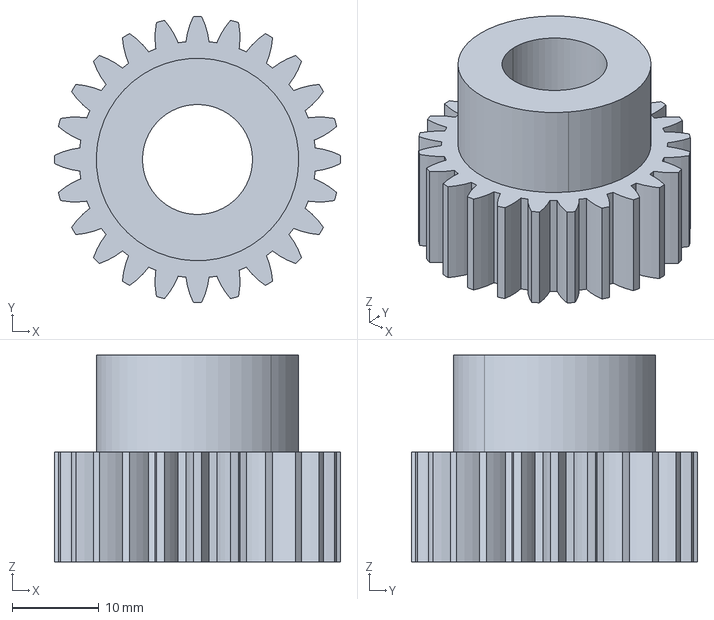
[picture p108: CAD file, 2018-06-28]
Gears/Gear_20P_24T/STEP/gss-2024.stp
33.0 x 33.0 x 23.9 mm
