SnoBotics981/CAD-FirstLibrary/Gears/Gear_20P_25T/STEP/gss-2025.stp

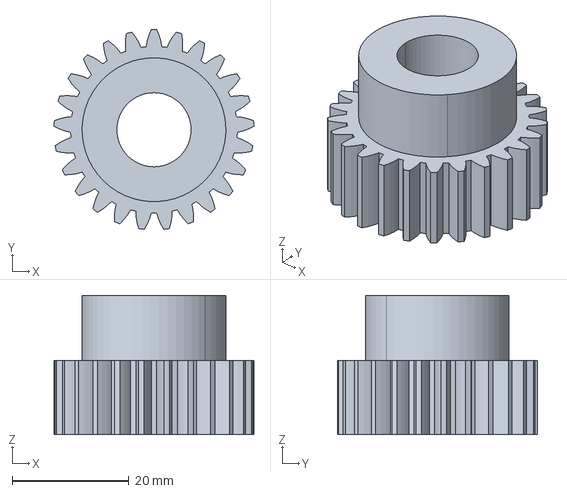
[picture p109: CAD file, 2018-06-28]
Gears/Gear_20P_25T/STEP/gss-2025.stp
34.3 x 34.2 x 23.9 mm
