SnoBotics981/CAD-FirstLibrary/Gears/Gear_20P_30T/STEP/gss-2030.stp

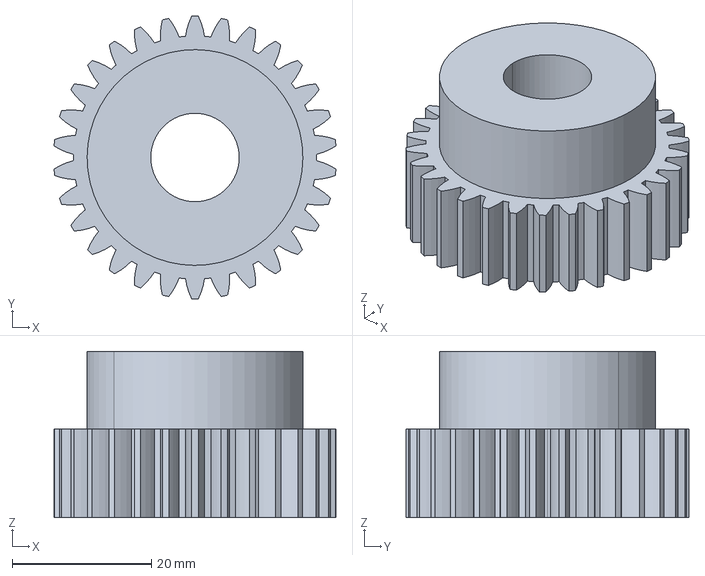
[picture p110: CAD file, 2018-06-28]
Gears/Gear_20P_30T/STEP/gss-2030.stp
40.5 x 40.6 x 23.9 mm
