SnoBotics981/CAD-FirstLibrary/Gears/Gear_20P_35T/STEP/gss-2035.stp

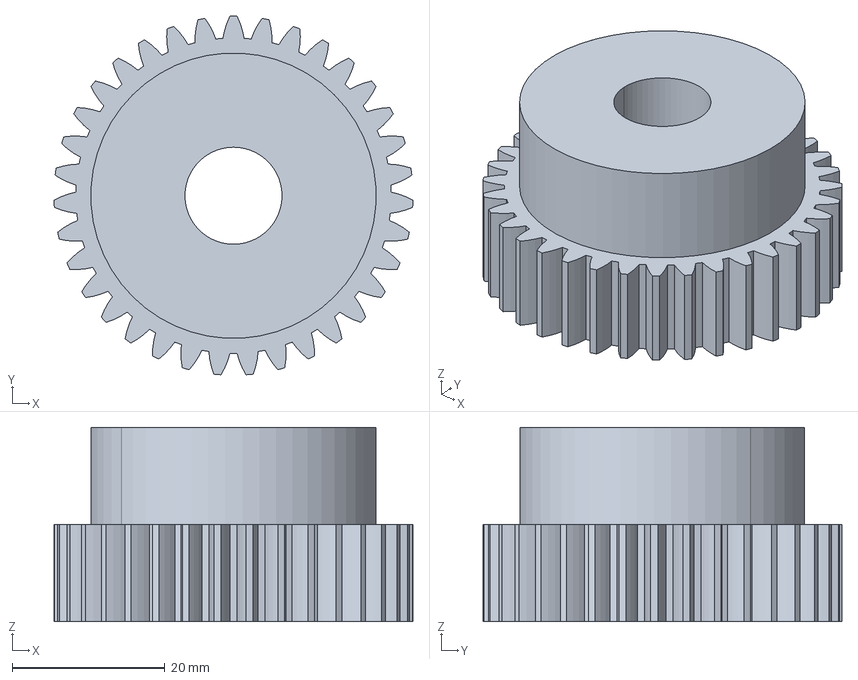
[picture p111: CAD file, 2018-06-28]
Gears/Gear_20P_35T/STEP/gss-2035.stp
47.0 x 46.9 x 25.4 mm
