SnoBotics981/CAD-FirstLibrary/Gears/Gear_20P_40T/STEP/gss-2040.stp

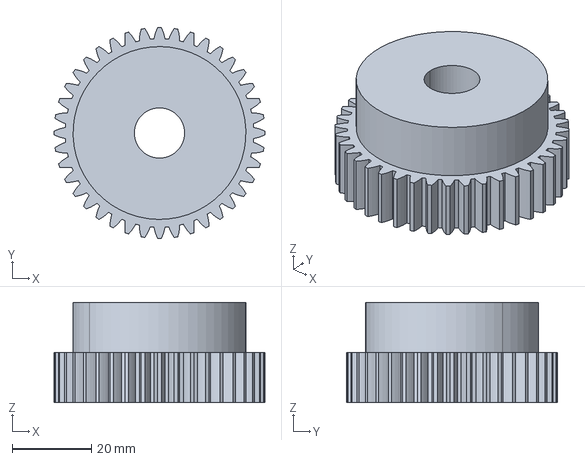
[picture p112: CAD file, 2018-06-28]
Gears/Gear_20P_40T/STEP/gss-2040.stp
53.3 x 53.3 x 25.4 mm
