SnoBotics981/CAD-FirstLibrary/Gears/Gear_20P_45T/STEP/gss-2045.stp

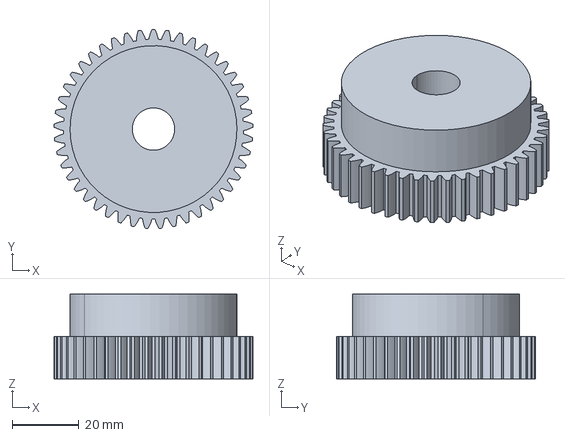
[picture p113: CAD file, 2018-06-28]
Gears/Gear_20P_45T/STEP/gss-2045.stp
59.7 x 59.6 x 25.4 mm
