SnoBotics981/CAD-FirstLibrary/Gears/Gear_20P_50T/STEP/gss-2050.stp

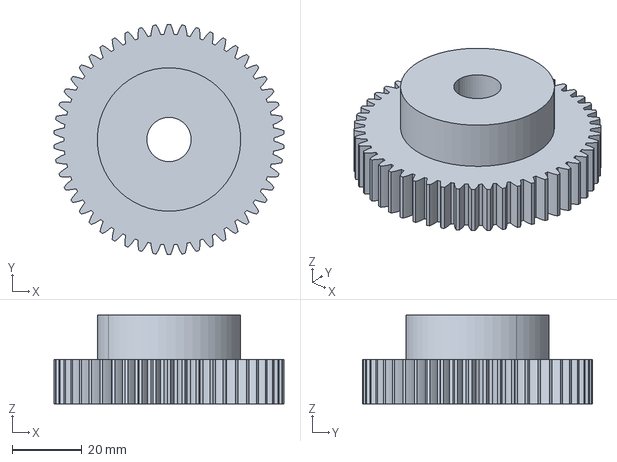
[picture p114: CAD file, 2018-06-28]
Gears/Gear_20P_50T/STEP/gss-2050.stp
66.0 x 66.0 x 25.4 mm
