SnoBotics981/CAD-FirstLibrary/Gears/Gear_20P_60T/STEP/gss-2060.stp

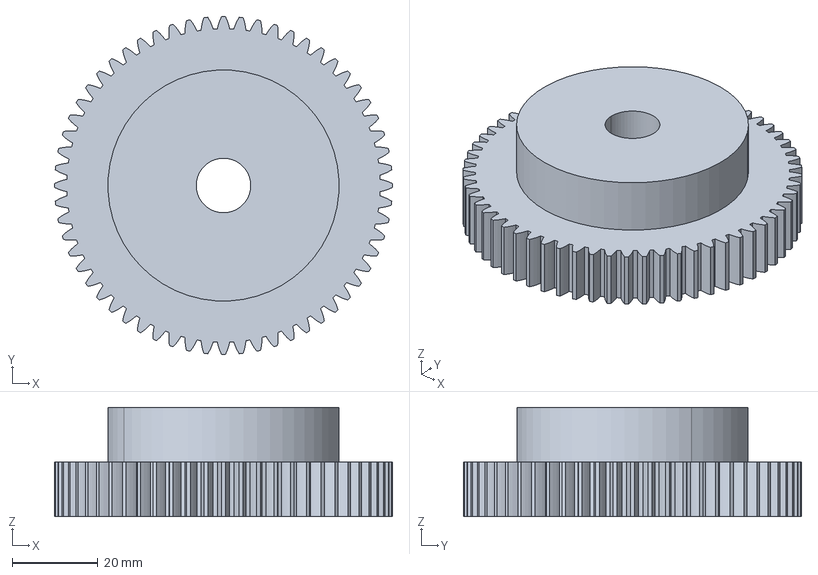
[picture p115: CAD file, 2018-06-28]
Gears/Gear_20P_60T/STEP/gss-2060.stp
78.7 x 78.7 x 25.4 mm
