SnoBotics981/CAD-FirstLibrary/Gears/Gear_20P_70T/STEP/gss-2070.stp

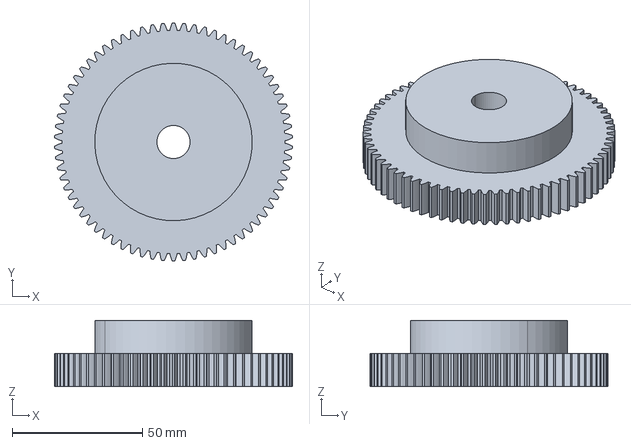
[picture p116: CAD file, 2018-06-28]
Gears/Gear_20P_70T/STEP/gss-2070.stp
91.4 x 91.4 x 25.4 mm
