SnoBotics981/CAD-FirstLibrary/Gears/Gear_32P_32T/STEP/gbs-3232.stp

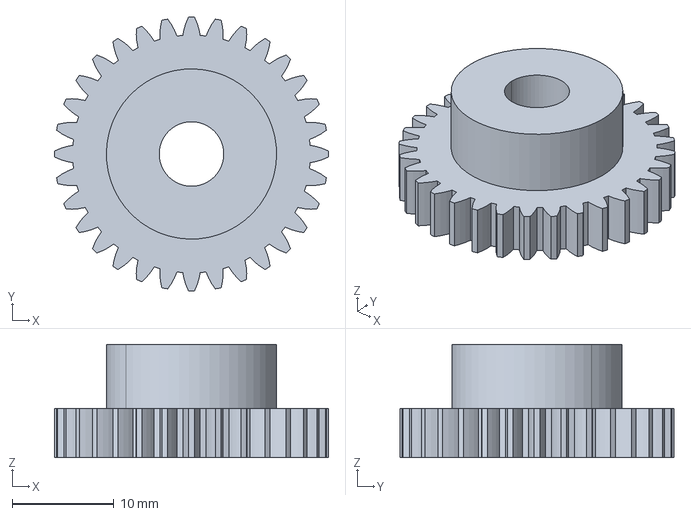
[picture p117: CAD file, 2018-06-28]
Gears/Gear_32P_32T/STEP/gbs-3232.stp
27.0 x 27.0 x 11.2 mm
