SnoBotics981/CAD-FirstLibrary/Gears/Gear_32P_96T/STEP/gbs-3296.stp

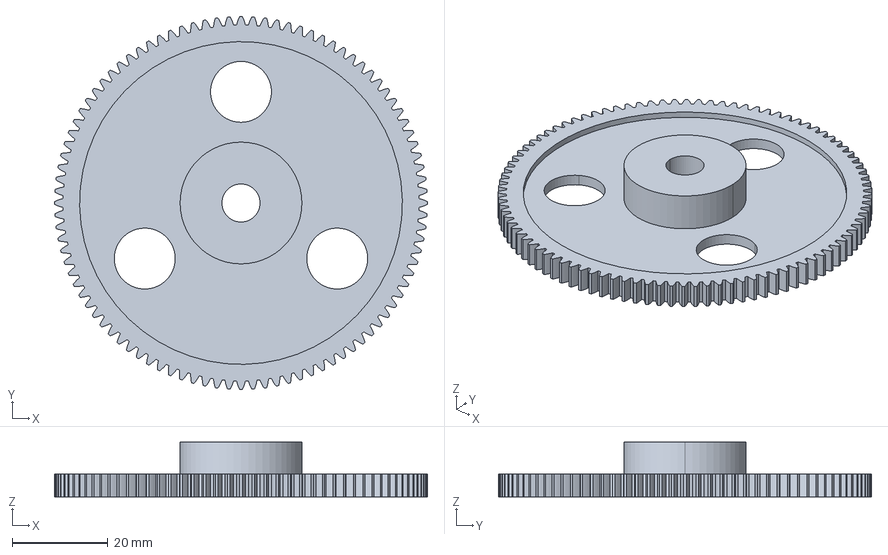
[picture p118: CAD file, 2018-06-28]
Gears/Gear_32P_96T/STEP/gbs-3296.stp
77.8 x 77.8 x 11.4 mm
