SnoBotics981/CAD-FirstLibrary/Gears/Globe_Motor_Pinion/STEP/globepinion.stp

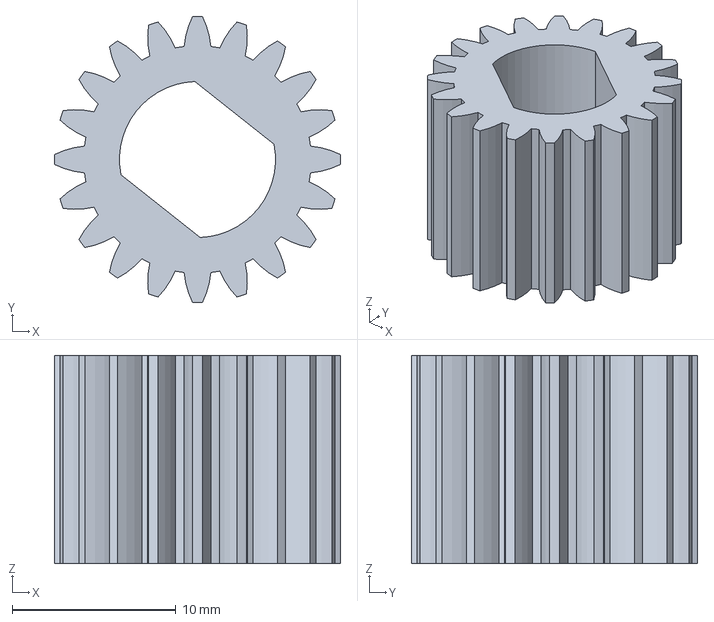
[picture p119: CAD file, 2018-06-28]
Gears/Globe_Motor_Pinion/STEP/globepinion.stp
17.5 x 17.5 x 12.7 mm
