SnoBotics981/CAD-FirstLibrary/Gears/Large_Cluster_40T/STEP/AM-0024.stp

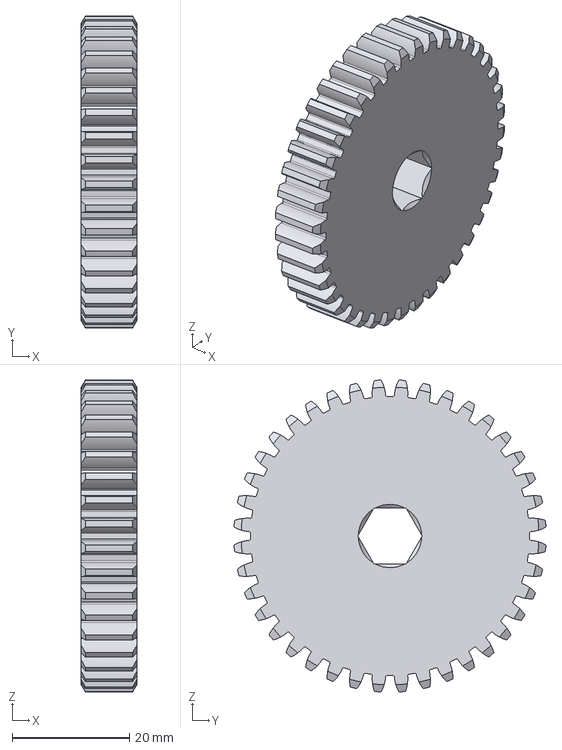
[picture p120: CAD file, 2018-06-28]
Gears/Large_Cluster_40T/STEP/AM-0024.stp
9.53 x 53.3 x 53.3 mm
