SnoBotics981/CAD-FirstLibrary/Gears/Large_Cluster_50T/STEP/AM-0037.stp

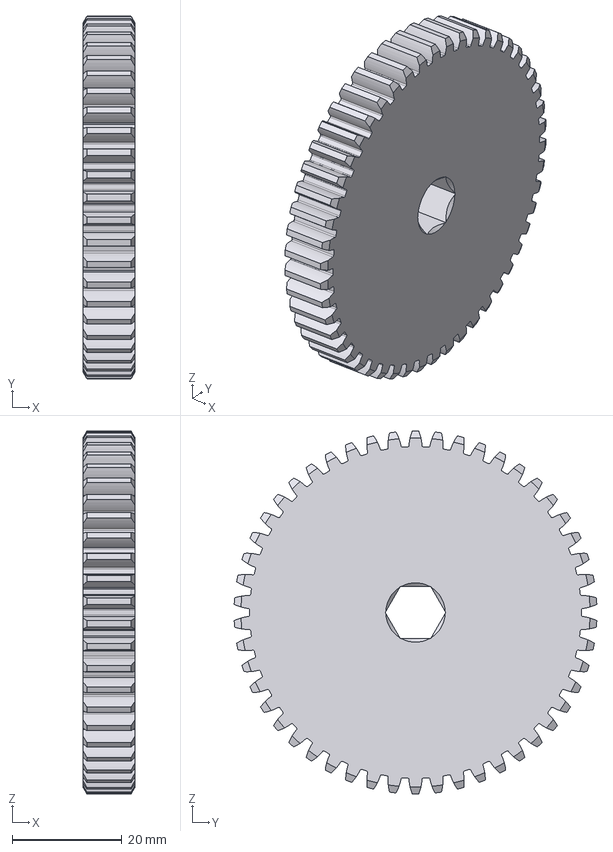
[picture p121: CAD file, 2018-06-28]
Gears/Large_Cluster_50T/STEP/AM-0037.stp
9.53 x 66.0 x 66.0 mm
