SnoBotics981/CAD-FirstLibrary/Gears/Large_Final_45T/STEP/AM-0129a.stp

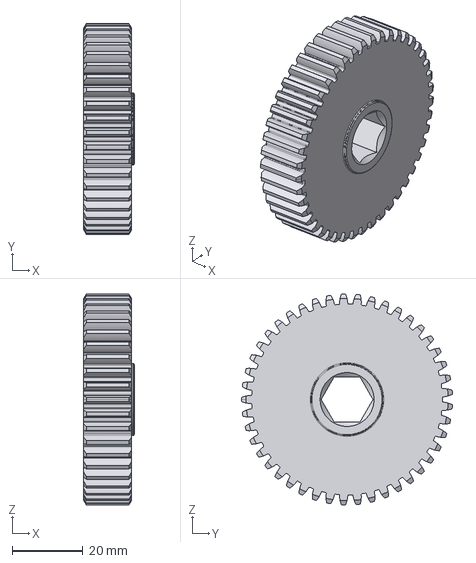
[picture p122: CAD file, 2018-06-28]
Gears/Large_Final_45T/STEP/AM-0129a.stp
14.3 x 59.7 x 59.7 mm
