SnoBotics981/CAD-FirstLibrary/Gears/Large_Final_48T/STEP/AM-0128a.stp

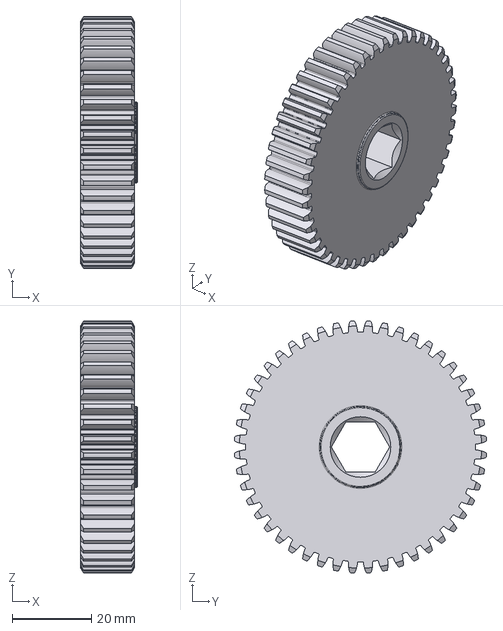
[picture p123: CAD file, 2018-06-28]
Gears/Large_Final_48T/STEP/AM-0128a.stp
14.3 x 63.4 x 63.4 mm
