SnoBotics981/CAD-FirstLibrary/Gears/Large_Output_48T/STEP/AM-0022.stp

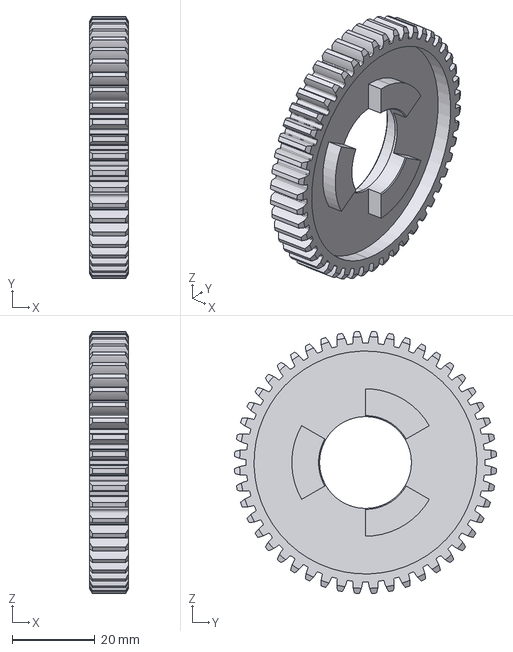
[picture p124: CAD file, 2018-06-28]
Gears/Large_Output_48T/STEP/AM-0022.stp
9.53 x 63.4 x 63.4 mm
