SnoBotics981/CAD-FirstLibrary/Gears/Medium_Cluster_28T/STEP/AM-0025.stp

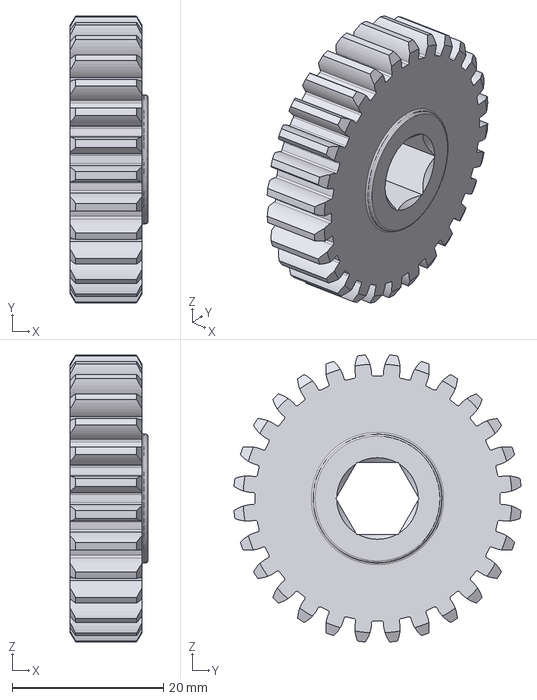
[picture p125: CAD file, 2018-06-28]
Gears/Medium_Cluster_28T/STEP/AM-0025.stp
10.3 x 38.0 x 38.0 mm
