SnoBotics981/CAD-FirstLibrary/Gears/Medium_Cluster_35T/STEP/AM-0140.stp

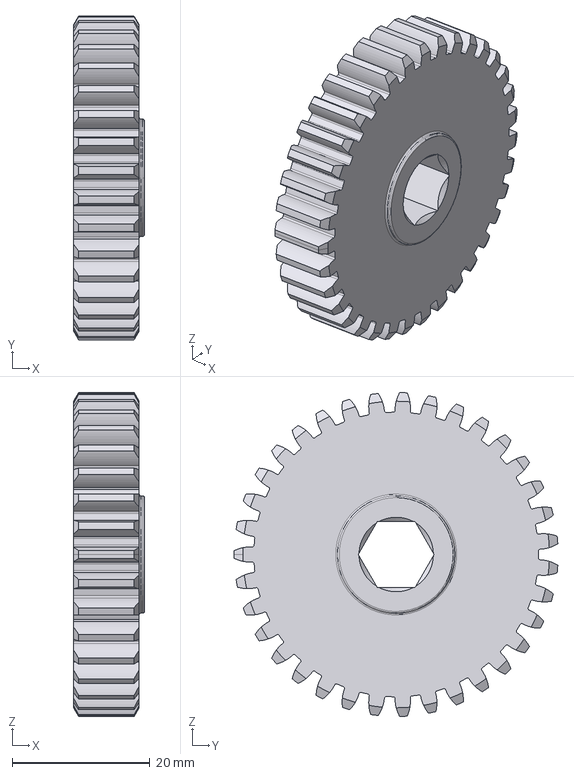
[picture p126: CAD file, 2018-06-28]
Gears/Medium_Cluster_35T/STEP/AM-0140.stp
10.3 x 46.9 x 47.0 mm
