SnoBotics981/CAD-FirstLibrary/Gears/Small_Cluster_14T/STEP/AM-0039.stp

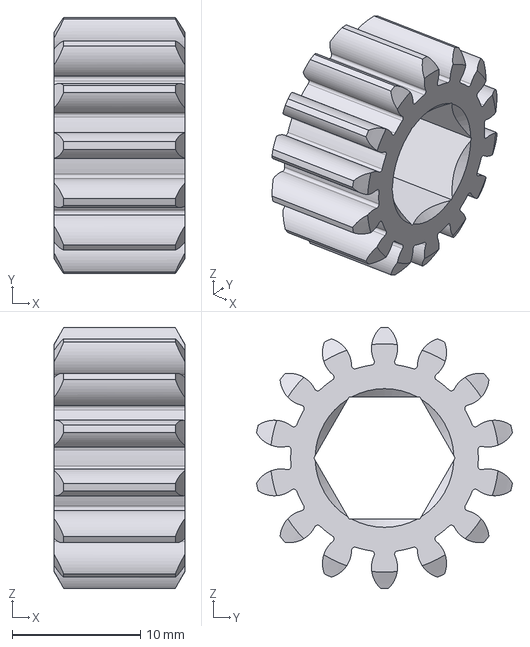
[picture p127: CAD file, 2018-06-28]
Gears/Small_Cluster_14T/STEP/AM-0039.stp
10.2 x 19.9 x 20.3 mm
