SnoBotics981/CAD-FirstLibrary/Gears/Small_Cluster_15T/STEP/AM-0130.stp

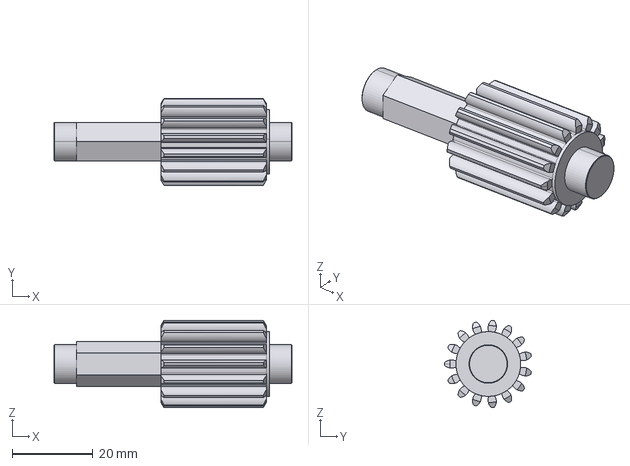
[picture p128: CAD file, 2018-06-28]
Gears/Small_Cluster_15T/STEP/AM-0130.stp
58.8 x 21.4 x 21.5 mm
