SnoBotics981/CAD-FirstLibrary/Gears/Small_Final_17T/STEP/AM-0128b.stp

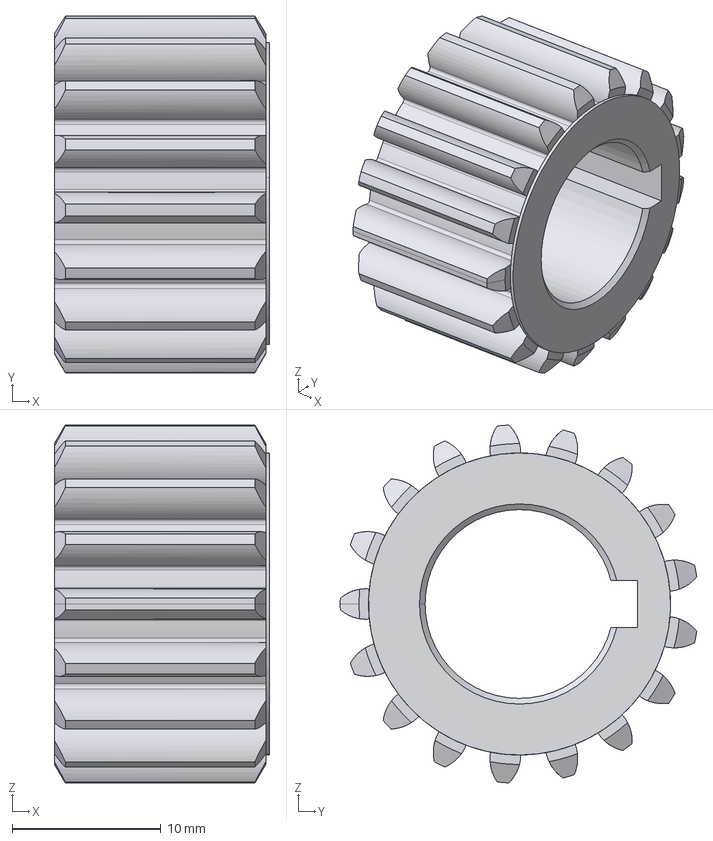
[picture p129: CAD file, 2018-06-28]
Gears/Small_Final_17T/STEP/AM-0128b.stp
14.5 x 24.0 x 24.1 mm
