SnoBotics981/CAD-FirstLibrary/Gears/Small_Final_20T/STEP/AM-0129b.stp

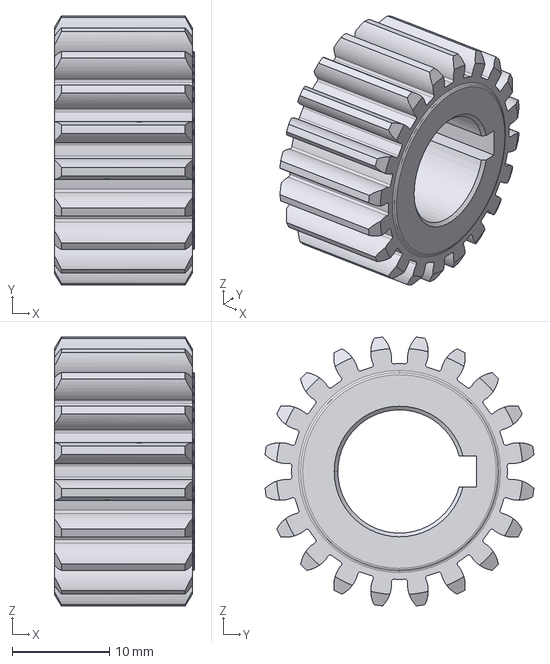
[picture p130: CAD file, 2018-06-28]
Gears/Small_Final_20T/STEP/AM-0129b.stp
14.5 x 27.7 x 27.7 mm
