SnoBotics981/CAD-FirstLibrary/Gears/Small_Output_28T/STEP/AM-0139.stp

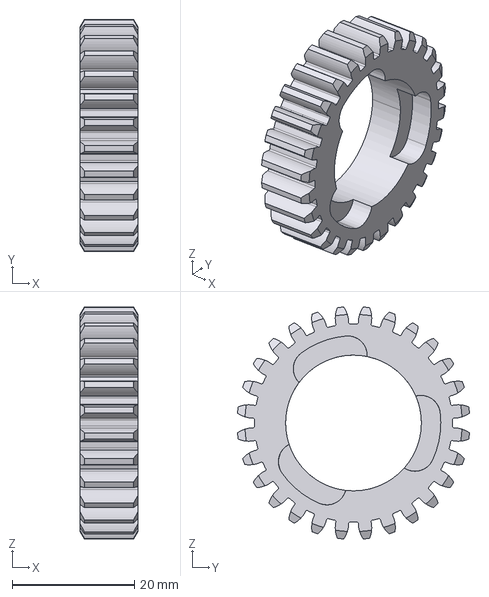
[picture p131: CAD file, 2018-06-28]
Gears/Small_Output_28T/STEP/AM-0139.stp
9.53 x 38.0 x 38.0 mm
