SnoBotics981/CAD-FirstLibrary/Gears/Small_Output_35T/STEP/AM-0023.stp

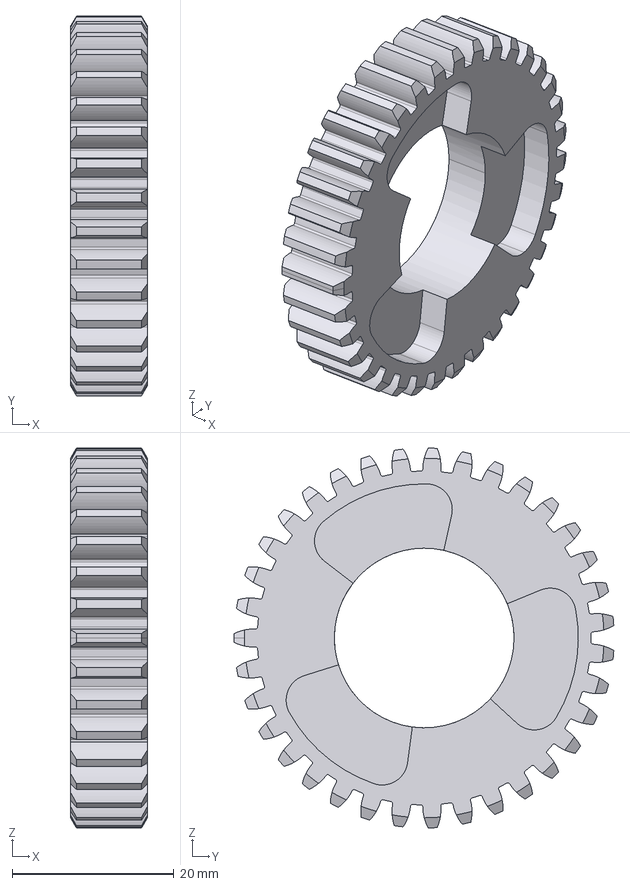
[picture p132: CAD file, 2018-06-28]
Gears/Small_Output_35T/STEP/AM-0023.stp
9.53 x 46.9 x 47.0 mm
