SnoBotics981/CAD-FirstLibrary/Gears/Sun_15T/STEP/AM-0040.stp

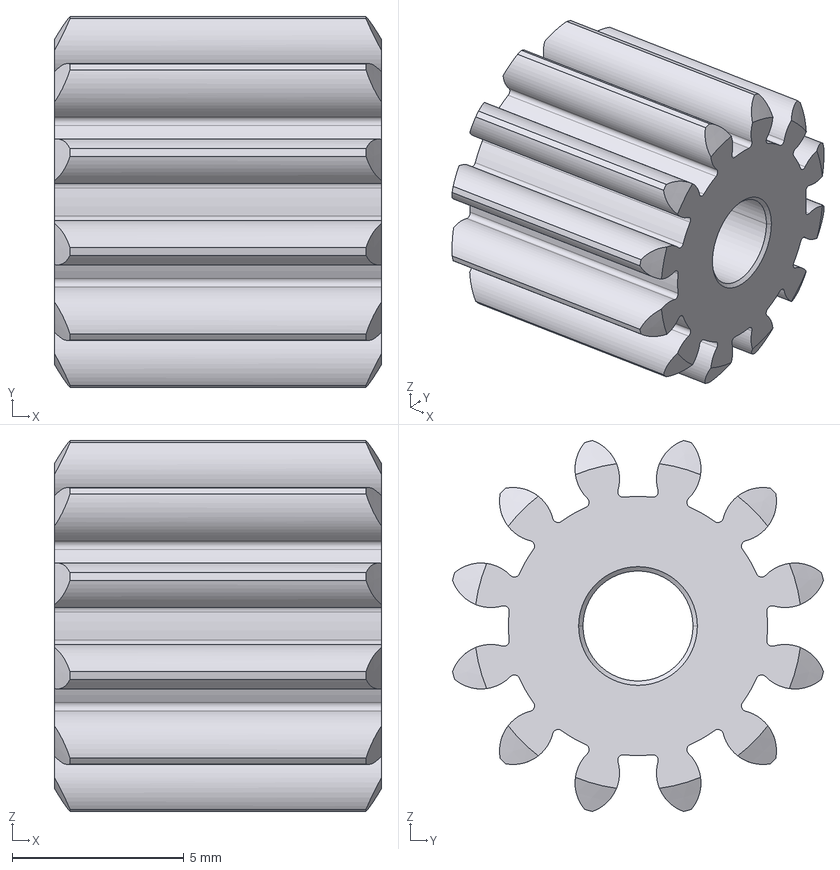
[picture p133: CAD file, 2018-06-28]
Gears/Sun_15T/STEP/AM-0040.stp
9.53 x 10.8 x 10.8 mm
