SnoBotics981/CAD-FirstLibrary/Manufactured/3.4_Shaft_Adapter/STEP/shaftadapter.stp

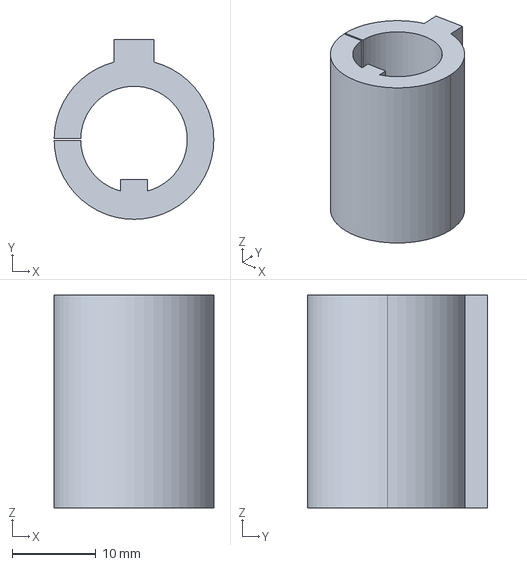
[picture p134: CAD file, 2018-06-28]
Manufactured/3.4_Shaft_Adapter/STEP/shaftadapter.stp
19.0 x 21.4 x 25.4 mm
