SnoBotics981/CAD-FirstLibrary/Manufactured/Cable_Pulley/STEP/cablepulley.stp

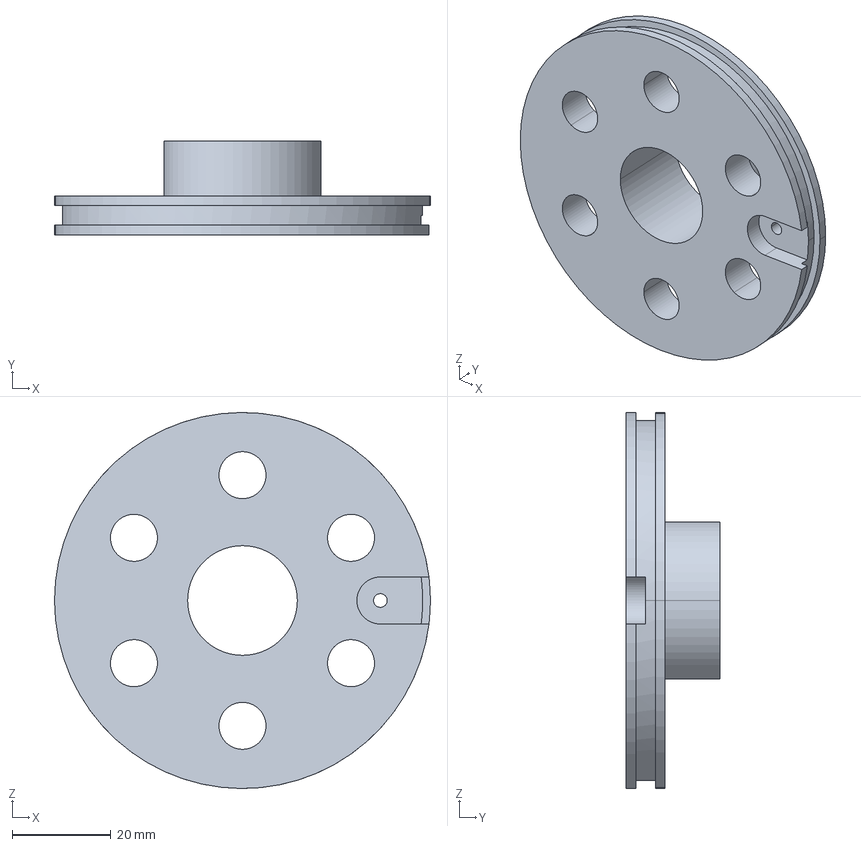
[picture p135: CAD file, 2018-06-28]
Manufactured/Cable_Pulley/STEP/cablepulley.stp
76.2 x 19.1 x 76.2 mm
