SnoBotics981/CAD-FirstLibrary/Manufactured/Encoder_Adapter/STEP/Gearbox Encoder Adapter.stp

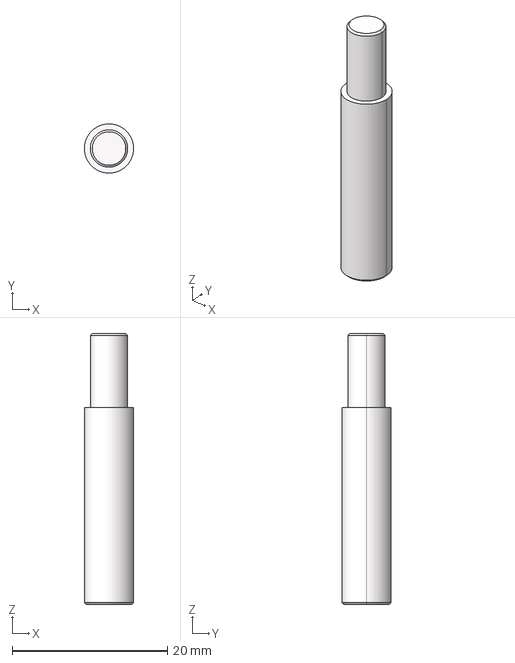
[picture p136: CAD file, 2018-06-28]
Manufactured/Encoder_Adapter/STEP/Gearbox Encoder Adapter.stp
6.35 x 6.35 x 34.9 mm
