SnoBotics981/CAD-FirstLibrary/Manufactured/Encoder_Bracket/STEP/Encoder Bracket.stp

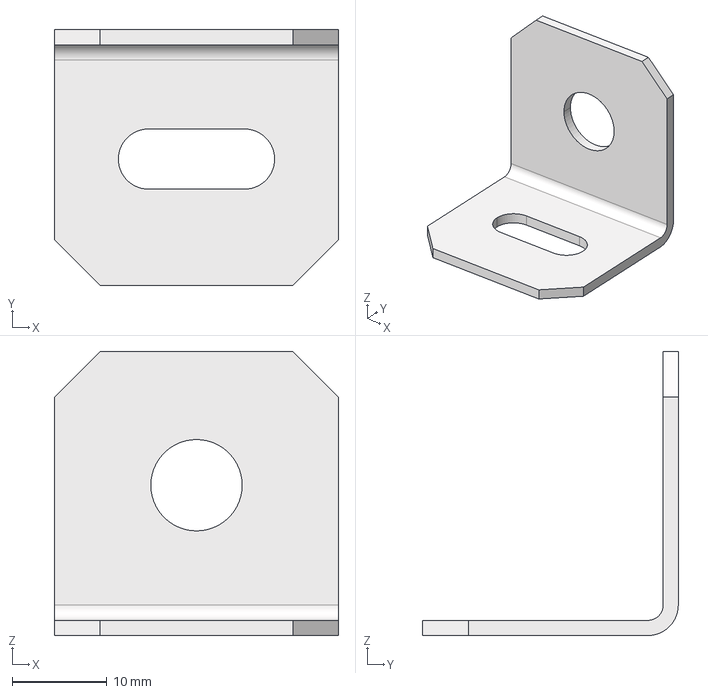
[picture p137: CAD file, 2018-06-28]
Manufactured/Encoder_Bracket/STEP/Encoder Bracket.stp
30.0 x 27.0 x 30.0 mm
