SnoBotics981/CAD-FirstLibrary/Manufactured/Extrusion_Roller/STEP/extrusionroller.stp

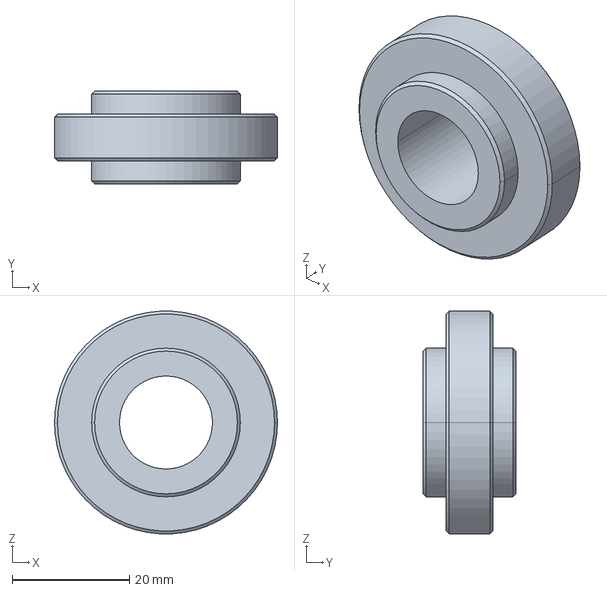
[picture p138: CAD file, 2018-06-28]
Manufactured/Extrusion_Roller/STEP/extrusionroller.stp
38.1 x 15.9 x 38.0 mm
