SnoBotics981/CAD-FirstLibrary/Manufactured/High_Speed_Spacer/STEP/highspeedring.stp

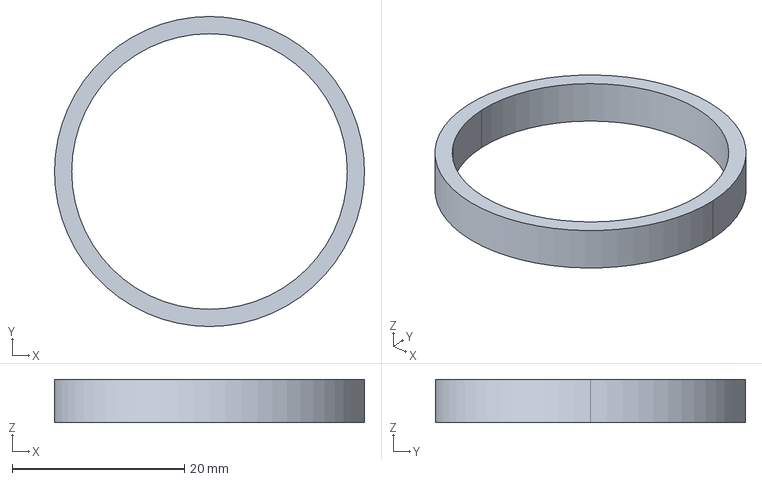
[picture p139: CAD file, 2018-06-28]
Manufactured/High_Speed_Spacer/STEP/highspeedring.stp
36.0 x 36.0 x 5.00 mm
