SnoBotics981/CAD-FirstLibrary/Manufactured/Hitch_Bracket/STEP/hitchbracket.stp

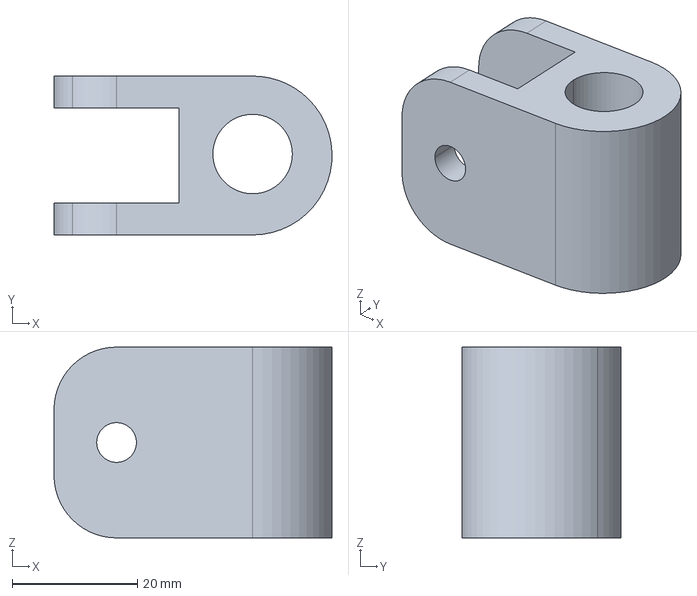
[picture p140: CAD file, 2018-06-28]
Manufactured/Hitch_Bracket/STEP/hitchbracket.stp
44.4 x 25.4 x 30.5 mm
