SnoBotics981/CAD-FirstLibrary/Manufactured/Low_Speed_Spacer/STEP/lowspeedring.stp

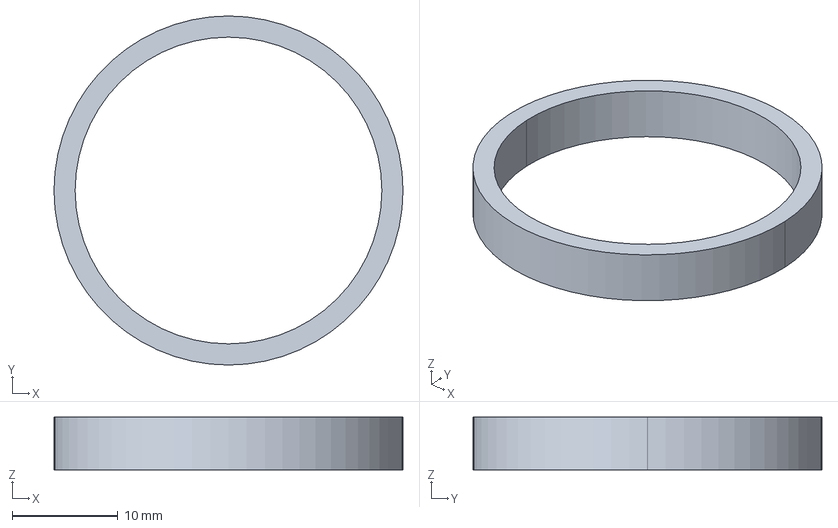
[picture p141: CAD file, 2018-06-28]
Manufactured/Low_Speed_Spacer/STEP/lowspeedring.stp
33.0 x 33.0 x 5.00 mm
