SnoBotics981/CAD-FirstLibrary/Manufactured/Pillow_Block_H/STEP/pillowblock-H.stp

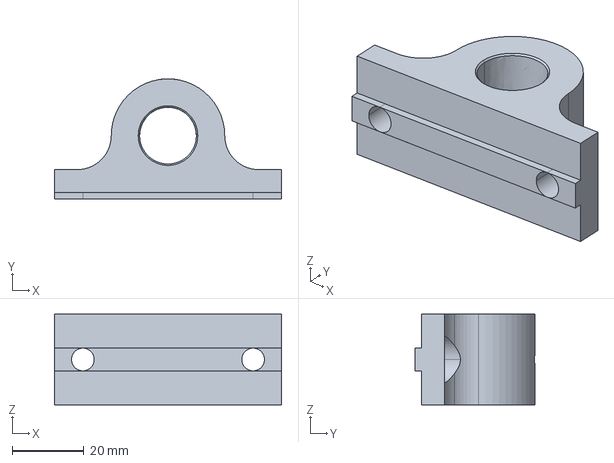
[picture p142: CAD file, 2018-06-28]
Manufactured/Pillow_Block_H/STEP/pillowblock-H.stp
63.5 x 33.7 x 25.4 mm
