SnoBotics981/CAD-FirstLibrary/Manufactured/Pillow_Block_I/STEP/pillowblock-I.stp

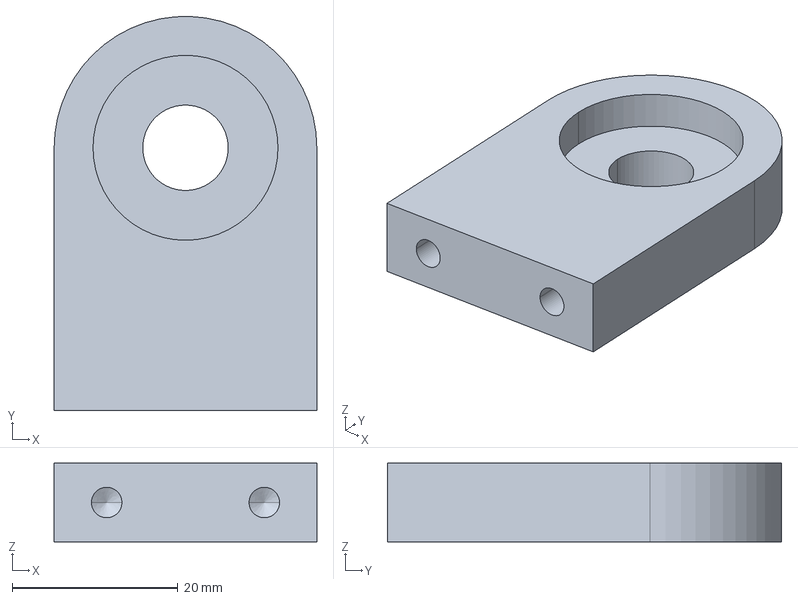
[picture p143: CAD file, 2018-06-28]
Manufactured/Pillow_Block_I/STEP/pillowblock-I.stp
31.8 x 47.6 x 9.53 mm
