SnoBotics981/CAD-FirstLibrary/Manufactured/Pillow_Block_J/STEP/pillowblock-J.stp

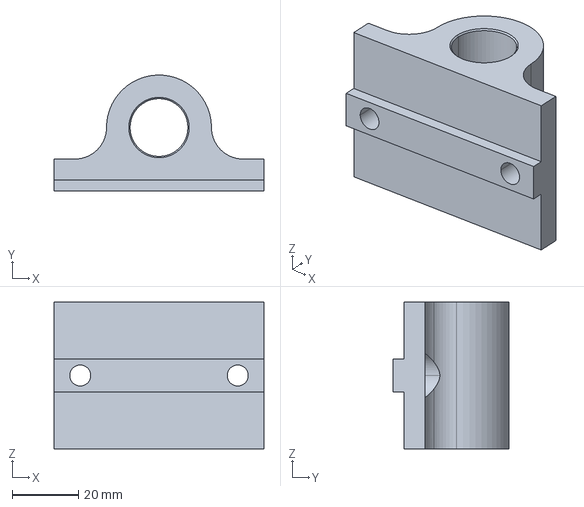
[picture p144: CAD file, 2018-06-28]
Manufactured/Pillow_Block_J/STEP/pillowblock-J.stp
63.5 x 35.0 x 44.5 mm
