SnoBotics981/CAD-FirstLibrary/Manufactured/Spool_Sprocket/STEP/spoolsprocket.stp

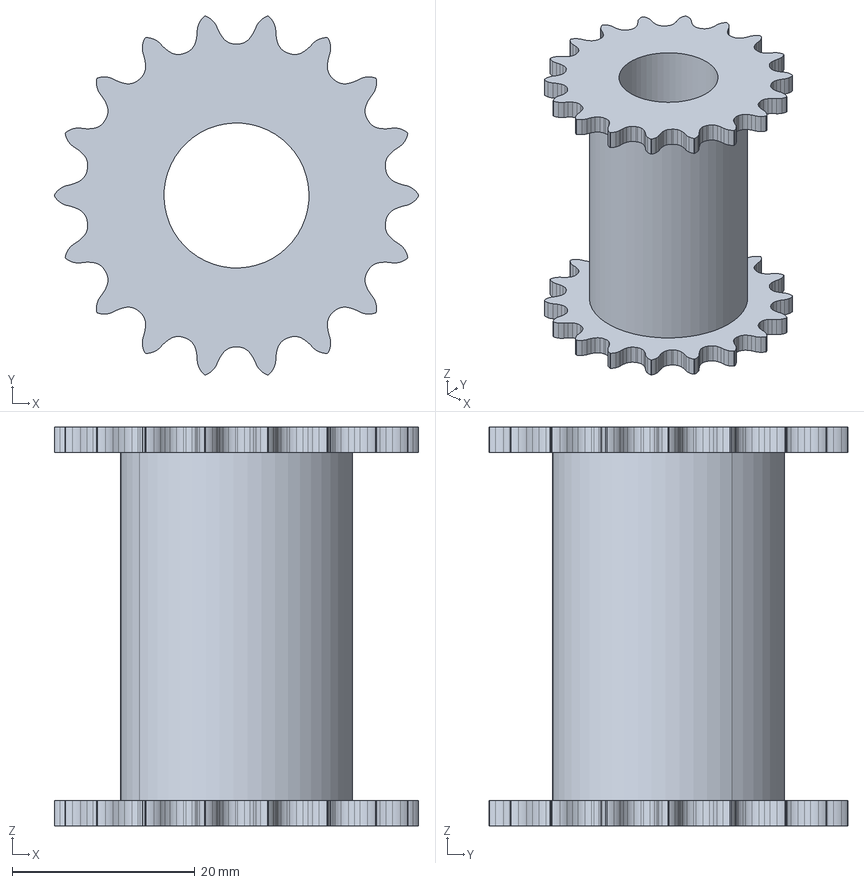
[picture p145: CAD file, 2018-06-28]
Manufactured/Spool_Sprocket/STEP/spoolsprocket.stp
39.9 x 39.3 x 43.7 mm
