SnoBotics981/CAD-FirstLibrary/Manufactured/Sprocket_Spacer/STEP/wheelsprocketspacer.stp

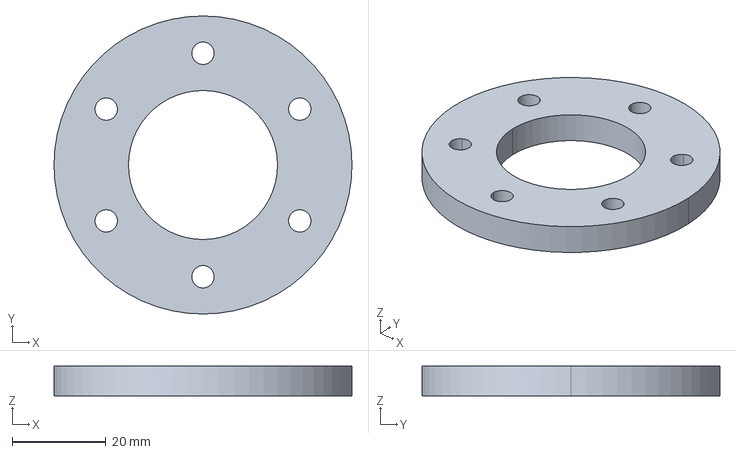
[picture p146: CAD file, 2018-06-28]
Manufactured/Sprocket_Spacer/STEP/wheelsprocketspacer.stp
63.5 x 63.5 x 6.35 mm
