SnoBotics981/CAD-FirstLibrary/Manufactured/Turret_Sprocket/STEP/Turret Sprocket.stp

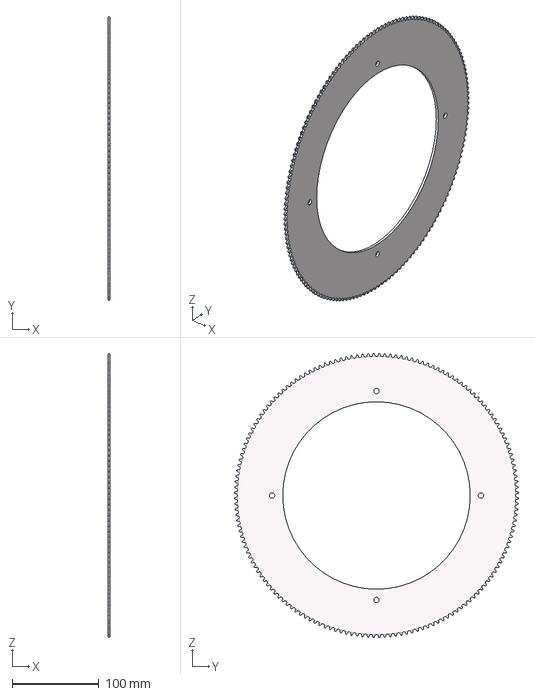
[picture p147: CAD file, 2018-06-28]
Manufactured/Turret_Sprocket/STEP/Turret Sprocket.stp
2.80 x 327.1 x 327.1 mm
