SnoBotics981/CAD-FirstLibrary/Manufactured/Wheel_Hub/STEP/Wheel Hub.stp

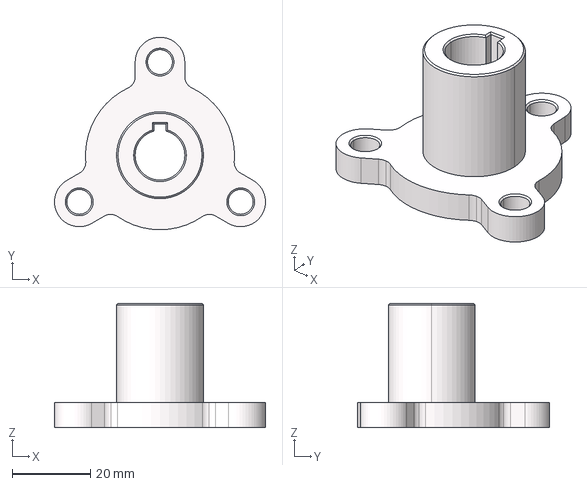
[picture p148: CAD file, 2018-06-28]
Manufactured/Wheel_Hub/STEP/Wheel Hub.stp
54.0 x 49.2 x 31.8 mm
