SnoBotics981/CAD-FirstLibrary/Mechanical/1.2_Ball_Nut/STEP/ballnut.stp

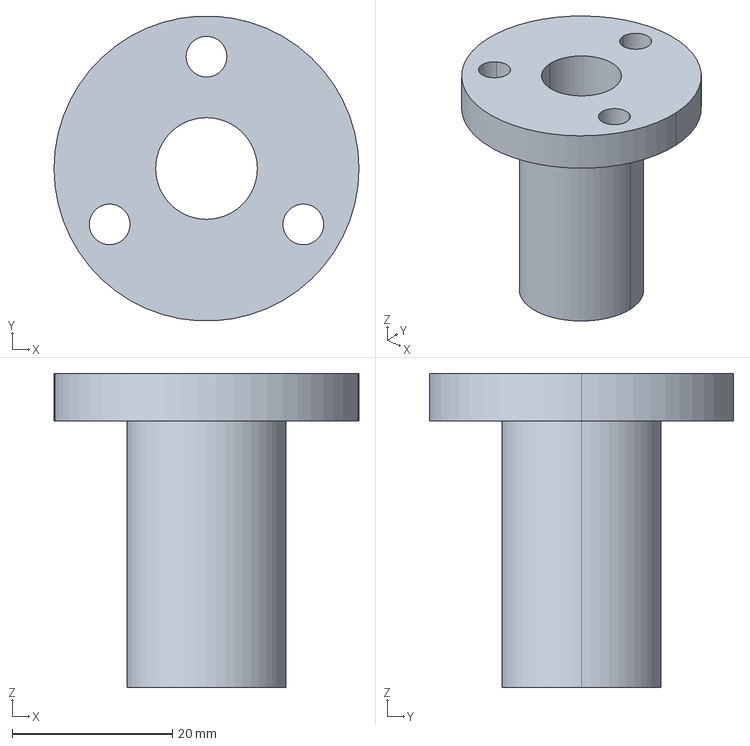
[picture p149: CAD file, 2018-06-28]
Mechanical/1.2_Ball_Nut/STEP/ballnut.stp
38.1 x 38.0 x 39.3 mm
