SnoBotics981/CAD-FirstLibrary/Mechanical/1.2_LoveJoy/STEP/lovejoy_l-050-0500.stp

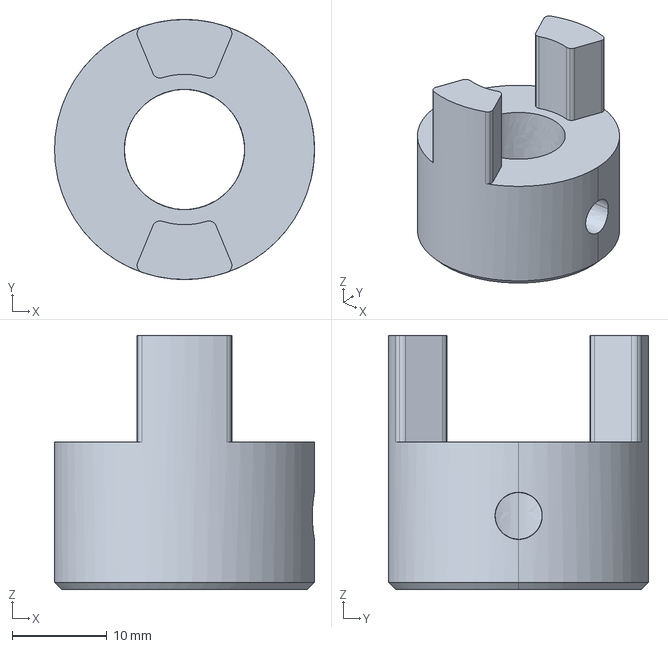
[picture p150: CAD file, 2018-06-28]
Mechanical/1.2_LoveJoy/STEP/lovejoy_l-050-0500.stp
27.4 x 27.4 x 26.8 mm
