SnoBotics981/CAD-FirstLibrary/(list of files, cad)

Other CAD files:
Electrical/IFI_RC_Transmitter/STEP/IFI RC Transmitter.stp
Gears/Large_Output_50T/STEP/AM-0038.stp
Archive/90_deg_Elbow/IGES/kk15-7.igs
Archive/90_deg_Elbow/INV/kk15-7.ipt
Archive/90_deg_Elbow/STEP/kk15-7.stp
Archive/Base_Plate/IGES/kkm58.igs
Archive/Base_Plate/INV/kkm58.ipt
Archive/Base_Plate/STEP/kkm58.stp
Archive/Beacon_Light/STEP/beaconlight.stp
Archive/Belimo_Actuator/INV/belimoactuator.iam
Archive/Belimo_Actuator/STEP/belimoactuator.stp
Archive/Chiapua_Gear/INV/chiapuagear-1.ipt
Archive/Chiapua_Gear/INV/chiapuagear-2.ipt
Archive/Chiapua_Gear/INV/chiapuagear.iam
Archive/Chiapua_Gear/STEP/chiapuagear.stp
Archive/Clamping_Plate/IGES/clampingplate.igs
Archive/Clamping_Plate/INV/clampingplate.ipt
Archive/Clamping_Plate/STEP/clampingplate.stp
Archive/Clutch_Plate/IGES/drillclutchspringring.igs
Archive/Clutch_Plate/INV/drillclutchspringring.ipt
Archive/Clutch_Plate/STEP/drillclutchspringring.stp
Archive/Drill_Motor_Pinion/IGES/drillmotorpinion.igs
Archive/Drill_Motor_Pinion/INV/drillmotorpinion.ipt
Archive/Drill_Motor_Pinion/STEP/drillmotorpinion.stp
Archive/FP_Motor_Pinion/IGES/fppinion.igs
Archive/FP_Motor_Pinion/INV/fppinion.ipt
Archive/FP_Motor_Pinion/STEP/fppinion.stp
Archive/Female_Socket/IGES/kkf50-7.igs
Archive/Female_Socket/INV/kkf50-7.ipt
Archive/Female_Socket/STEP/kkf50-7.stp
Archive/Flange/IGES/kk61-7.igs
Archive/Flange/INV/kk61-7.ipt
Archive/Flange/STEP/kk61-7.stp
Archive/Flange_1-1.4/IGES/Flange1250.igs
Archive/Flange_1-1.4/INV/Flange1250.ipt
Archive/Flange_1-1.4/STEP/Flange1250.stp
Archive/Heavy_Flange/IGES/kk60-7.igs
Archive/Heavy_Flange/INV/kk60-7.ipt
Archive/Heavy_Flange/STEP/kk60-7.stp
Archive/Hirata/IGES/hirata.igs
Archive/Hirata/INV/hirata.ipt
Archive/Hirata/STEP/hirata.stp
Archive/Male_Swivel_Socket/IGES/kkm50-7.igs
Archive/Male_Swivel_Socket/INV/kkm50-7.ipt
Archive/Male_Swivel_Socket/STEP/kkm50-7.stp
Archive/Motor_Interface/IGES/motorinterfaceplate.igs
Archive/Motor_Interface/INV/motorinterfaceplate.ipt
Archive/Motor_Interface/STEP/motorinterfaceplate.stp
Archive/Mounting_Plate/IGES/pillowblockmountingplate.igs
Archive/Mounting_Plate/INV/pillowblockmountingplate.ipt
Archive/Mounting_Plate/STEP/pillowblockmountingplate.stp
Archive/OI_Modem/IGES/oimodem.igs
Archive/OI_Modem/INV/oimodem.iam
Archive/OI_Modem/INV/oimodem1.ipt
Archive/OI_Modem/INV/oimodem2.ipt
Archive/OI_Modem/INV/oimodem3.ipt
Archive/OI_Modem/INV/oimodem4.ipt
Archive/OI_Modem/INV/oimodem5.ipt
Archive/OI_Modem/STEP/oimodem.stp
Archive/Pillow_Block_Half/IGES/pillowblockhalf.igs
Archive/Pillow_Block_Half/INV/pillowblockhalf.ipt
Archive/Pillow_Block_Half/STEP/pillowblockhalf.stp
Archive/Plug/IGES/kk77-7.igs
Archive/Plug/INV/kk77-7.ipt
Archive/Plug/STEP/kk77-7.stp
Archive/RC_Modem/IGES/rcmodem.igs
Archive/RC_Modem/INV/rcmodem.iam
Archive/RC_Modem/INV/rcmodem1.ipt
Archive/RC_Modem/INV/rcmodem2.ipt
Archive/RC_Modem/INV/rcmodem3.ipt
Archive/RC_Modem/INV/rcmodem4.ipt
Archive/RC_Modem/STEP/rcmodem.stp
Archive/Railing_Flange/IGES/kk62-7.igs
Archive/Railing_Flange/INV/kk62-7.ipt
Archive/Railing_Flange/STEP/kk62-7.stp
Archive/Revolving_Light/IGES/revolvinglight2003.igs
Archive/Revolving_Light/INV/revolvinglight2003.ipt
Archive/Revolving_Light/STEP/revolvinglight2003.stp
Archive/Seat_Motor/IGES/seatmotor2.igs
Archive/Seat_Motor/STEP/seatmotor2.stp
Archive/Side_Outlet_Tee/IGES/kk35-7.igs
Archive/Side_Outlet_Tee/INV/kk35-7.ipt
Archive/Side_Outlet_Tee/STEP/kk35-7.stp
Archive/Single_Socket_Tee/IGES/kk10-7.igs
Archive/Single_Socket_Tee/INV/kk10-7.ipt
Archive/Single_Socket_Tee/STEP/kk10-7.stp
Archive/Straight_Coulping/IGES/kk14-7.igs
Archive/Straight_Coulping/INV/kk14-7.ipt
Archive/Straight_Coulping/STEP/kk14-7.stp
Archive/Three_Socket_Tee/IGES/kk25-7.igs
Archive/Three_Socket_Tee/INV/kk25-7.ipt
Archive/Three_Socket_Tee/STEP/kk25-7.stp
Archive/Transmission_1/IGES/transmissionhousing1.igs
Archive/Transmission_1/INV/transmissionhousing1.ipt
Archive/Transmission_1/STEP/transmissionhousing1.stp
Archive/Transmission_2/IGES/transmissionhousing2.igs
Archive/Transmission_2/INV/transmissionhousing2.ipt
Archive/Transmission_2/STEP/transmissionhousing2.stp
Archive/Two_Socket_Cross/IGES/kk26-7.igs
Archive/Two_Socket_Cross/INV/kk26-7.ipt
Archive/Two_Socket_Cross/STEP/kk26-7.stp
Archive/Xmission_Bushing/IGES/transmissionbushing.igs
Archive/Xmission_Bushing/INV/transmissionbushing.ipt
Archive/Xmission_Bushing/STEP/transmissionbushing.stp
Archive/Xmission_Shaft/IGES/transmissionshaft.igs
Archive/Xmission_Shaft/INV/transmissionshaft.ipt
Archive/Xmission_Shaft/STEP/transmissionshaft.stp
Bearings/1.2_Bearing/IGES/br-8.igs
Bearings/1.2_Bearing/INV/br-8.ipt
Bearings/1.2_Flanged/IGES/brf-08.igs
Bearings/1.2_Flanged/INV/brf-08.ipt
Bearings/1.2_Spherical/IGES/bearingspherical0500.igs
Bearings/1.2_Spherical/INV/bearingspherical0500.ipt
Bearings/1.4_Bearing/IGES/br-4.igs
Bearings/1.4_Bearing/INV/br-4.ipt
Bearings/1.4_Flanged/IGES/brf-04.igs
Bearings/1.4_Flanged/INV/brf-04.ipt
Bearings/12_Lazy_Susan/IGES/Lazy Susan Bearing.igs
Bearings/12_Lazy_Susan/INV/Lazy Susan Bearing.ipt
Bearings/1_Bearing/IGES/MTI-16 Iglide M250 Bearing.igs
Bearings/1_Bearing/IGES/RJI-01-16 Drylin R Bearing.igs
Bearings/1_Bearing/INV/MTI-16 Iglide M250 Bearing.ipt
Bearings/1_Bearing/INV/RJI-01-16 Drylin R Bearing.ipt
Bearings/1_Bearing/STEP/MTI-16 Iglide M250 Bearing.stp
Bearings/3.8_Bearing/IGES/br-6.igs
Bearings/3.8_Bearing/INV/br-6.ipt
Bearings/3.8_Flanged/IGES/brf-06.igs
Bearings/3.8_Flanged/INV/brf-06.ipt
Bearings/5.8_Bearing/IGES/BR-10.igs
Bearings/5.8_Bearing/IGES/MTI-10 Iglide M250 Bearing.igs
Bearings/5.8_Bearing/IGES/RJI-01-10 Drylin R Bearing.igs
Bearings/5.8_Bearing/INV/BR-10.ipt
Bearings/5.8_Bearing/INV/MTI-10 Iglide M250 Bearing.ipt
Bearings/5.8_Bearing/INV/RJI-01-10 Drylin R Bearing.ipt
Bearings/5.8_Bearing/STEP/MTI-10 Iglide M250 Bearing.stp
Bearings/5.8_Bearing/STEP/RJI-01-10 Drylin R Bearing.stp
Bearings/Bearing_Flangette/IGES/selfaligningflange.igs
Bearings/Bearing_Flangette/INV/selfaligningflange.ipt
Bearings/Linear_Bearing_1.2/IGES/linearbearing.igs
Bearings/Linear_Bearing_1.2/INV/linearbearing.iam
Bearings/Linear_Bearing_1.2/INV/linearbearing1.ipt
Bearings/Linear_Bearing_1.2/INV/linearbearing2.ipt
Bearings/Locking_Collar/IGES/bearinglockingcollar.igs
Bearings/Locking_Collar/INV/bearinglockingcollar.ipt
Bearings/Thrust_Bearing/IGES/Thrust Bearing.igs
Bearings/Thrust_Bearing/INV/Thrust Bearing.ipt
Bearings/Thrust_Washer/IGES/Thrust Bearing Washer.igs
Bearings/Thrust_Washer/INV/Thrust Bearing Washer.ipt
Bearings/Thrust_Washer/STEP/Thrust Bearing Washer.stp
Bushings/1_x_1_Bearing/IGES/JFI-1618-16 Iglide J Bearing.igs
Bushings/1_x_1_Bearing/INV/JFI-1618-16 Iglide J Bearing.ipt
Bushings/1x_1_Bearing/IGES/JSI-1618-16 Iglide J Bearing.igs
Bushings/1x_1_Bearing/INV/JSI-1618-16 Iglide J Bearing.ipt
Bushings/5.8x_3.4_Bearing/IGES/JFI-1012-12 Iglide J Bearing.igs
Bushings/5.8x_3.4_Bearing/IGES/JSI-1012-12 Iglide J Bearing.igs
Bushings/5.8x_3.4_Bearing/INV/JFI-1012-12 Iglide J Bearing.ipt
Bushings/5.8x_3.4_Bearing/INV/JSI-1012-12 Iglide J Bearing .ipt
Bushings/5.8x_3.4_Bearing/STEP/JSI-1012-12 Iglide J Bearing.stp
Bushings/Flange_Bushing/IGES/bushing-fbb-10-10.igs
Bushings/Flange_Bushing/IGES/bushing-fbb-10-20.igs
Bushings/Flange_Bushing/IGES/bushing-fbb-4-8.igs
Bushings/Flange_Bushing/IGES/bushing-fbb-8-12.igs
Bushings/Flange_Bushing/IGES/bushing-fbb-8-16.igs
Bushings/Flange_Bushing/IGES/bushing-fbb-8-8.igs
Bushings/Flange_Bushing/INV/bushing-fbb-10-10.ipt
Bushings/Flange_Bushing/INV/bushing-fbb-10-20.ipt
Bushings/Flange_Bushing/INV/bushing-fbb-4-8.ipt
Bushings/Flange_Bushing/INV/bushing-fbb-8-12.ipt
Bushings/Flange_Bushing/INV/bushing-fbb-8-16.ipt
Bushings/Flange_Bushing/INV/bushing-fbb-8-8.ipt
Bushings/Flange_Bushing/STEP/bushing-fbb-10-10.stp
Bushings/Flange_Bushing/STEP/bushing-fbb-10-20.stp
Bushings/Flange_Bushing/STEP/bushing-fbb-4-8.stp
Bushings/Flange_Bushing/STEP/bushing-fbb-8-16.stp
Bushings/Flange_Bushing/STEP/bushing-fbb-8-8.stp
Bushings/Flanged_Bushing/INV/Bushing-Flanged.ipt
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
