SnoBotics981/CAD-FirstLibrary/(commit log)

2015-07-13 Removed motors directory so I can rebuild it with git happy file names.
2015-07-14 Update to motors.
2018-06-28 Expanded all of the zip files.
    [0375 RetainingRingExternal.ipt, 0625x3125_roll_pin.ipt, 0932x0750_roll_pin.ipt, 10-24 UNC x 4_ Phillips Pan Head.ipt, 10-32x0500 shcs.ipt, 10-32x2250 shcs.ipt, 1000120.ipt, 1000120.stp]
